Shrey-BM/Convertible-Wheelchair-to-Bed-Transfer-System/Working Photos/maker journey image.jpeg

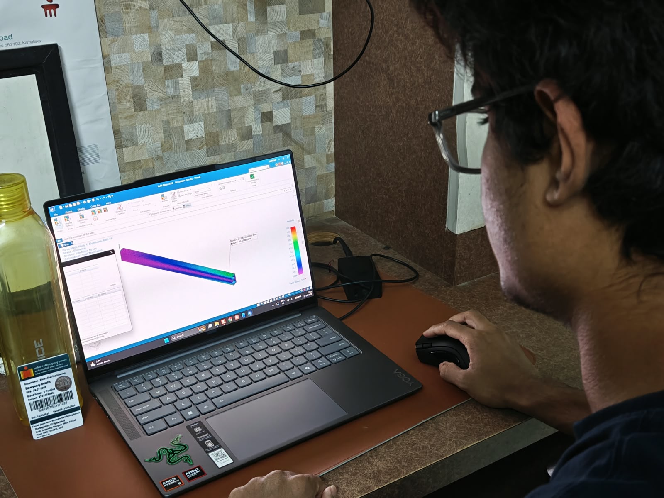
Working Photos/maker journey image.jpeg
