Shrey-BM/Convertible-Wheelchair-to-Bed-Transfer-System/System Architecture and Target Specs/target specs v3.png

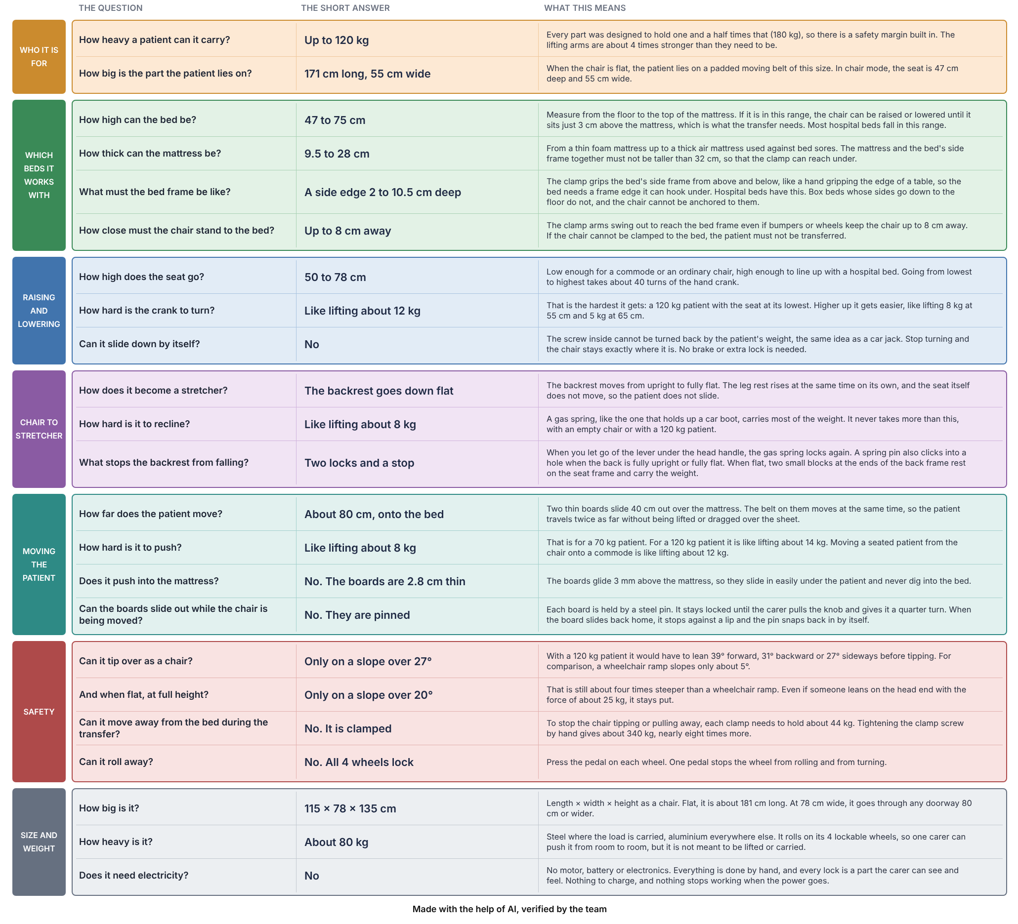
System Architecture and Target Specs/target specs v3.png
