Shrey-BM/Convertible-Wheelchair-to-Bed-Transfer-System/System Architecture and Target Specs/README.md

# System Architecture/Block Diagram
block diagram final

# Target Specifications 
target specs v3
