Shrey-BM/Convertible-Wheelchair-to-Bed-Transfer-System/References/README.md

# References

## 1. Problems with manual lifting

|  | Source | What it tells us |
|---|---|---|
| 1 | [CDC / NIOSH - Safe Patient Handling and Mobility](https://www.cdc.gov/niosh/healthcare/sphm/index.html) | Patient handling is the biggest cause of musculoskeletal injuries in healthcare workers. |
| 2 | [CDC / NIOSH - Preventing Back Injuries in Health Care Settings](https://www.cdc.gov/niosh/bulletin/2008/lifting.html) | Replacing manual lifting with transfer devices cut patient-transfer injuries by 62%. |
| 3 | [OSHA - Guidelines for Nursing Homes: Ergonomics for the Prevention of Musculoskeletal Disorders](https://osha.gov/sites/default/files/publications/final_nh_guidelines.pdf) | Manual lifting of patients should be minimised in all cases and eliminated where possible. |
| 4 | [NICE - Pressure ulcers: prevention and management (CG179)](https://www.nice.org.uk/guidance/cg179) | Dragging a patient during repositioning causes friction and shear damage to the skin. |

## 2. Similar solutions

|  | Source | What it tells us |
|---|---|---|
| 5 | [Panasonic - Resyone, a bed that turns into a wheelchair](https://news.panasonic.com/global/stories/915) | A transfer that needed two or three nurses can be done by one. This solution however needs replacement of the whole bed system. Our wheel chair can be used to transfer patients to/from standard medical beds. |
| 6 | [KosmoCare Electric Lift Patient Transfer Wheelchair](https://www.amazon.in/live/video/1795574dba7f4312b786a8775e35a151) | This solution is useful for sitting to sitting transfer only. |

## 3. Hospital beds and mattresses

|  | Source | What it tells us |
|---|---|---|
| 7 | [UNICEF Supply Catalogue - Hospital bed, standard, with mattress](https://supply.unicef.org/s0002158.html) | Standard bed: 50 cm platform height, 11-12 cm mattress, 5-7 cm frame tubes. |
| 8 | [MSF Logistics catalogue - Hospital bed, manual, adult](https://unicat.msf.org/cat/product/77026) | Manual hospital beds adjust from 45 to 84 cm in height. |
| 9 | [NHSRC - Critical Care Block equipment technical specifications](https://nhsrcindia.org/sites/default/files/2023-09/Critical%20Care%20Block-%20Equipment%20Technical%20Specification.pdf) | Indian ICU beds are 2100-2300 mm long and 900-1100 mm wide. |
| 10 | [Flexequip - Alternating-air mattress, high profile](https://www.flexequip.mndnsw.asn.au/product-library/beds-and-bed-equipment/mattress-replacement-system-alternating-air-high-profile) | Thick pressure-relief air mattresses have cells about 180 mm tall. |
| 11 | [Livingstone - ProCair alternating-pressure mattress](https://www.livingstone.com.au/products/airmatr01s-alternating-pressure-single-mattress-2000x880x200mm-200kg-ea) | A full air mattress is about 200 mm thick. |

## 4. Mechanisms

|  | Source | What it tells us |
|---|---|---|
| 12 | [Wikipedia - Scissors mechanism](https://en.wikipedia.org/wiki/Scissors_mechanism) | How a scissor lift turns a small sideways movement into a large lift. |
| 13 | [Wikipedia - Leadscrew](https://en.wikipedia.org/wiki/Leadscrew) | How a lead screw works and when it is self-locking. |
| 14 | [igus - Self-locking: what is it?](https://www.igus.eu/threaded-rod/wiki/self-locking) | Why a shallow screw thread cannot be turned back by the load. |
| 15 | [Lesjöfors - How do lockable gas springs work?](https://www.lesjofors.com/en/technology/insights/gas-spring-locking-mechanism/) | How a lockable gas spring holds its position and is released by a lever or cable. |
| 16 | [HIWIN - Linear Guideway technical catalogue](https://hiwin.com/wp-content/uploads/Linear_Guideway-E.pdf) | Sizes and load ratings of linear guides, including the MGN15 series. |
| 17 | [KHK Gears - Gear technical reference](https://khkgears.us/media/izojpong/gear_guide1.pdf) | Rack and pinion basics, tooth strength and plastic gears. |
| 18 | [Marcos Duarte - Body segment parameters](https://nbviewer.jupyter.org/github/demotu/BMC/blob/master/notebooks/BodySegmentParameters.ipynb) | How body weight is spread over the head, trunk and legs. |
