Shrey-BM/Convertible-Wheelchair-to-Bed-Transfer-System/Roadmap/README.md

# Roadmap
Roadmap
