Shrey-BM/Convertible-Wheelchair-to-Bed-Transfer-System/CAD Files/Subsystems/README.md

# ALL CAD FILES ARE AI GENERATED AND VERIFIED BY THE TEAM
