Shrey-BM/Convertible-Wheelchair-to-Bed-Transfer-System/Mechanism/Subsystem 2-Gas Spring Recliner/README.md

# Subsystem 2-Gas Spring Recliner
This is the system which helps in reclining the wheel chair and convert it to a stretcher and vice-versa.

## 3D Model
Subsystem 2-Gas Spring Recliner CAD

## Working Principle Image
Subsystem 2-Gas Spring Recliner

## Working Principle Video
[Reclining Mechanism](https://drive.google.com/file/d/1dd5fohbwBtpYMCMEX26W9-bRa6JwPkFz/view?usp=drive_link)
