Shrey-BM/Convertible-Wheelchair-to-Bed-Transfer-System/Mechanism/Subsystem 1-Scissor Lift/Subsystem 1-Scissor Lift CAD.png

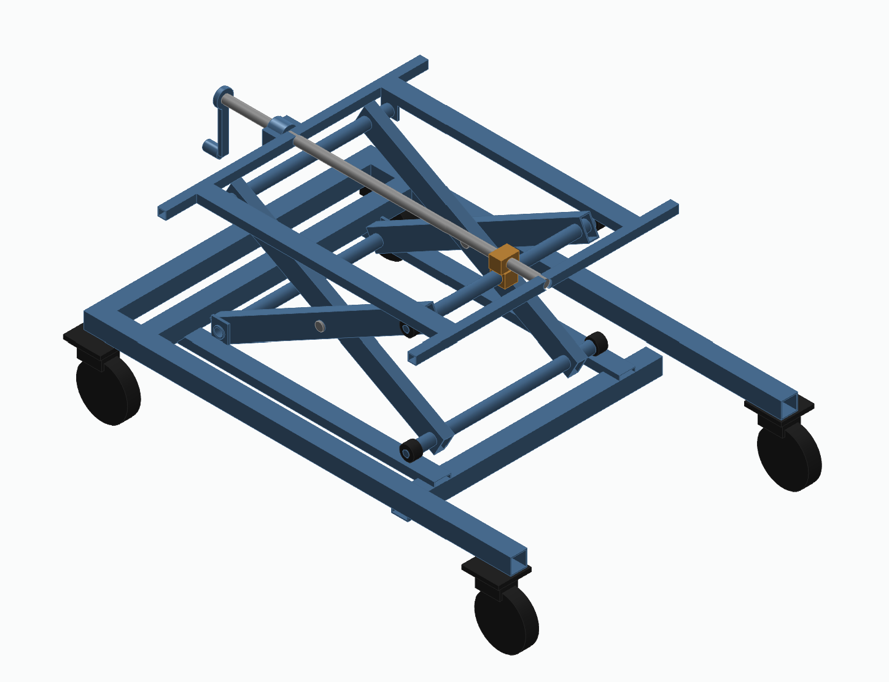
Mechanism/Subsystem 1-Scissor Lift/Subsystem 1-Scissor Lift CAD.png
