Shrey-BM/Convertible-Wheelchair-to-Bed-Transfer-System/Mechanism/Subsystem 1-Scissor Lift/Subsystem 1-Scissor Lift.jpg

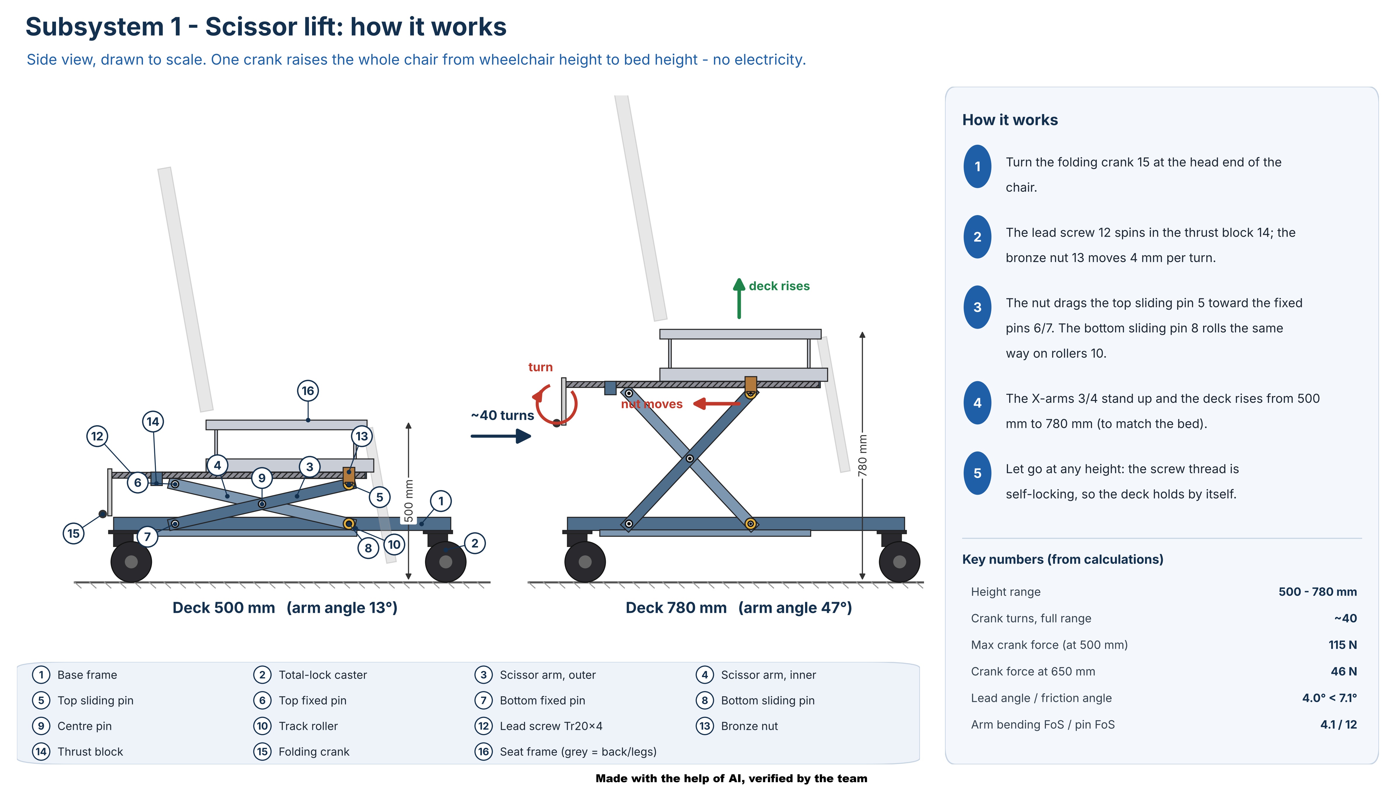
Mechanism/Subsystem 1-Scissor Lift/Subsystem 1-Scissor Lift.jpg
