Shrey-BM/Convertible-Wheelchair-to-Bed-Transfer-System/Mechanism/Subsystem 2-Gas Spring Recliner/Subsystem 2-Gas Spring Recliner CAD.png

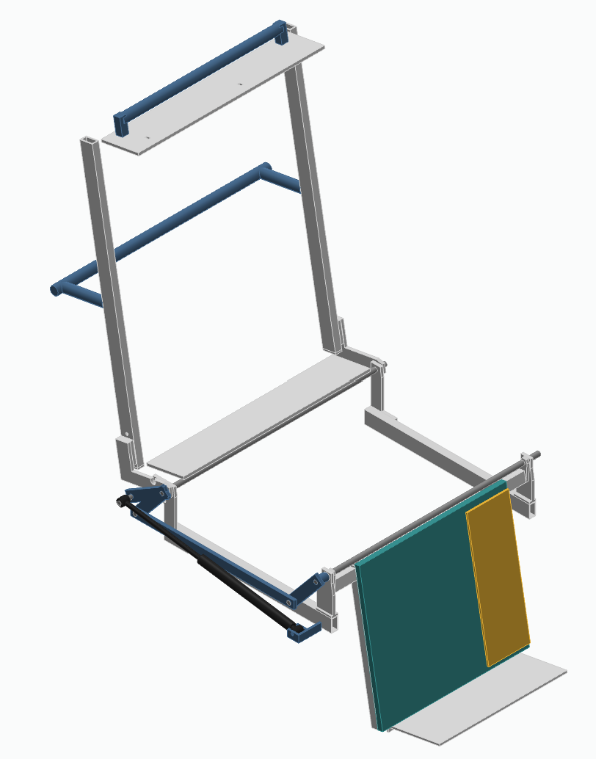
Mechanism/Subsystem 2-Gas Spring Recliner/Subsystem 2-Gas Spring Recliner CAD.png
