Shrey-BM/Convertible-Wheelchair-to-Bed-Transfer-System/Mechanism/Subsystem 2-Gas Spring Recliner/Subsystem 2-Gas Spring Recliner.jpg

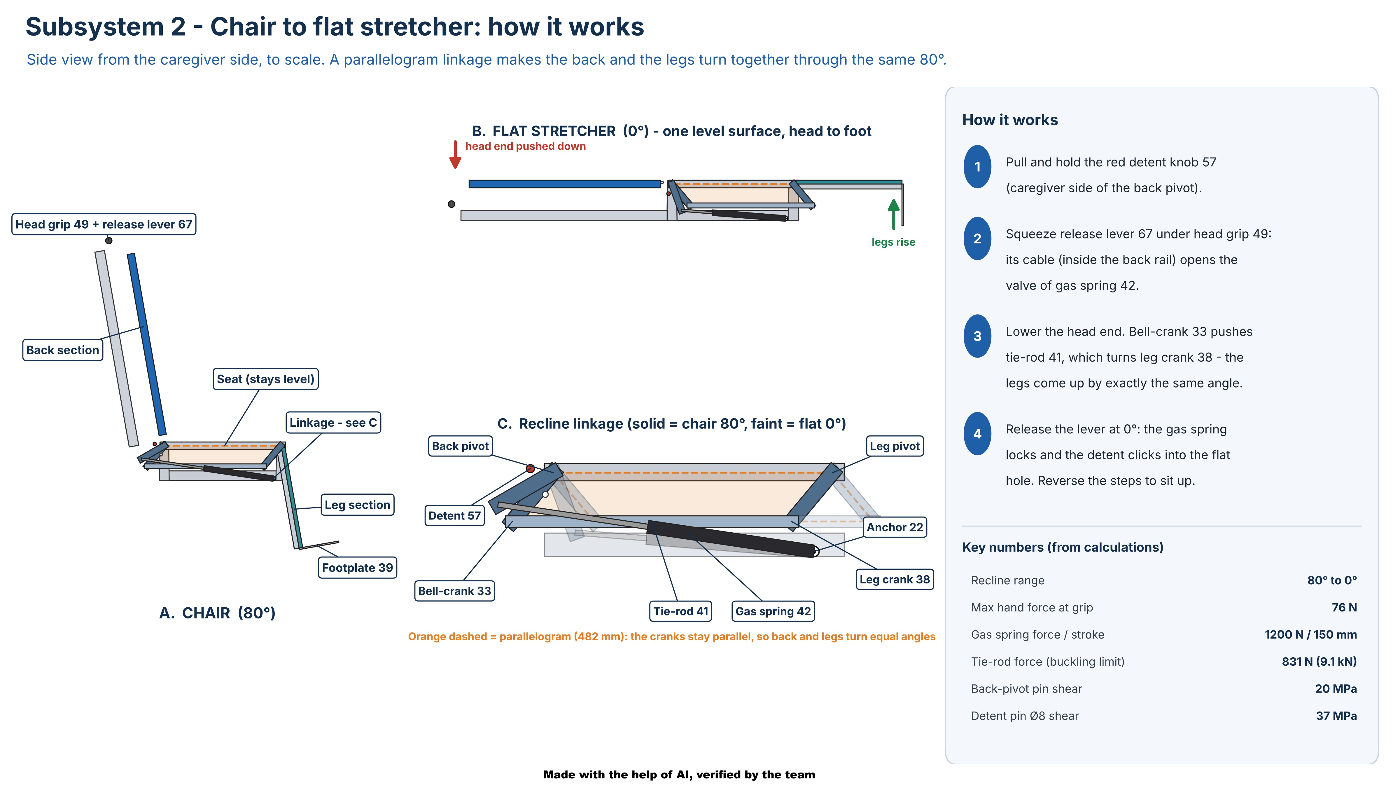
Mechanism/Subsystem 2-Gas Spring Recliner/Subsystem 2-Gas Spring Recliner.jpg
