Shrey-BM/Convertible-Wheelchair-to-Bed-Transfer-System/Mechanism/Subsystem 3-Slider/Subsystem 3-Slider CAD.png

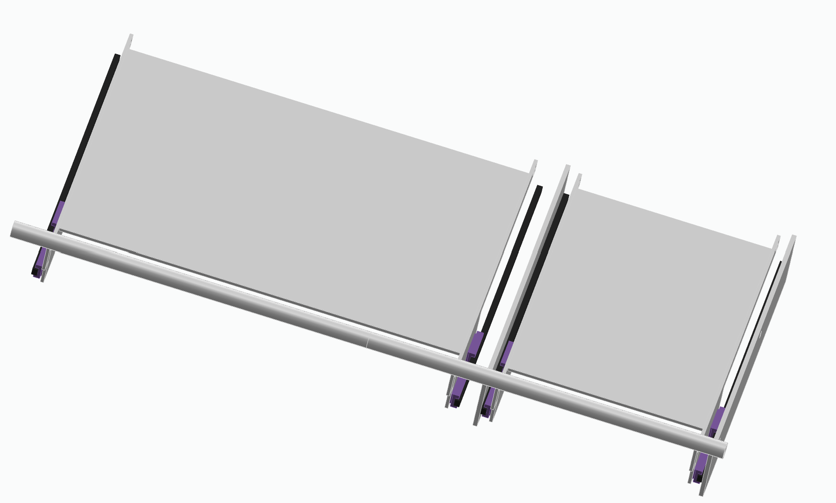
Mechanism/Subsystem 3-Slider/Subsystem 3-Slider CAD.png
