Shrey-BM/Convertible-Wheelchair-to-Bed-Transfer-System/Mechanism/Subsystem 3-Slider/Subsystem 3-Slider.jpg

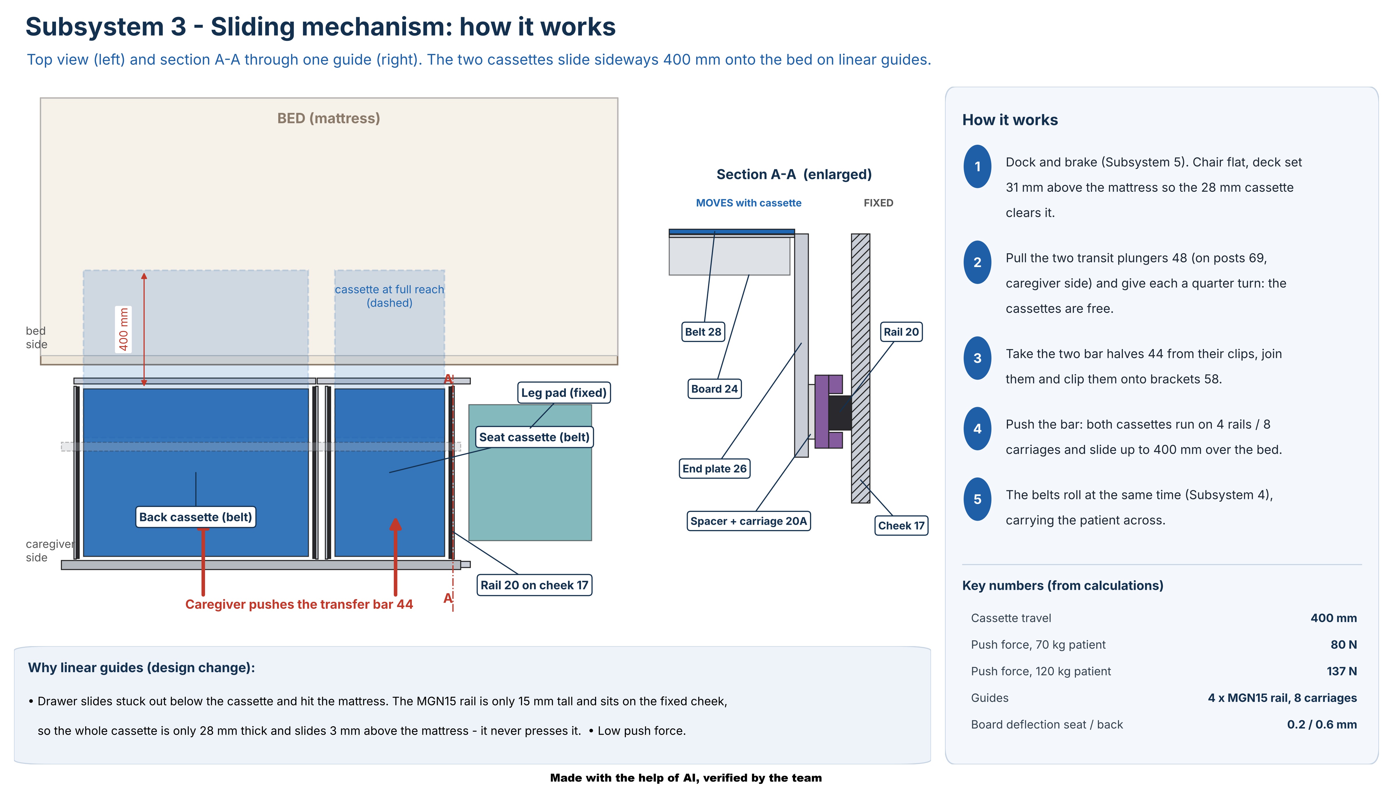
Mechanism/Subsystem 3-Slider/Subsystem 3-Slider.jpg
