Shrey-BM/Convertible-Wheelchair-to-Bed-Transfer-System/Mechanism/Subsystem 4-Roller/Subsystem 4-Roller CAD.png

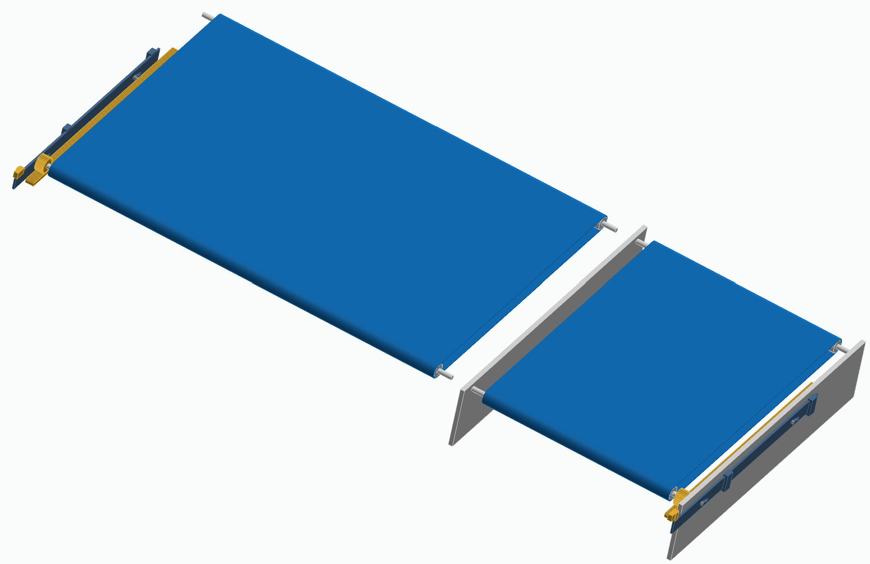
Mechanism/Subsystem 4-Roller/Subsystem 4-Roller CAD.png
