Shrey-BM/Convertible-Wheelchair-to-Bed-Transfer-System/Mechanism/Subsystem 4-Roller/Subsystem 4-Roller.jpg

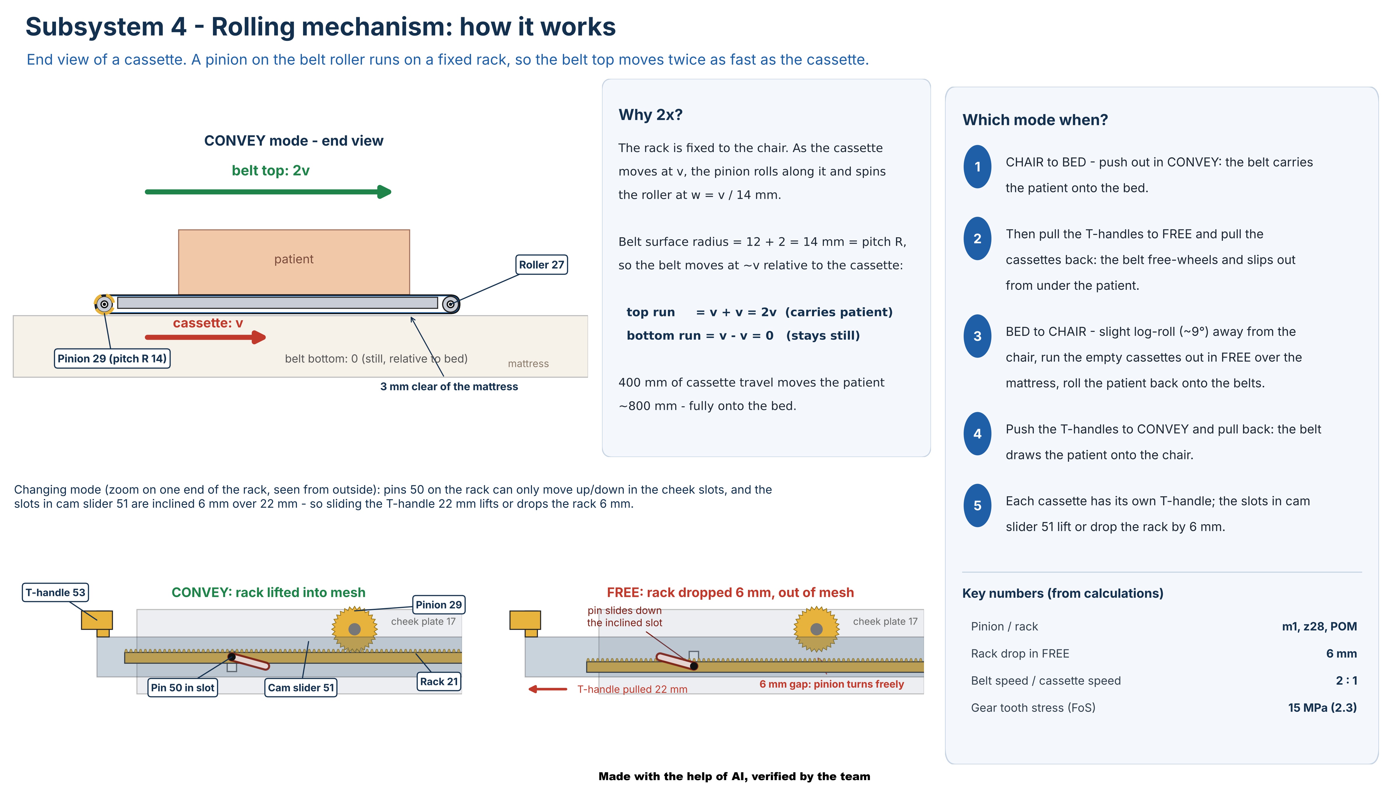
Mechanism/Subsystem 4-Roller/Subsystem 4-Roller.jpg
