Shrey-BM/Convertible-Wheelchair-to-Bed-Transfer-System/Mechanism/Subsystem 5-Docking and Safety/Subsystem 5-Docking Clamp CAD.png

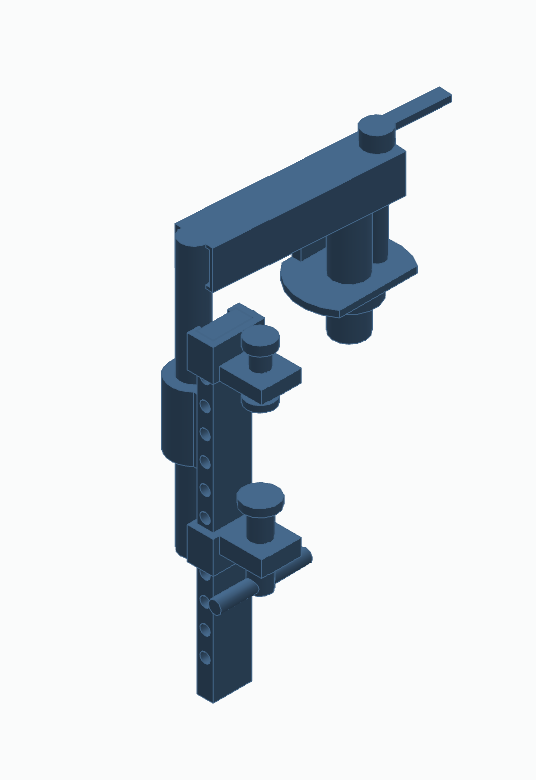
Mechanism/Subsystem 5-Docking and Safety/Subsystem 5-Docking Clamp CAD.png
