Shrey-BM/Convertible-Wheelchair-to-Bed-Transfer-System/Mechanism/Subsystem 5-Docking and Safety/Subsystem 5-Docking Clamp.jpg

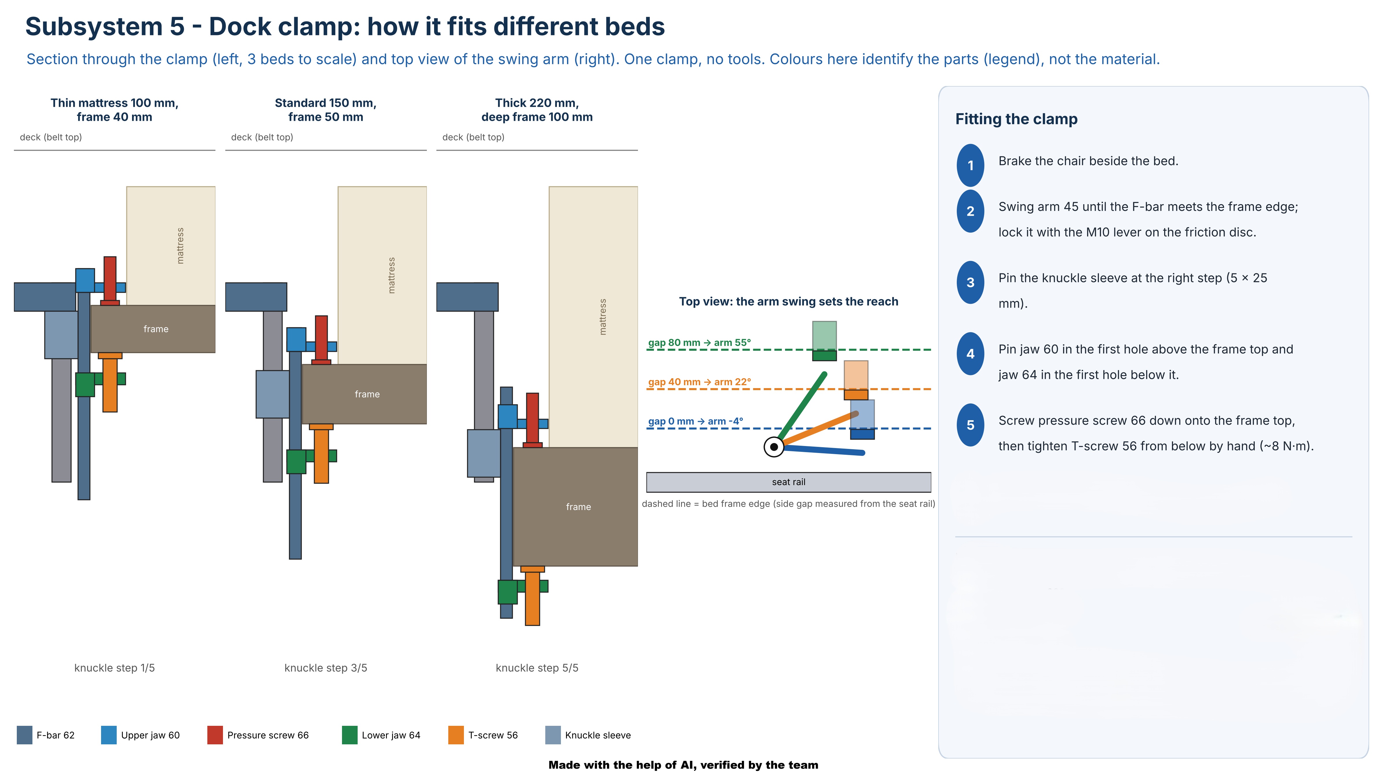
Mechanism/Subsystem 5-Docking and Safety/Subsystem 5-Docking Clamp.jpg
