Shrey-BM/Convertible-Wheelchair-to-Bed-Transfer-System/Roadmap/Roadmap.png

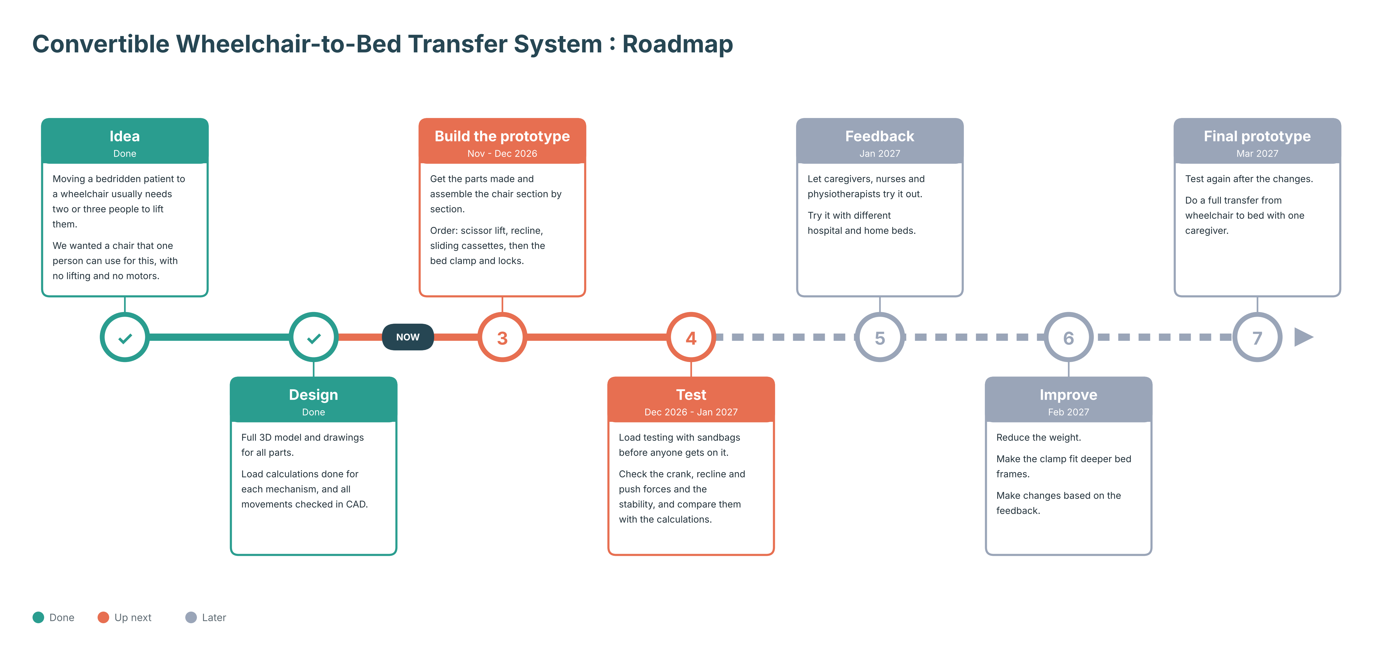
Roadmap/Roadmap.png
