Shrey-BM/Convertible-Wheelchair-to-Bed-Transfer-System/System Architecture and Target Specs/block diagram final.jpg

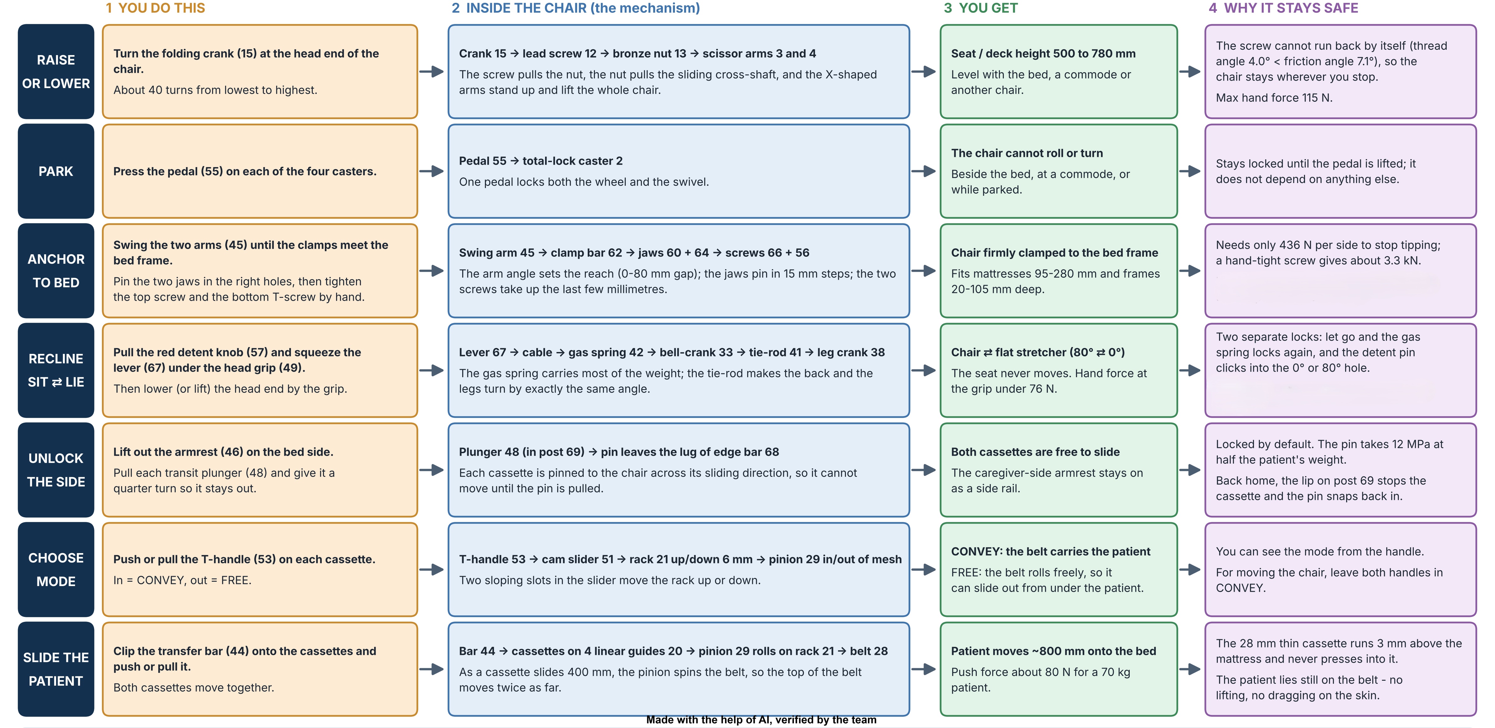
System Architecture and Target Specs/block diagram final.jpg
