Shrey-BM/Convertible-Wheelchair-to-Bed-Transfer-System/Working Photos/stress analysis image (for part 30).png

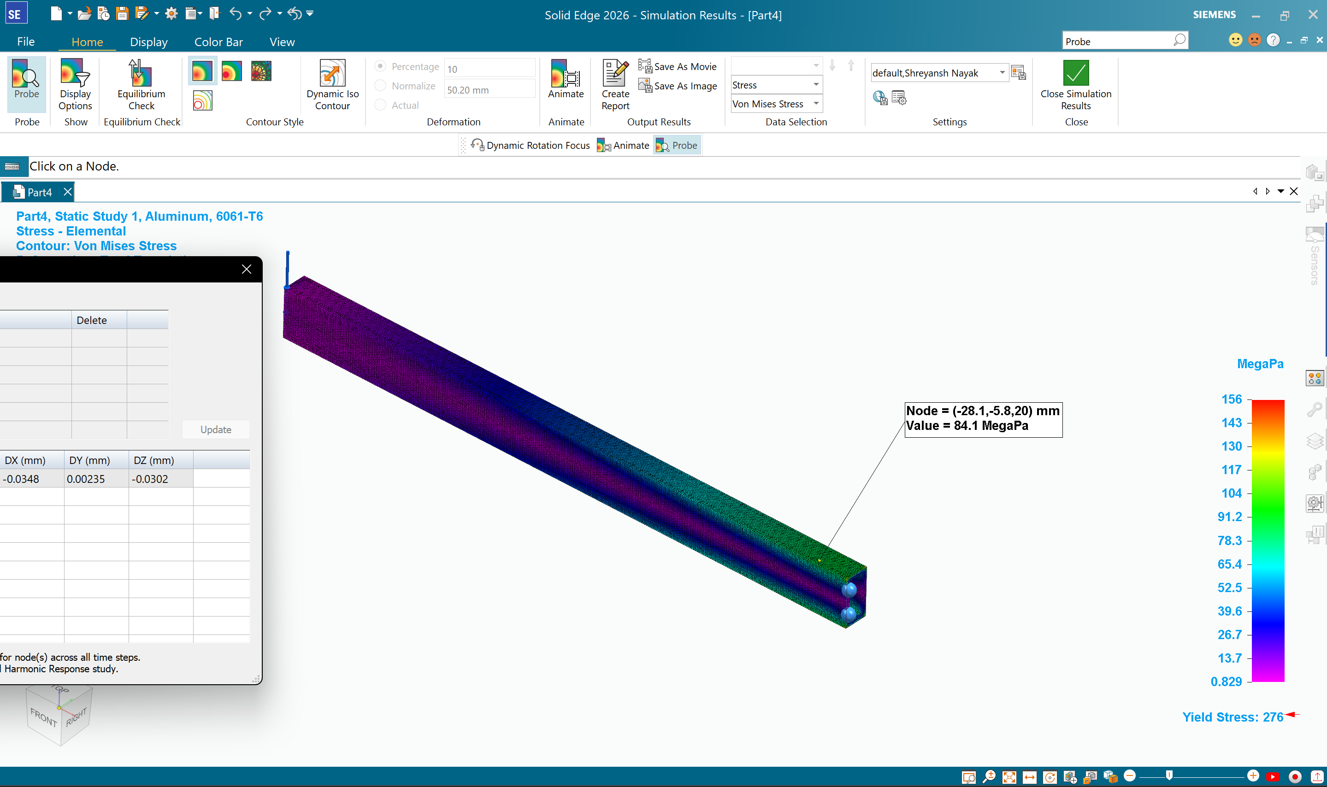
Working Photos/stress analysis image (for part 30).png
