Shrey-BM/Convertible-Wheelchair-to-Bed-Transfer-System/BOM/README.md

# Convertible Wheelchair-to-Bed Transfer System: BOM (at retail rates)

| SL | Item | Part name | Subsystem | Material / specification | Dimensions (mm) | Process | Make / Buy | Qty | Unit mass (kg) | Total mass (kg) | Unit cost (INR) | Total cost (INR) | Source |
|---:|---|---|---|---|---|---|---|---:|---:|---:|---:|---:|---|
| 1 | 1 | Base frame weldment (40x40x2.6 SHS + tracks) | 1 Scissor lift | MS IS 4923 YSt-310 SHS 40x40x2.6 + RHS 40x20x2 | Weldment, overall 1040 x 700 x 95 (frame between 110 and 205 above floor): 2 side rails SHS 40x40x2.6 x 1040 (x -300..740, y ±310..350, top 200); 2 rear cross members SHS 40x40x2.6 x 620 (at x -280 and -180); 1 dropped front cross member SHS 40x40x2.6 x 620 (x 410-450, z 110-150); 2 roller tracks RHS 40x20x2 x 650 laid flat (x -200..450, y ±205..245, top 162); 2 pivot ears plate 40 x 43 x 5 with Ø25.5 hole at z 180 (x -110) | Cut, MIG weld, powder coat | Make | 1 | 14.347 | 14.35 | 3,770 | 3,770 | Local job work: retail material + labour, incl. GST |
| 2 | 2 | Caster 125 mm total-lock swivel (TPR wheel) | 1 Scissor lift | Purchased: 125 mm total-lock swivel caster, TPR wheel | Wheel Ø125 x 32 wide (TPR), top plate 90 x 80 x 10, overall height 160, swivel offset 25; total-lock; 4 positions at (x -270 / 700, y ±345) | Bought out | Buy | 4 | 1.600 | 6.40 | 1,250 | 5,000 | Online listing (incl. GST) |
| 3 | 3 | Scissor arm - outer (50x25x2.6 RHS) | 1 Scissor lift | MS IS 4923 YSt-310 RHS 50x25x2.6 | RHS 50x25x2.6, pin c/c 550, overall length 590 (20 beyond each end pin); end holes Ø25.5 at 0 and 550 (shafts), centre hole Ø21 at 275 (pin 9); pair at y ±190.5 | Cut, drill, weld bosses | Make | 2 | 1.625 | 3.25 | 620 | 1,240 | Local job work: retail material + labour, incl. GST |
| 4 | 4 | Scissor arm - inner (50x25x2.6 RHS) | 1 Scissor lift | MS IS 4923 YSt-310 RHS 50x25x2.6 | RHS 50x25x2.6, pin c/c 550, overall length 590 (20 beyond each end pin); end holes Ø25.5 at 0 and 550 (shafts), centre hole Ø21 at 275 (pin 9); pair at y ±162.5 | Cut, drill, weld bosses | Make | 2 | 1.625 | 3.25 | 620 | 1,240 | Local job work: retail material + labour, incl. GST |
| 5 | 5 | Cross shaft - top sliding (Ø25x3) + roller stubs | 1 Scissor lift | MS tube Ø25x3 (IS 1239) + EN8 end plugs with Ø15 stubs | Tube Ø25 x 3 wall x 424 (y -212..+212) + pressed end plugs with Ø15 x 26 roller stubs (y ±212..238); overall 476; carries 2 track rollers (item 10) | Cut, turn plugs, press-fit | Make | 1 | 0.796 | 0.80 | 650 | 650 | Local job work: retail material + labour, incl. GST |
| 6 | 6 | Cross shaft - top fixed (Ø25x3) | 1 Scissor lift | MS tube Ø25x3 (IS 1239) | Tube Ø25 x 3 wall x 424 (y -212..+212) | Cut, face, drill | Make | 1 | 0.690 | 0.69 | 280 | 280 | Local job work: retail material + labour, incl. GST |
| 7 | 7 | Cross shaft - bottom fixed (Ø25x3) | 1 Scissor lift | MS tube Ø25x3 (IS 1239) | Tube Ø25 x 3 wall x 424 (y -212..+212) | Cut, face, drill | Make | 1 | 0.690 | 0.69 | 280 | 280 | Local job work: retail material + labour, incl. GST |
| 8 | 8 | Cross shaft - bottom sliding (Ø25x3) + roller stubs | 1 Scissor lift | MS tube Ø25x3 (IS 1239) + EN8 end plugs with Ø15 stubs | Tube Ø25 x 3 wall x 424 (y -212..+212) + pressed end plugs with Ø15 x 26 roller stubs (y ±212..238); overall 476; carries 2 track rollers (item 10) | Cut, turn plugs, press-fit | Make | 1 | 0.796 | 0.80 | 650 | 650 | Local job work: retail material + labour, incl. GST |
| 9 | 9 | Centre pin Ø20 + circlips | 1 Scissor lift | EN8 (080M40) Ø20 + circlips | Pin Ø20 x 63 (y 145..208 each side), 2 circlip grooves for DIN 471 Ø20 circlips | Turn, groove | Make | 2 | 0.155 | 0.31 | 200 | 400 | Local job work: retail material + labour, incl. GST |
| 10 | 10 | Track roller = 2 x 6202-2RS bearings (Ø35 x 22) | 1 Scissor lift | Purchased: 2 x 6202-2RS deep-groove bearings per roller | 2 x 6202-2RS (Ø15 bore x Ø35 OD x 11) side by side = roller Ø35 x 22 on the Ø15 stub of shaft 5 / 8 (y ±214..236); outer races run on the track | Bought out | Buy | 4 | 0.090 | 0.36 | 310 | 1,240 | Online listing (incl. GST) |
| 11 | 11 | Lift top frame weldment (40x20x2 RHS) | 1 Scissor lift | MS IS 4923 YSt-310 RHS 40x20x2 + SHS 20x20x2 cross members | Weldment, overall 630 x 640 x 53 (frame 20 deep + ears hanging 33 below): 2 tracks RHS 40x20x2 x 630 (x -150..480, y ±205..245, deck -180..-160); 2 cross members SHS 20x20x2 x 640 (at x -150..-130 and 460..480), each with a Ø21 hole for the lead screw (axis deck -170); 2 hanger ears plate 40 x 33 x 5 with Ø25.5 hole at deck -198 (x -110) | Cut, MIG weld, powder coat | Make | 1 | 3.585 | 3.59 | 1,570 | 1,570 | Local job work: retail material + labour, incl. GST |
| 12 | 12 | Lead screw Tr20x4 (single start, self-locking) | 1 Scissor lift | EN8 / C45, Tr20x4 single start, thread cut on a lathe (or bought rolled) | Tr20x4 single start, Ø20 x 780 (x -305..475), axis at deck -170; Ø20 journal in the thrust block (x -185..-150), free end runs in the Ø21 hole of the front cross member | Turned + thread-cut - local | Make | 1 | 1.600 | 1.60 | 1,280 | 1,280 | Local job work: retail material + labour, incl. GST |
| 13 | 13 | Nut block Tr20x4 (LTB2 bronze nut) | 1 Scissor lift | Phosphor bronze LTB2 nut in MS block with shaft lug | Overall 36 x 44 x 61: nut body 30 x 44 x 30 with Tr20x4 bronze nut (axis deck -170) + lug 36 x 32 x 31 below it with Ø25.5 bore round sliding shaft 5 (axis deck -198) | Turn + mill, bore | Make | 1 | 0.389 | 0.39 | 1,380 | 1,380 | Local job work: retail material + labour, incl. GST |
| 14 | 14 | Thrust bearing block (51104 + 6004) | 1 Scissor lift | MS block + 51104 thrust + 6004 bearings | Block 35 x 60 x 40 (x -185..-150, deck -200..-160) + bearing housing Ø42 OD / Ø20 bore protruding 11 above (overall 35 x 60 x 51); holds 51104 thrust (20 x 35 x 10) + 6004 (20 x 42 x 12) | Mill, bore | Make | 1 | 0.652 | 0.65 | 1,220 | 1,220 | Local job work: retail material + labour, incl. GST |
| 15 | 15 | Folding crank handle R120 | 1 Scissor lift | MS 8 mm + nylon grip | Hub Ø40 x 10 on screw end; arm 120 long (radius) x 16 x 10; grip Ø22 x 35 nylon; folding hinge | Laser-cut, weld | Make | 1 | 0.240 | 0.24 | 890 | 890 | Local job work: retail material + labour, incl. GST |
| 16 | 16 | Seat side rail 40x20x2 RHS (Al) | Seat frame (common) | Al 6061-T6 RHS 40x20x2 | Al RHS 40 (tall) x 20 x 2 wall x 517 (x -15..502); y ±300..320; deck -160..-120 | Cut, drill | Make | 2 | 0.313 | 0.63 | 450 | 900 | Local job work: retail material + labour, incl. GST |
| 17 | 17 | Seat cheek plate 8 mm (guide-rail + rack carrier) | Seat frame (common) | Al 6061-T6 plate 8 mm | Al plate 8 x 584 x 118 (y -292..292, deck -120..-2); 2 per seat at x 12-20 and 440-448; front plate (x 440-448) has 2 slots 6 x 13 for rack pins (y -230 and +60, deck -41.5..-28.5); MGN15 rail bolted on inner face | Laser/waterjet cut, drill, tap | Make | 2 | 1.487 | 2.97 | 1,670 | 3,340 | Local job work: retail material + labour, incl. GST |
| 18 | 18 | Back pivot bracket 8 mm | Seat frame (common) | Al 6061-T6 plate 8 mm (2 detent holes on caregiver side) | Al plate 8 mm: bed side 75 x 157 envelope (x -15..60); caregiver side 110 x 157 (x -50..60); pivot hole Ø12 at (0, deck -16); caregiver side adds 2 detent holes Ø8.4 on R40 at -110° and -190° | Laser/waterjet cut, ream | Make | 2 | 0.163 | 0.33 | 420 | 840 | Local job work: retail material + labour, incl. GST |
| 19 | 19 | Leg pivot bracket 8 mm | Seat frame (common) | Al 6061-T6 plate 8 mm | Al plate 8 mm, 50 x 111 (x 452..502, deck -114..-3, y ±308..316), pivot hole Ø21 (hub bush) at (482, deck -16); welded foot 50 x 20 x 6 sitting on the seat-rail top (2 x M6) | Laser/waterjet cut, ream | Make | 2 | 0.111 | 0.22 | 500 | 1,000 | Local job work: retail material + labour, incl. GST |
| 20 | 20 | Linear guide rail MGN15 x 580 | 3 Sliding | Purchased: MGN15 rail, bearing steel, cut to 580 | MGN15 rail 15 wide x 10 high x 580 long, M3 mounting holes at 40 pitch (bolted to item 17/31 at deck -88..-73) | Bought out | Buy | 4 | 0.560 | 2.24 | 2,100 | 8,400 | Online listing (incl. GST) |
| 21 | 20A | Linear guide carriage MGN15H + 3 mm spacer | 3 Sliding | Purchased: MGN15H carriage + 3 mm Al spacer | MGN15H carriage (catalogue 34 W x 61.4 L, rail + block height 16; CAD envelope 32 x 58) + Al spacer 50 x 24 x 3; 2 per end plate, centres y -258 / -145 | Bought out | Buy | 8 | 0.200 | 1.60 | 650 | 5,200 | Online listing (incl. GST) |
| 22 | 21 | Rack m1 x 470 (16 face), drops 6 mm in FREE | 4 Rolling | Acetal (POM) rack m1, 16 face | POM rack m1 x 470 long x 16 face width x 8 high (y -300..170, pitch line at deck -28.3 = 0.3 mm backlash); 2 Ø5 holes for guide pins 50 at y -230 / +60 (deck -32); drops 6 mm in FREE | Bought out, cut to 470 | Buy | 2 | 0.069 | 0.14 | 600 | 1,200 | Estimate, Indian supplier (no reliable online listing) |
| 23 | 22 | Gas spring anchor bracket | Seat frame (common) | MS 5 mm clevis, zinc plated + Ø8 pin | Clevis, MS 5: 2 cheeks 30 x 21 x 5 (x 435..465, y -391..-386 and -364..-359, deck -167..-146) with Ø8 pin holes at (450, deck -152), 22 gap for the gas-spring eye; back/mounting plate 5 x 71 x 21 (x 465..470, y -391..-320) welded on, bolted to the seat-rail side face; pin Ø8 x 32 | Laser-cut, weld, drill | Make | 1 | 0.104 | 0.10 | 450 | 450 | Local job work: retail material + labour, incl. GST |
| 24 | 23 | Armrest socket Ø24 tube | Seat frame (common) | MS tube Ø24 x 2.5 wall (bore 19 for the Ø18 armrest spigot) | Tube Ø24 x 2.5 wall x 100 (deck -160..-60), at x 100 / 360, y ±335 | Cut, weld to rail | Make | 4 | 0.133 | 0.53 | 160 | 640 | Local job work: retail material + labour, incl. GST |
| 25 | 24 | Cassette board - seat (370 long, 18 mm Al ladder + PTFE skin) | 3 Sliding | Al 6061-T6 18 mm ladder (25x16.5x1.5 ribs) + PTFE-glass skin | 370 x 484 x 17.8 overall: Al skin 1.3 x 370 x 484 + PTFE-glass tape; 5 ribs RHS 25 x 16.5 x 1.5 x 370 at 110 pitch (y -220, -110, 0, 110, 220); top at deck -2.2 | Cut, rivet, tape | Make | 1 | 1.206 | 1.21 | 2,060 | 2,060 | Local job work: retail material + labour, incl. GST |
| 26 | 25 | Cassette board - back (760 long, 18 mm Al ladder + PTFE skin) | 3 Sliding | Al 6061-T6 18 mm ladder (25x16.5x1.5 ribs) + PTFE-glass skin | 760 x 484 x 17.8 overall: Al skin 1.3 x 760 x 484 + PTFE-glass tape; 5 ribs RHS 25 x 16.5 x 1.5 x 760 at 110 pitch; top at deck -2.2 | Cut, rivet, tape | Make | 1 | 2.476 | 2.48 | 3,770 | 3,770 | Local job work: retail material + labour, incl. GST |
| 27 | 26 | Cassette end plate 6 mm (deep near end, 28 mm slim nose) | 3 Sliding | Al 6061-T6 plate 6 mm (deep end + 28 mm slim nose) | Al plate 6 mm, 570 x 98 envelope: deep part 190 x 98 (y -290..-100, carries the carriages) + slim nose 380 x 28 (y -100..280, under the bed side); 2 bearing bores Ø16 for 688-2RS at y ±262, deck -14; bar bracket 58 bolted to its -Y end; edge bar 68 runs between the two brackets 58 | Laser/waterjet cut, bore bearing seats | Make | 4 | 0.468 | 1.87 | 880 | 3,520 | Local job work: retail material + labour, incl. GST |
| 28 | 27 | Belt roller Ø24 x 366 + Ø8 stub axles (688-2RS) | 4 Rolling | Al tube Ø24x1.5 + EN8 Ø8 stub axles + 688-2RS | Al tube Ø24 x 1.5 wall x 366; pressed end plugs Ø21 x 20 each end; EN8 stub axles Ø8 x 45 each end (27 beyond the tube end, overall 420); runs in 2 x 688-2RS bearings (item 27A) in the Ø16 bores of end plates 26 - tube and axles turn together; axis at deck -14 | Turn, press-fit | Make | 2 | 0.149 | 0.30 | 570 | 1,140 | Local job work: retail material + labour, incl. GST |
| 29 | 27 | Belt roller Ø24 x 756 + Ø8 stub axles (688-2RS) | 4 Rolling | Al tube Ø24x1.5 + EN8 Ø8 stub axles + 688-2RS | Al tube Ø24 x 1.5 wall x 756; pressed end plugs Ø21 x 20 each end; EN8 stub axles Ø8 x 45 each end (27 beyond the tube end, overall 810); runs in 2 x 688-2RS bearings (item 27A) in the Ø16 bores of end plates 26 - tube and axles turn together; axis at deck -14 | Turn, press-fit | Make | 2 | 0.261 | 0.52 | 640 | 1,280 | Local job work: retail material + labour, incl. GST |
| 30 | 27A | Ball bearing 688-2RS (8 x 16 x 5) for belt rollers 27 | 4 Rolling | Purchased: 688-2RS deep-groove ball bearing, sealed both sides | 688-2RS: bore 8, OD 16, width 5, rubber seals both sides; 2 per roller (one each end), seated in the Ø16 bores of end plates 26; 4 rollers = 8 bearings | Bought out | Buy | 8 | 0.003 | 0.02 | 80 | 640 | Online listing (incl. GST) |
| 31 | 28 | Conveyor belt back, endless, 2 mm PU/polyester | 4 Rolling | PU-covered polyester, 2 mm, endless splice | Endless belt, width 756, thickness 2, loop length ≈ 1130 on the mean line (2 x 524 straight + π x 26); roller c/c 524 (y ±262) | Bought out | Buy | 1 | 2.050 | 2.05 | 5,000 | 5,000 | Estimate, Indian supplier (no reliable online listing) |
| 32 | 28 | Conveyor belt seat, endless, 2 mm PU/polyester | 4 Rolling | PU-covered polyester, 2 mm, endless splice | Endless belt, width 366, thickness 2, loop length ≈ 1130 on the mean line (2 x 524 straight + π x 26); roller c/c 524 (y ±262) | Bought out | Buy | 1 | 0.992 | 0.99 | 4,000 | 4,000 | Estimate, Indian supplier (no reliable online listing) |
| 33 | 29 | Pinion m1 z28, 16 face, keyed to roller | 4 Rolling | Acetal (POM) m1 z28, 16 face | POM spur gear m1, z28, PCD 28, OD 30, face 16, bore Ø8 + grub screw on the Ø8 roller stub; on the near roller at the rack end, outside the end plate | Bought out, bore Dia8 + grub screw | Buy | 2 | 0.012 | 0.02 | 350 | 700 | Estimate, Indian supplier (no reliable online listing) |
| 34 | 30 | Back side rail 40x20x3 RHS (Al) | 2 Chair-to-flat | Al 6061-T6 RHS 40x20x3 | Al RHS 40 (tall) x 20 x 3 wall x 818 (x -838..-20 in flat mode); y ±300..320; caregiver side: release cable inside, Ø8 exit hole at x -100 (deck -140) | Cut, drill | Make | 2 | 0.715 | 1.43 | 720 | 1,440 | Local job work: retail material + labour, incl. GST |
| 35 | 31 | Back cheek plate 8 mm | 2 Chair-to-flat | Al 6061-T6 plate 8 mm | Al plate 8 x 584 x 118 (y -292..292, deck -120..-2); 2 per back section at x -20..-12 and -838..-830 (flat); head-end plate has 2 rack-pin slots 6 x 13 (y -230, +60); MGN15 rail bolted on inner face | Laser/waterjet cut | Make | 2 | 1.487 | 2.97 | 1,670 | 3,340 | Local job work: retail material + labour, incl. GST |
| 36 | 32 | Back pivot plate 8 mm + spacer | 2 Chair-to-flat | Al 6061-T6 plate 8 mm + spacer | Al plate 8 mm, 103 x 157 envelope (x -90..13, y ±330..338), pivot hole Ø12 at (0, deck -16); caregiver-side plate adds an M16x1.5 tapped hole for detent 57 on R40 at -110°; spacer block 60 x 10 x 38 to the rail | Laser/waterjet cut | Make | 2 | 0.224 | 0.45 | 680 | 1,360 | Local job work: retail material + labour, incl. GST |
| 37 | 33 | Back bell-crank R110 (tie-rod + gas-spring pins) | 2 Chair-to-flat | MS plate 8 mm + EN8 hub | MS plate 8: two arms 30 wide x 140 long (R110 c/c + 15 each end) at -50° and -70° (flat mode); hub Ø24 x 12 bored Ø12 + key; 3 holes Ø12 | Laser-cut, weld, ream | Make | 1 | 0.409 | 0.41 | 790 | 790 | Local job work: retail material + labour, incl. GST |
| 38 | 34 | Push handle U-bar Ø25 (transport) | 2 Chair-to-flat | MS tube Ø25, powder coat | Bent tube Ø25: 2 uprights x 140 (deck -160..-300) at y ±310 + cross bar x 670 (y -335..335) at x -420 | Bend, weld | Make | 1 | 1.080 | 1.08 | 510 | 510 | Local job work: retail material + labour, incl. GST |
| 39 | 35 | Leg pad 15 mm (Al honeycomb panel, PTFE vinyl top) | 2 Chair-to-flat | Al honeycomb 15 mm panel + PTFE vinyl | Al honeycomb panel 420 x 460 x 15 (x 492..912), PTFE vinyl top | Bought out, cut | Buy | 1 | 0.782 | 0.78 | 1,350 | 1,350 | Estimate, Indian supplier (no reliable online listing) |
| 40 | 36 | Leg side tube 20x20x1.5 (Al) | 2 Chair-to-flat | Al 6061-T6 SHS 20x20x1.5 | Al SHS 20 x 20 x 1.5 x 415 (x 497..912), y ±210..230 | Cut, drill | Make | 2 | 0.124 | 0.25 | 210 | 420 | Local job work: retail material + labour, incl. GST |
| 41 | 37 | Leg pivot plate 8 mm + hinge connector | 2 Chair-to-flat | Al 6061-T6 plate 8 mm + hinge connector | Al plate 8 mm, 63 x 32 envelope with pivot hole Ø12 at (482, deck -16) + connector block 30 x 70 x 20 to the leg tube | Laser/waterjet cut | Make | 2 | 0.140 | 0.28 | 480 | 960 | Local job work: retail material + labour, incl. GST |
| 42 | 38 | Leg crank arm R110 (keyed to pivot) | 2 Chair-to-flat | MS plate 8 mm + EN8 hub | MS plate 8: arm 30 wide x 140 long (R110 c/c + 15 each end) at -50° (flat) + hub Ø20 x 42 bored Ø12 + key on the leg pivot pin; tip hole Ø12 | Laser-cut, weld, ream | Make | 1 | 0.303 | 0.30 | 690 | 690 | Local job work: retail material + labour, incl. GST |
| 43 | 39 | Flip footplate (folds down in flat mode) | 2 Chair-to-flat | Al 6061 sheet 6 mm + grip tape | Al plate 6 mm: 400 wide x 165 high footplate + 20 x 400 x 5 toe lip, grip tape; hinge axis at x 915, deck -18 (folds under the leg pad in flat mode) | Cut, bend | Make | 1 | 1.177 | 1.18 | 1,540 | 1,540 | Local job work: retail material + labour, incl. GST |
| 44 | 40 | Bridge flap 130 mm, folds over pad (bed side) | 2 Chair-to-flat | UHMW-PE 5 mm | UHMW-PE 5 x 390 x 130 (x 510..900); hinged, folds over the leg pad | Cut, hinge | Make | 1 | 0.238 | 0.24 | 670 | 670 | Local job work: retail material + labour, incl. GST |
| 45 | 41 | Tie rod 25x8 flat, c/c 482 (parallelogram link) | 2 Chair-to-flat | MS flat 25x8 | MS flat 25 x 8, c/c 482, overall 512 (15 beyond each hole); 2 holes Ø12 | Cut, drill, ream | Make | 1 | 0.790 | 0.79 | 350 | 350 | Local job work: retail material + labour, incl. GST |
| 46 | 42 | Lockable gas spring 1200 N, stroke 150, ext. length 560 (Bloc-O-Lift type) | 2 Chair-to-flat | Purchased: lockable gas spring 1200 N, stroke 150 | Lockable gas spring: body Ø22 x 290, rod Ø10, extended length 560 eye-to-eye, stroke 150 (works 414-551), F1 = 1200 N; eye ends Ø20 x 22, bores Ø8 (anchor end) and Ø12 (crank end) | Bought out | Buy | 1 | 0.750 | 0.75 | 3,500 | 3,500 | Online listing (incl. GST) |
| 47 | 43 | Linkage pins Ø12 (crank tips) | 2 Chair-to-flat | EN8 / SS304 shoulder bolts Ø12 | Ø12 pins: 2 x Ø12 x 24 (tie-rod ends) + 1 x Ø12 x 48 (gas-spring eye); circlip grooves both ends | Bought out / turn | Buy | 3 | 0.028 | 0.09 | 140 | 420 | Local job work: retail material + labour, incl. GST |
| 48 | 43 | Pivot pin Ø12 (back), shoulder bolt | 2 Chair-to-flat | EN8 / SS304 shoulder bolts Ø12 | Ø12 x 700 shoulder bolt / through-pin (y -350..+350), at back pivot (x 0, deck -16) | Bought out / turn | Buy | 1 | 0.622 | 0.62 | 320 | 320 | Local job work: retail material + labour, incl. GST |
| 49 | 43 | Pivot pin Ø12 (leg), shoulder bolt | 2 Chair-to-flat | EN8 / SS304 shoulder bolts Ø12 | Ø12 x 700 shoulder bolt / through-pin (y -350..+350), at leg pivot (x 482, deck -16) | Bought out / turn | Buy | 1 | 0.622 | 0.62 | 320 | 320 | Local job work: retail material + labour, incl. GST |
| 50 | 44 | Transfer bar half, Ø30 x 675 (fitted, joined by spigot) | 3 Sliding | Al 6061-T6 tube Ø30x3 + spigot | Al tube Ø30 x 3 wall x 675 (each half); spigot Ø24 x 60 joins the halves; total fitted length 1350 | Cut, turn spigot | Make | 2 | 0.464 | 0.93 | 560 | 1,120 | Local job work: retail material + labour, incl. GST |
| 51 | 45 | Swing-reach dock arm 25x25 SHS, L90, M10 lock lever (any angle sets reach 0-80 mm) | 5 Safety &amp; anchoring | MS SHS 25x25x2 (standard) arm L90 + EN8 pivot &amp; knuckle pins + M10 lock lever | SHS 25 x 25 x 2 arm, pivot-to-knuckle 90 (deck -136..-112), pivot at x 200 / 460, y 346; pivot pin Ø20 x 93 (deck -205..-112); knuckle pin Ø16 x 168 (deck -112..-280) with 5 cross-holes at 25 pitch for the sleeve; 22 mm tail behind the pivot carrying an M10 lock screw at 16 mm, bearing on the friction disc, with lever 40 x 8 x 4; buy standard SHS 25 x 25 x 2 (the CAD tube is 24 tall, leaving 1 mm above the knuckle sleeve) | Cut, weld, turn, cross-drill | Make | 2 | 0.699 | 1.40 | 870 | 1,740 | Local job work: retail material + labour, incl. GST |
| 52 | 46 | Removable armrest (drop-in pins) | 5 Safety &amp; anchoring | MS tube Ø22 + Ø18 spigots + PU pad | 2 uprights tube Ø22 x 1.6 x 269 (deck -60..209) with Ø18 x 90 drop-in spigots into sockets 23; top tube Ø25.4 x 1.6 x 300 at deck 220; PU pad 280 x 60 x 20; top at deck 252 | Bend, weld, turn, mould pad | Make | 2 | 1.270 | 2.54 | 1,170 | 2,340 | Local job work: retail material + labour, incl. GST |
| 53 | 47 | Knee filler strip, PTFE faced | Seat frame (common) | UHMW-PE 6 mm, PTFE faced | UHMW-PE 30 x 560 x 6 (x 448..478), PTFE faced | Cut | Make | 1 | 0.095 | 0.09 | 410 | 410 | Local job work: retail material + labour, incl. GST |
| 54 | 48 | Transit-lock index plunger, pin Ø8, M16x1.5 body (GN 617.1 type) | 5 Safety &amp; anchoring | Purchased: indexing plunger GN 617.1 type, Ø8 hardened steel pin, M16x1.5 body (stainless -NI version optional) | GN 617.1-type indexing plunger with rest position: pin Ø8, body M16x1.5 x 22, knob Ø21 x 10; screwed into lock post 69, pin points along -X (across the slide) into the Ø8.5 hole of edge-bar lug 68, engaged 10 mm, stroke 12; pull + quarter turn holds it out; axis y -333, deck -21; seat at x 222..254, back at x -478..-446 (flat) | Bought out | Buy | 2 | 0.080 | 0.16 | 1,000 | 2,000 | Online listing (incl. GST) |
| 55 | 49 | Head-end grip bar Ø25 (recline grip + recline release lever) | 2 Chair-to-flat | MS tube Ø25, powder coat | Tube Ø25 x 500 (y -250..250) + 2 brackets 49 x 20 x 20; lever 67 clamped at y -228 | Bend, weld | Make | 1 | 0.810 | 0.81 | 460 | 460 | Local job work: retail material + labour, incl. GST |
| 56 | 50 | Rack guide pin Ø5 (2 per rack, run in cheek slots) | 4 Rolling | EN8 / SS304 Ø5 pins | Pin Ø5 x 32 (EN8 / SS304); 2 per rack, 2 racks = 4 pins | Turn | Make | 4 | 0.005 | 0.02 | 70 | 280 | Local job work: retail material + labour, incl. GST |
| 57 | 51 | Cam slider bar 3.5 mm, 2 inclined slots | 4 Rolling | MS plate 3.5 mm, zinc plated, 2 inclined slots | MS plate 3.5 x 458 x 26 (y -318..140), 2 inclined slots Ø6 wide, 22 long x 6 drop (at y -230 and +60) | Laser-cut | Make | 2 | 0.318 | 0.64 | 230 | 460 | Local job work: retail material + labour, incl. GST |
| 58 | 52 | Slider keeper (2 per slider, riveted to cheek) | 4 Rolling | MS strip 2 mm | MS strip 2 mm bent U-channel 9 deep x 34 high x 16 wide; 2 per slider, 2 sliders = 4 keepers, riveted | Bend, rivet | Make | 4 | 0.025 | 0.10 | 80 | 320 | Local job work: retail material + labour, incl. GST |
| 59 | 53 | Mode T-handle: push = CONVEY, pull = FREE | 4 Rolling | Nylon over MS | Stem 3.5 x 8 x 17 on the slider end (y -318..-310) + grip bar 8 x 20 x 12 along Y (y -328..-308, deck -14..-2); pull 22 mm = FREE | Moulded / bought | Make | 2 | 0.017 | 0.03 | 150 | 300 | Local job work: retail material + labour, incl. GST |
| 60 | 54 | Bar storage clip (spring steel) | 5 Safety &amp; anchoring | Spring steel 1.5 mm | Spring steel 1.5 strip 20 wide, clip envelope 43 deep x 68 high, 2 per back section at x -250 / -650 | Laser-cut, bend, harden | Make | 2 | 0.050 | 0.10 | 130 | 260 | Local job work: retail material + labour, incl. GST |
| 61 | 55 | Caster total-lock brake pedal (part of caster) | 5 Safety &amp; anchoring | Purchased (part of caster) | Pedal 36 x 18 x 8 + tab 14 x 24 x 4 (envelope 36 x 24 x 12) on the caster (included with item 2) | - | Buy | 4 | 0.000 | 0.00 | 0 | 0 | Included with caster |
| 62 | 56 | Clamp T-screw M12 + swivel pad | 5 Safety &amp; anchoring | MS / SS304 M12 T-screw + swivel pad | M12 T-screw, shank 45 + swivel pad Ø20 x 5, tommy bar Ø8 x 56 near the lower end; runs in the M12 hole of lower jaw 64 | Bought out | Buy | 2 | 0.070 | 0.14 | 350 | 700 | Standard clamp screw, Indian supplier (incl. GST) |
| 63 | 57 | Recline detent plunger Ø8 pin (locks at 0 and 80 deg) | 5 Safety &amp; anchoring | Purchased: indexing plunger GN 617 type, Ø8 hardened steel pin, M16x1.5 body (stainless -NI version optional) | GN 617-type: pin Ø8, body M16x1.5 x 22 in plate 32, knob Ø20 x 8; R40 at -110° from the back pivot; stroke 12 | Bought out | Buy | 1 | 0.080 | 0.08 | 1,000 | 1,000 | Online listing (incl. GST) |
| 64 | 58 | Bar clip-on bracket (on end-plate tab) | 3 Sliding | Al 6061-T6 bracket | Al plate 6 mm: tab 28 x 38 + hook 12 x 32 with R15 seat for the bar, bolted to the -Y end of each end plate (y -318..-290); edge bar 68 bolts to its inner face | Laser-cut, bend | Make | 4 | 0.021 | 0.08 | 100 | 400 | Local job work: retail material + labour, incl. GST |
| 65 | 59 | Dock-arm pivot lug + friction disc, bolted to seat rail | 5 Safety &amp; anchoring | MS 6 mm lug + friction disc, bolted to Al seat rail (2 x M6 + backing strip) | Block 20 x 26 x 12 (y 320..346) + boss Ø32 x 12 (bore Ø20.6) + bolt tab 20 x 6 x 25 (2 x Ø6.4 for M6 through-bolts); friction disc Ø60 x 4 (flat at y 364) for the arm lock screw | Laser-cut, weld lug/disc, drill | Make | 2 | 0.117 | 0.23 | 450 | 900 | Local job work: retail material + labour, incl. GST |
| 66 | 60 | Upper jaw, sliding on F-bar, index pin (15 mm steps) | 5 Safety &amp; anchoring | MS 8 mm sliding upper jaw + spring index pin | C-collar 32 x 16 x 20 (inner 25 x 11, open toward the knuckle) + tongue 24 x 26 x 8 with M10 tapped hole for pressure screw 66; spring index pin Ø6 x 34.5 + knob Ø12 x 2.5 | Laser-cut, weld | Make | 2 | 0.075 | 0.15 | 430 | 860 | Local job work: retail material + labour, incl. GST |
| 67 | 62 | Clamp F-bar 24x10 + knuckle sleeve (swivels; UP/DOWN on knuckle pin) | 5 Safety &amp; anchoring | MS flat 24x10 F-bar (15 mm holes) + knuckle sleeve tube | Flat bar 24 x 10 x 195 with 12 holes Ø6.4 at 15 pitch (first 8 below the top); knuckle sleeve tube Ø28 x 5.5 wall x 40 (bore 17) + web 20 x 6 x 40; sleeve top at deck -136 / -161 / -186 / -211 / -236 | Cut, drill, weld | Make | 2 | 0.425 | 0.85 | 520 | 1,040 | Local job work: retail material + labour, incl. GST |
| 68 | 64 | Lower jaw, sliding on F-bar, index pin (15 mm steps) | 5 Safety &amp; anchoring | MS 10 mm sliding lower jaw + spring index pin | C-collar 32 x 16 x 20 (inner 25 x 11) + tongue 24 x 26 x 10 with M12 tapped hole for T-screw 56; spring index pin Ø6 x 34.5 + knob Ø12 x 2.5 | Laser-cut, weld | Make | 2 | 0.081 | 0.16 | 450 | 900 | Local job work: retail material + labour, incl. GST |
| 69 | 65 | Recline 0 deg hard-stop plug (back-rail end) | 2 Chair-to-flat | Al 6061-T6 plug, head 5 x 20 x 40 + spigot | Head 5 x 20 x 40 (x -20..-15, y ±300..320, deck -160..-120) + spigot 20 x 14 x 34 into the rail end; 1 x M5 rivet | Saw, mill, press-fit + 1 x M5 rivet | Make | 2 | 0.036 | 0.07 | 220 | 440 | Local job work: retail material + labour, incl. GST |
| 70 | 66 | Upper-jaw pressure screw M10 + pad (closes the gap onto the frame top) | 5 Safety &amp; anchoring | MS / SS304 M10 pressure screw + pad | M10 pressure screw: pad Ø16 x 4 + shank Ø10 x 26 + head Ø16 x 6 (32 above the pad); closes the 4-18 mm gap between upper jaw 60 and the frame top | Bought out | Buy | 2 | 0.032 | 0.06 | 200 | 400 | Standard clamp screw, Indian supplier (incl. GST) |
| 71 | 67 | Gas-spring remote release kit: lever on grip 49 + Bowden cable + release head | 5 Safety &amp; anchoring | Purchased: gas-spring remote release kit (lever + Bowden cable + release head) | Kit: squeeze lever on grip 49 (clamp ring Ø34 x 12 at y -228..-216, hinge block 12 x 14 x 21, blade 90 x 12 x 6, turns 8°); Bowden cable Ø5 x 1250 (lever -&gt; open head end of the caregiver-side back rail 30 -&gt; inside the rail -&gt; Ø8 exit hole at x -100 -&gt; free loop in the plane y -392 -&gt; head); release head Ø18 x 30 screwed on the gas-spring rod end, presses the rod's release pin | Bought out | Buy | 1 | 0.200 | 0.20 | 1,500 | 1,500 | Estimate, Indian supplier (no reliable online listing) |
| 72 | 68 | Transit-lock edge bar + lug, back cassette | 5 Safety &amp; anchoring | Al 6061-T6 flat 22x12 + lug block | Al flat 22 (high) x 12 x 760 (x -805..-45 flat, y -318..-306, deck -32..-10) bolted between the two end-plate tabs + lug block 20 x 25 x 22 at x -500..-480 (y -343..-318) with Ø8.5 hole along X at (y -333, deck -21) | Cut, mill, drill | Make | 1 | 0.568 | 0.57 | 710 | 710 | Local job work: retail material + labour, incl. GST |
| 73 | 68 | Transit-lock edge bar + lug, seat cassette | 5 Safety &amp; anchoring | Al 6061-T6 flat 22x12 + lug block | Al flat 22 (high) x 12 x 370 (x 45..415, y -318..-306, deck -32..-10) bolted between the two end-plate tabs + lug block 20 x 25 x 22 at x 200..220 (y -343..-318) with Ø8.5 hole along X at (y -333, deck -21) | Cut, mill, drill | Make | 1 | 0.290 | 0.29 | 520 | 520 | Local job work: retail material + labour, incl. GST |
| 74 | 69 | Transit-lock post (on side rail, with home-stop lip) | 5 Safety &amp; anchoring | Al 6061-T6 block | Al block: head 16 x 35 x 30 (y -355..-320, deck -36..-6) with M16x1.5 tapped hole along X at (y -333, deck -21) + leg 16 x 10 x 124 (deck -160..-36) bolted to the side-rail outer face (2 x M6) + home-stop lip 22 x 2 x 30 (y -347..-345, 2 mm in front of the lug); seat post at x 222..238 on rail 16, back post at x -478..-462 on rail 30 (flat) | Mill, drill, tap M16x1.5 | Make | 2 | 0.094 | 0.19 | 480 | 960 | Local job work: retail material + labour, incl. GST |
| 75 | C | Fasteners (SS/zinc), circlips, bushes, PTFE tape, paint, Loctite | All | Fasteners SS/zinc, circlips, bushes, PTFE tape, paint, Loctite | Kit: M5-M12 SS/zinc fasteners, DIN 471/472 circlips, PTFE tape 0.13 x 25, paint, Loctite 243 | - | Buy | 1 | 1.500 | 1.50 | 2,700 | 2,700 | Estimate, Indian supplier (no reliable online listing) |
|  |  | **TOTAL** |  |  |  |  |  | **149** |  | **79.2** |  | **105,870** |  |

*We used AI to find the mass of the parts and also to estimate the price of some parts which we could not find*
