Shrey-BM/Convertible-Wheelchair-to-Bed-Transfer-System/More pics + Exploded views (with materials and specs)/README.md

# Contains 3D pics of the modes of the wheel chair and also the part wise labelled exploded view with materials and specs for each part

## Subsystems Map
Subsystems Map

## Side view-Wheel Chair Mode
Side view-Wheel Chair Mode

## Front view-Wheel Chair Mode
Front view-Wheel Chair Mode

## Side view-Stretcher Mode
Side view-Stretcher Mode

## Extended view-Stretcher Mode
Extended view-Stretcher Mode

## Subsystem 1-Scissor Lift-Exploded
Subsystem 1-Scissor Lift-Exploded

## Subsystem 2-Gas Spring Recliner-Exploded
Subsystem 2-Gas Spring Recliner-Exploded

## Subsystem 3-Slider-Exploded
Subsystem 3-Slider-Exploded

## Subsystem 4-Roller-Exploded
Subsystem 4-Roller-Exploded

## Subsystem 5-Safety Components-Exploded
Subsystem 5-Safety Components 1-Exploded
Subsystem 5-Safety Components 2-Exploded
