Shrey-BM/Convertible-Wheelchair-to-Bed-Transfer-System/More pics + Exploded views (with materials and specs)/Front view-Wheel Chair Mode.jpg

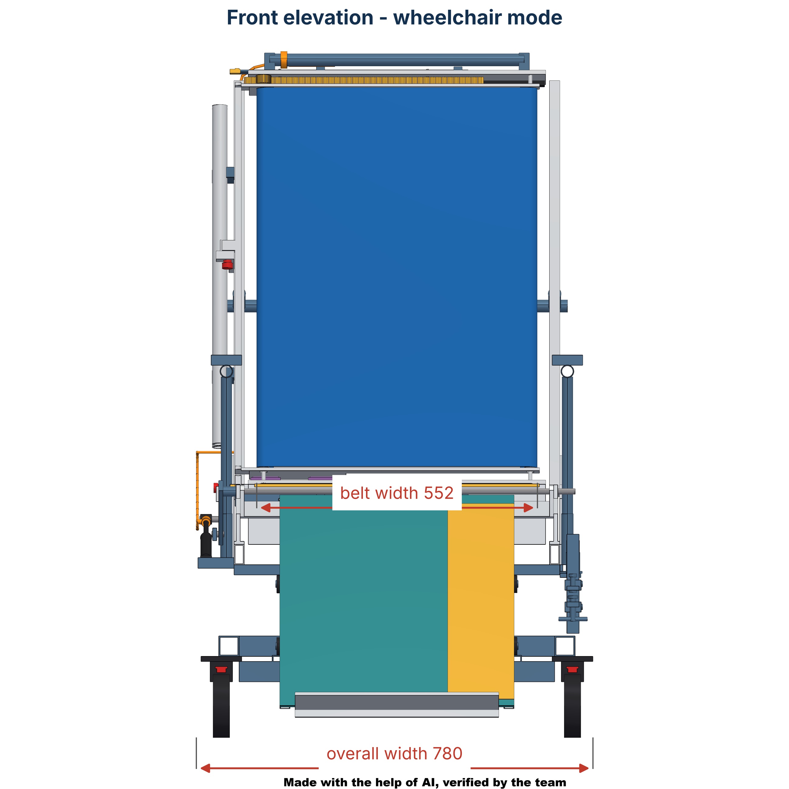
More pics + Exploded views (with materials and specs)/Front view-Wheel Chair Mode.jpg
