Shrey-BM/Convertible-Wheelchair-to-Bed-Transfer-System/More pics + Exploded views (with materials and specs)/Side view-Stretcher Mode.jpg

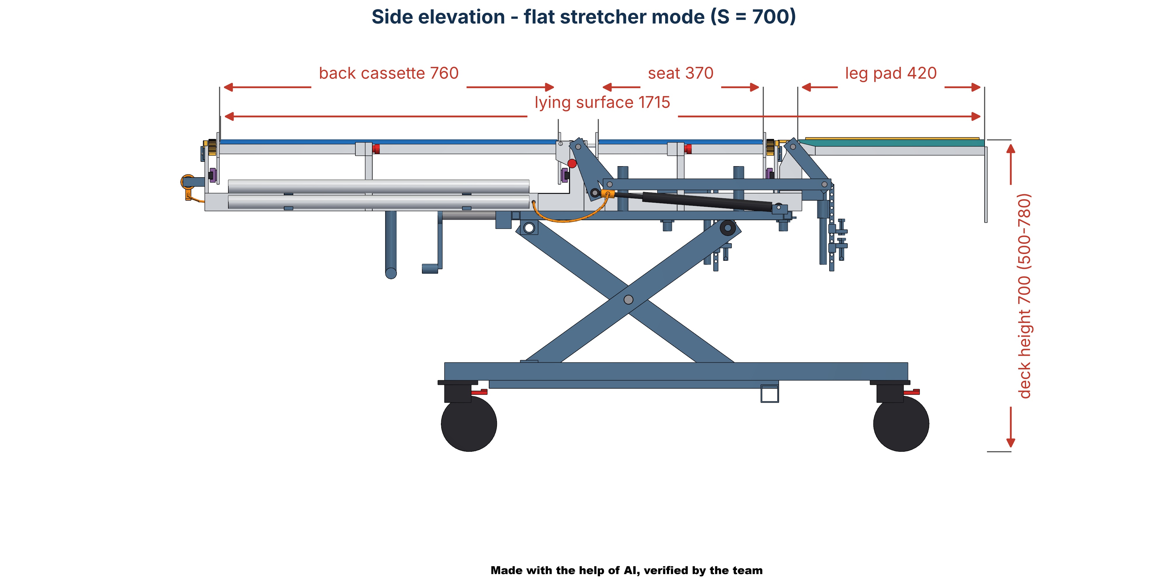
More pics + Exploded views (with materials and specs)/Side view-Stretcher Mode.jpg
