Shrey-BM/Convertible-Wheelchair-to-Bed-Transfer-System/More pics + Exploded views (with materials and specs)/Subsystem 2-Gas Spring Recliner-Exploded.jpg

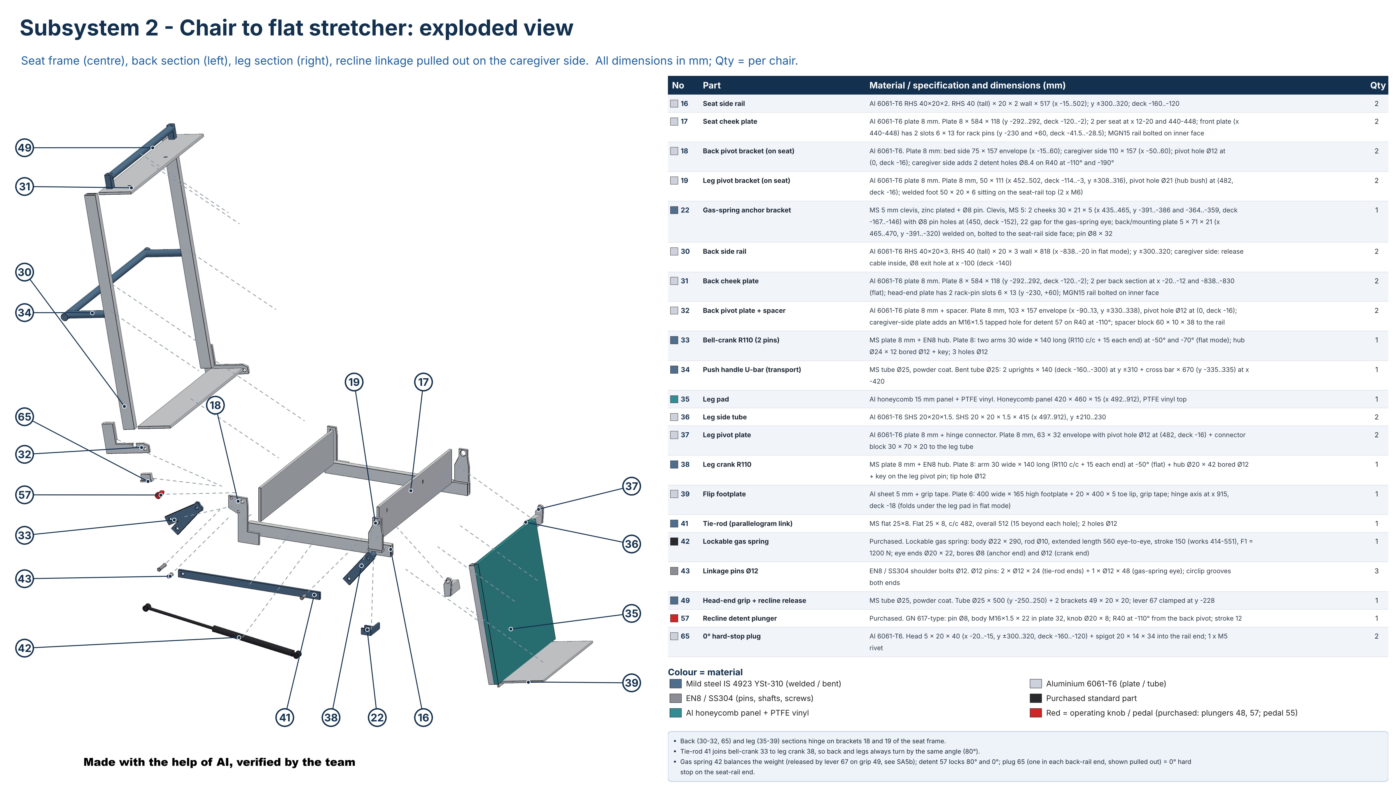
More pics + Exploded views (with materials and specs)/Subsystem 2-Gas Spring Recliner-Exploded.jpg
