Shrey-BM/Convertible-Wheelchair-to-Bed-Transfer-System/More pics + Exploded views (with materials and specs)/Subsystem 3-Slider-Exploded.jpg

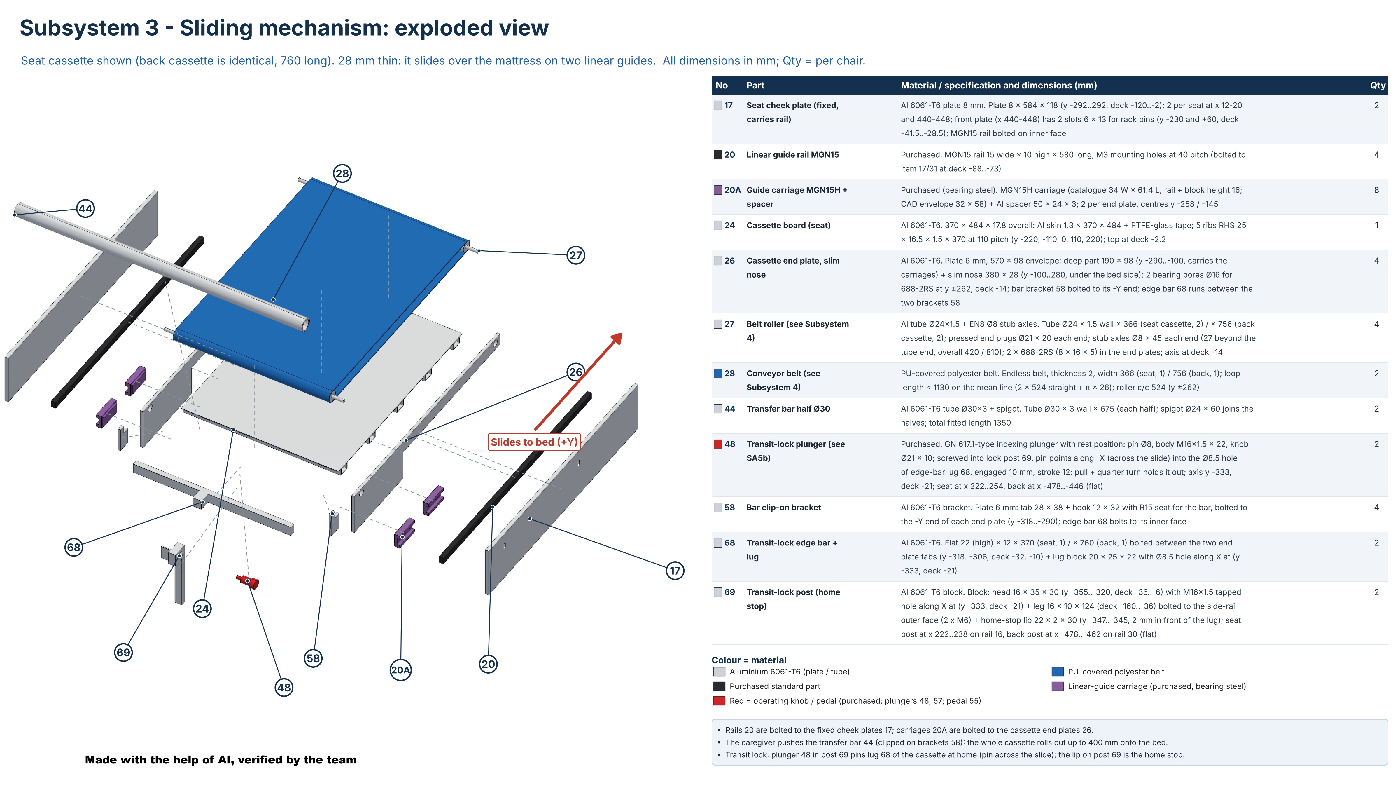
More pics + Exploded views (with materials and specs)/Subsystem 3-Slider-Exploded.jpg
