Shrey-BM/Convertible-Wheelchair-to-Bed-Transfer-System/More pics + Exploded views (with materials and specs)/Subsystem 4-Roller-Exploded.jpg

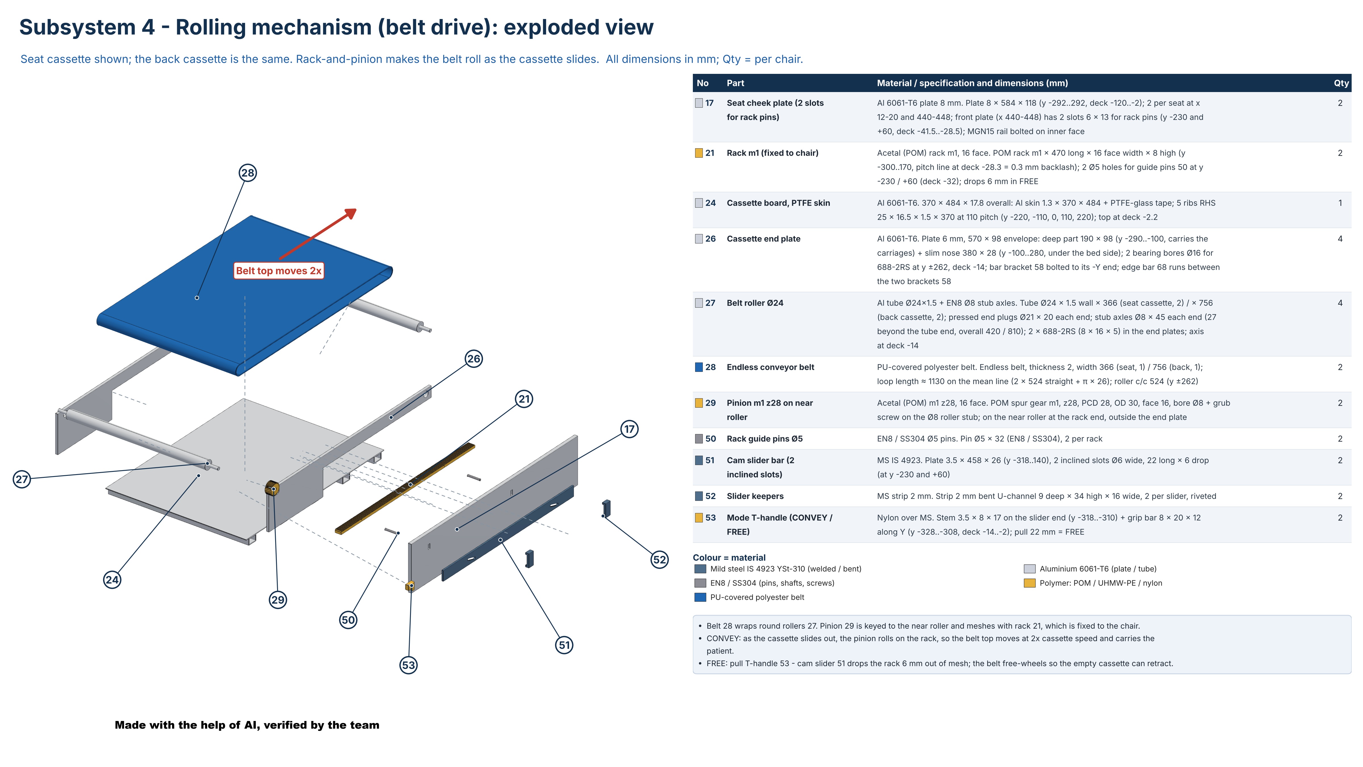
More pics + Exploded views (with materials and specs)/Subsystem 4-Roller-Exploded.jpg
