Shrey-BM/Convertible-Wheelchair-to-Bed-Transfer-System/More pics + Exploded views (with materials and specs)/Subsystem 5-Safety Components 1-Exploded.jpg

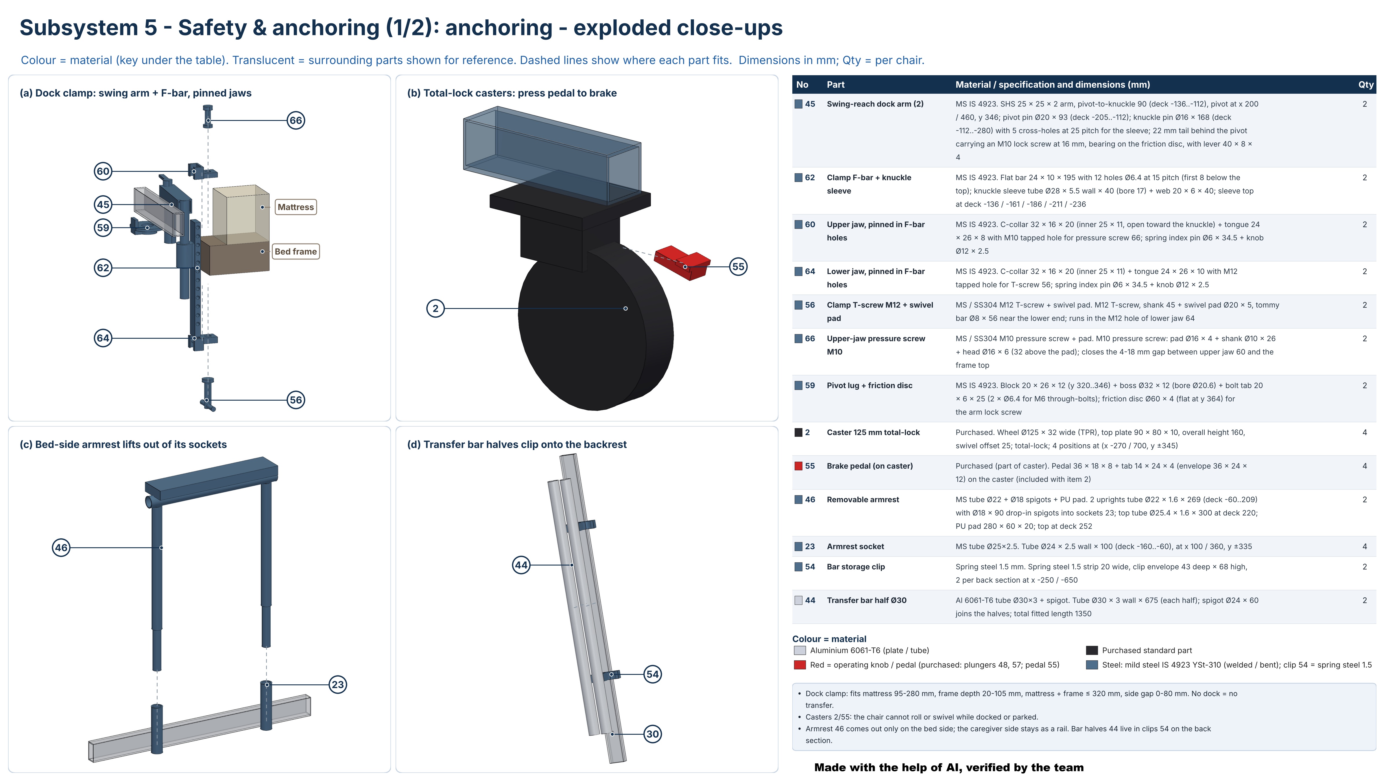
More pics + Exploded views (with materials and specs)/Subsystem 5-Safety Components 1-Exploded.jpg
