Shrey-BM/Convertible-Wheelchair-to-Bed-Transfer-System/More pics + Exploded views (with materials and specs)/Subsystem 5-Safety Components 2-Exploded.jpg

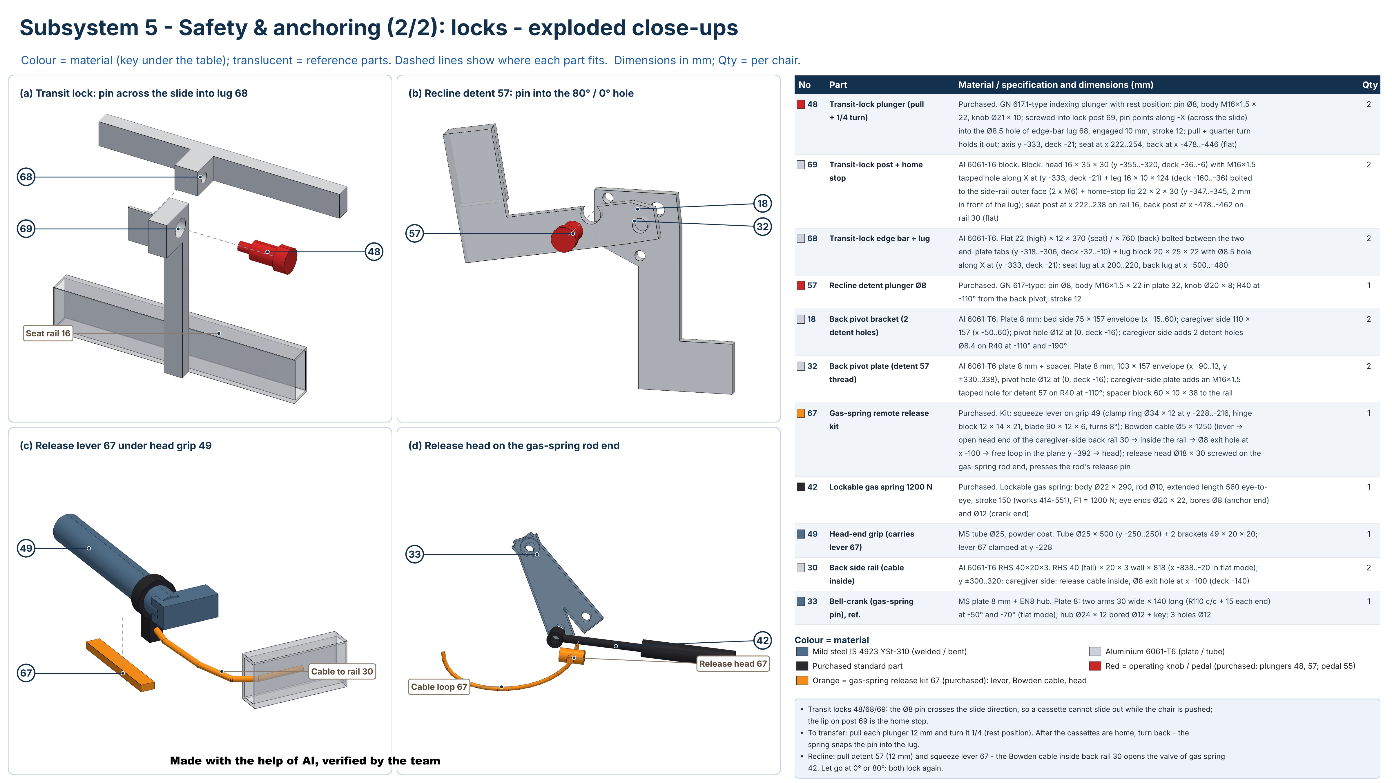
More pics + Exploded views (with materials and specs)/Subsystem 5-Safety Components 2-Exploded.jpg
