Shrey-BM/Convertible-Wheelchair-to-Bed-Transfer-System/More pics + Exploded views (with materials and specs)/Subsystems Map.jpg

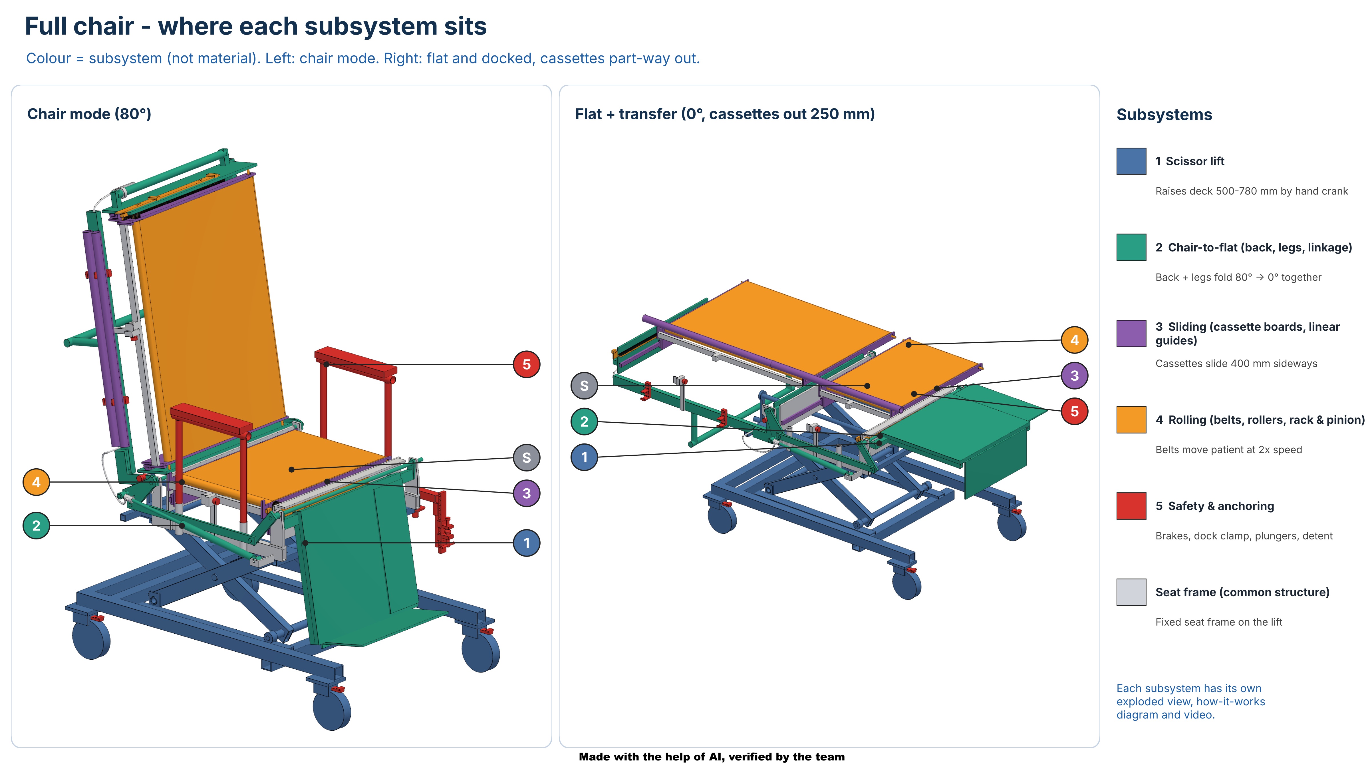
More pics + Exploded views (with materials and specs)/Subsystems Map.jpg
