Shrey-BM/Convertible-Wheelchair-to-Bed-Transfer-System/CAD Files/Assemblies/WCB_ASM_1_Wheelchair_mode_S500.step

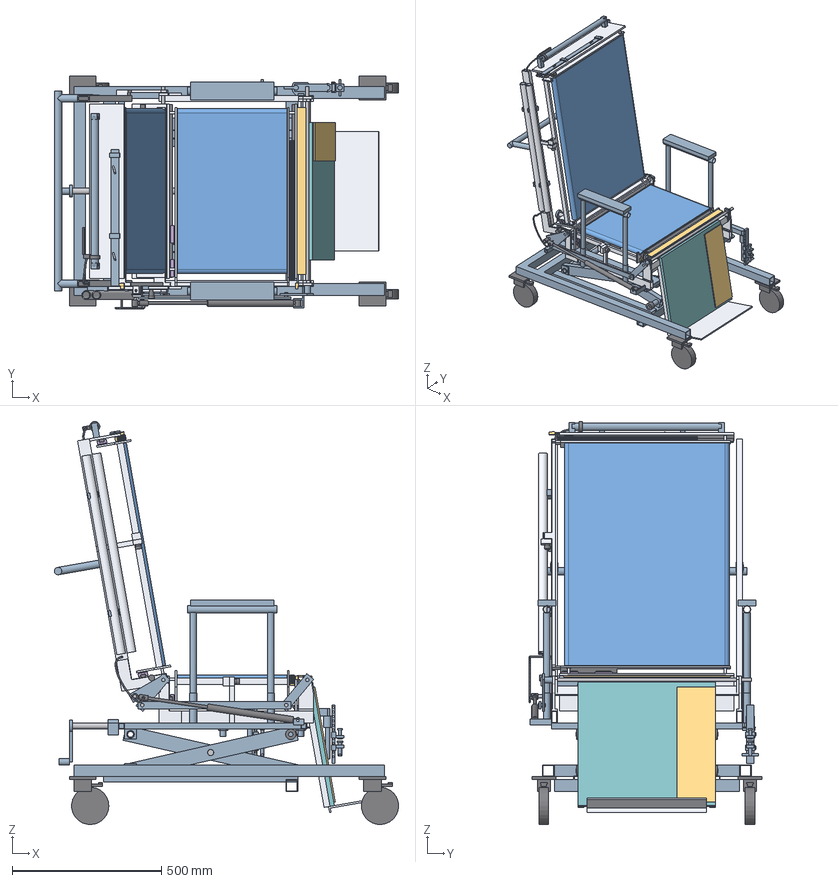
[picture p32: CAD file, 2026-10-22]
CAD Files/Assemblies/WCB_ASM_1_Wheelchair_mode_S500.step
1152.6 x 779.5 x 1348.9 mm
P01_Base_frame_weldment_lower_1
P02_Caster_125_mm_total_lock_swivel_lower_1
P55_Caster_total_lock_brake_pedal_lower_1
P02_Caster_125_mm_total_lock_swivel_lower_2
P55_Caster_total_lock_brake_pedal_lower_2
P02_Caster_125_mm_total_lock_swivel_lower_3
P55_Caster_total_lock_brake_pedal_lower_3
P02_Caster_125_mm_total_lock_swivel_lower_4
P55_Caster_total_lock_brake_pedal_lower_4
P03_Scissor_arm_outer_lower_1
P04_Scissor_arm_inner_lower_1
P09_Centre_pin_Dia20_circlips_lower_1
P03_Scissor_arm_outer_lower_2
P04_Scissor_arm_inner_lower_2
P09_Centre_pin_Dia20_circlips_lower_2
P05_Cross_shaft_top_sliding_roller_stubs_lower_1
P06_Cross_shaft_top_fixed_lower_1
P07_Cross_shaft_bottom_fixed_lower_1
P08_Cross_shaft_bottom_sliding_roller_stubs_lower_1
P10_Track_roller_2_x_6202_2RS_bearings_lower_1
P10_Track_roller_2_x_6202_2RS_bearings_lower_2
P10_Track_roller_2_x_6202_2RS_bearings_lower_3
P10_Track_roller_2_x_6202_2RS_bearings_lower_4
P11_Lift_top_frame_weldment_lower_1
P12_Lead_screw_Tr20x4_lower_1
P13_Nut_block_Tr20x4_lower_1
P14_Thrust_bearing_block_lower_1
P15_Folding_crank_handle_R120_lower_1
P16_Seat_side_rail_40x20x2_RHS_seat_1
P16_Seat_side_rail_40x20x2_RHS_seat_2
P17_Seat_cheek_plate_8_mm_seat_1
P17_Seat_cheek_plate_8_mm_seat_2
P18_Back_pivot_bracket_8_mm_seat_1
P19_Leg_pivot_bracket_8_mm_seat_1
P18_Back_pivot_bracket_8_mm_seat_2
P19_Leg_pivot_bracket_8_mm_seat_2
P22_Gas_spring_anchor_bracket_seat_1
P23_Armrest_socket_Dia25_tube_seat_1
P23_Armrest_socket_Dia25_tube_seat_2
P23_Armrest_socket_Dia25_tube_seat_3
P23_Armrest_socket_Dia25_tube_seat_4
P47_Knee_filler_strip_PTFE_faced_seat_1
P24_Cassette_board_seat_seat_1
P26_Cassette_end_plate_6_mm_seat_1
P26_Cassette_end_plate_6_mm_seat_2
P27_Belt_roller_Dia24_x_366_Dia8_stub_axles_seat_1
P27_Belt_roller_Dia24_x_366_Dia8_stub_axles_seat_2
P28_Conveyor_belt_seat_endless_2_mm_PU_polye_seat_1
P29_Pinion_m1_z28_16_face_keyed_to_roller_seat_1
P58_Bar_clip_on_bracket_seat_1
P58_Bar_clip_on_bracket_seat_2
P68_Transit_lock_edge_bar_lug_seat_cassette_seat_1
P20_Linear_guide_rail_MGN15_x_580_seat_1
P20A_Linear_guide_carriage_MGN15H_3_mm_spacer_seat_1
P20A_Linear_guide_carriage_MGN15H_3_mm_spacer_seat_2
P21_Rack_m1_x_470_drops_6_mm_in_FREE_seat_1
P50_Rack_guide_pins_Dia5_seat_1
P51_Cam_slider_bar_3_5_mm_2_inclined_slots_seat_1
P52_Slider_keepers_seat_1
P53_Mode_T_handle_push_CONVEY_pull_FREE_seat_1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
