Shrey-BM/Convertible-Wheelchair-to-Bed-Transfer-System/CAD Files/Parts/P02_Caster_125_mm_total_lock_swivel.step

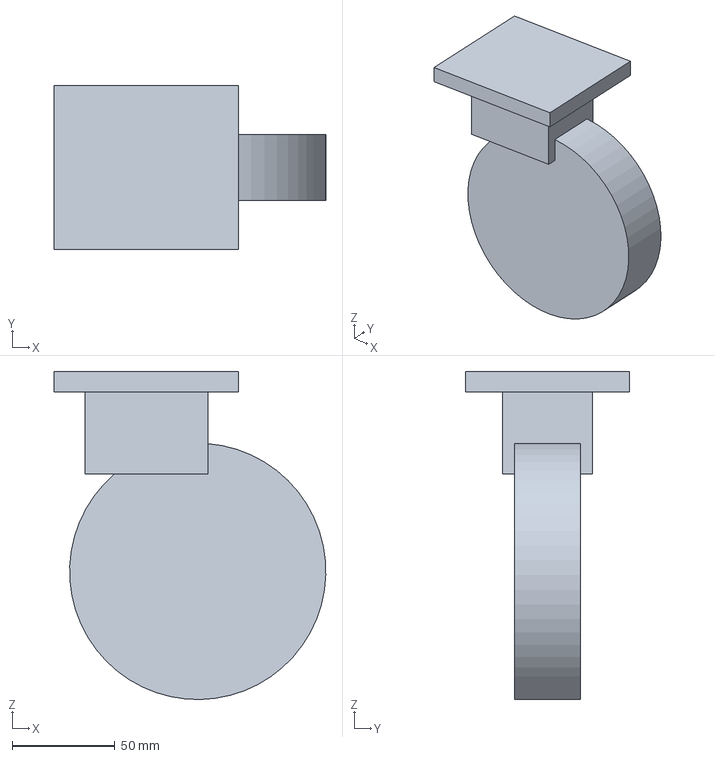
[picture p33: CAD file, 2026-10-22]
CAD Files/Parts/P02_Caster_125_mm_total_lock_swivel.step
132.5 x 80.0 x 160.0 mm
