Shrey-BM/Convertible-Wheelchair-to-Bed-Transfer-System/CAD Files/Parts/P55_Caster_total_lock_brake_pedal.step

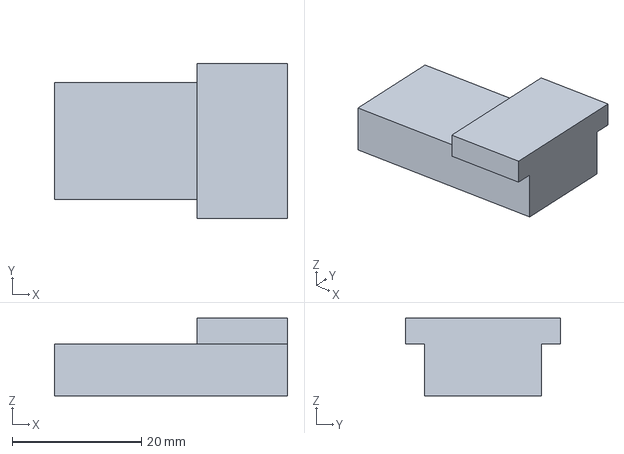
[picture p34: CAD file, 2026-10-22]
CAD Files/Parts/P55_Caster_total_lock_brake_pedal.step
36.0 x 24.0 x 12.0 mm
