Shrey-BM/Convertible-Wheelchair-to-Bed-Transfer-System/CAD Files/Parts/P01_Base_frame_weldment.step

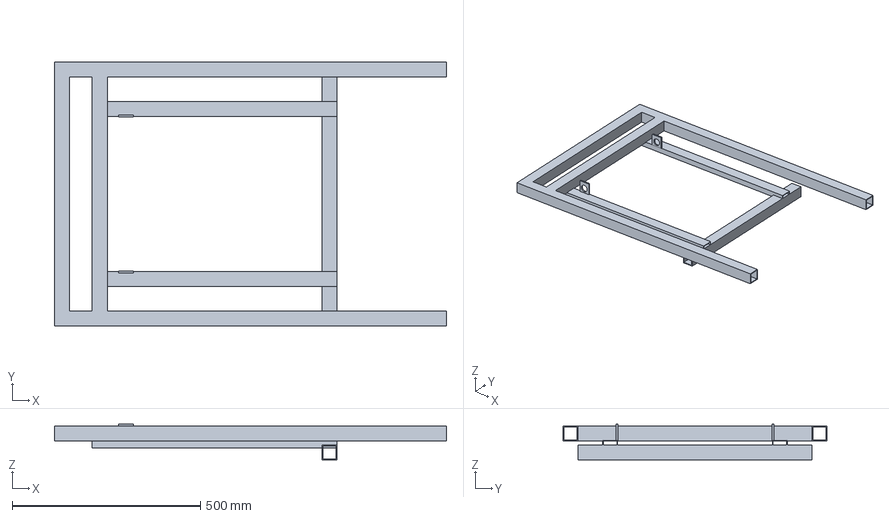
[picture p35: CAD file, 2026-10-22]
CAD Files/Parts/P01_Base_frame_weldment.step
1040.0 x 700.0 x 95.0 mm
