Shrey-BM/Convertible-Wheelchair-to-Bed-Transfer-System/CAD Files/Subsystems/WCB_SUB_1_Scissor_lift.step

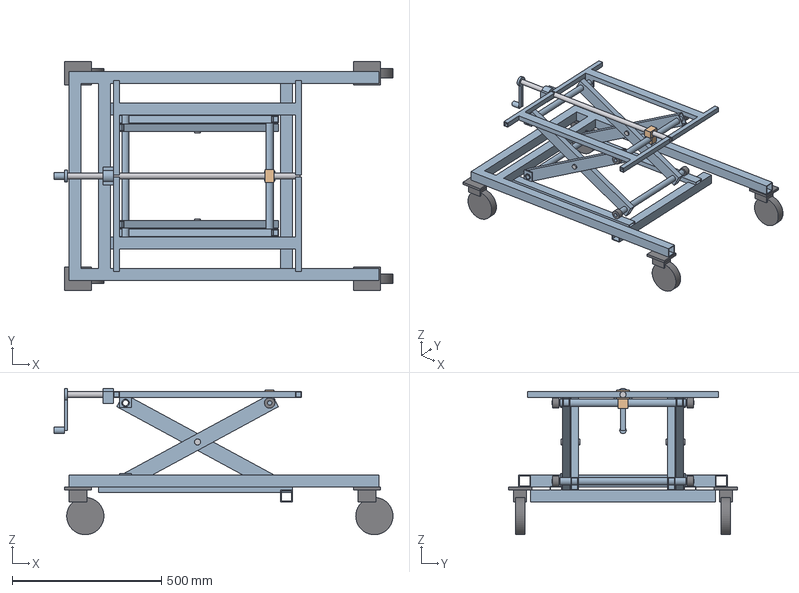
[picture p36: CAD file, 2026-10-22]
CAD Files/Subsystems/WCB_SUB_1_Scissor_lift.step
1137.5 x 770.0 x 490.9 mm
P01_Base_frame_weldment_1
P02_Caster_125_mm_total_lock_swivel_1
P02_Caster_125_mm_total_lock_swivel_2
P02_Caster_125_mm_total_lock_swivel_3
P02_Caster_125_mm_total_lock_swivel_4
P03_Scissor_arm_outer_1
P04_Scissor_arm_inner_1
P09_Centre_pin_Dia20_circlips_1
P03_Scissor_arm_outer_2
P04_Scissor_arm_inner_2
P09_Centre_pin_Dia20_circlips_2
P05_Cross_shaft_top_sliding_roller_stubs_1
P06_Cross_shaft_top_fixed_1
P07_Cross_shaft_bottom_fixed_1
P08_Cross_shaft_bottom_sliding_roller_stubs_1
P10_Track_roller_2_x_6202_2RS_bearings_1
P10_Track_roller_2_x_6202_2RS_bearings_2
P10_Track_roller_2_x_6202_2RS_bearings_3
P10_Track_roller_2_x_6202_2RS_bearings_4
P11_Lift_top_frame_weldment_1
P12_Lead_screw_Tr20x4_1
P13_Nut_block_Tr20x4_1
P14_Thrust_bearing_block_1
P15_Folding_crank_handle_R120_1
