Shrey-BM/Convertible-Wheelchair-to-Bed-Transfer-System/CAD Files/Parts/P68_Transit_lock_edge_bar_lug_seat_cassette.step

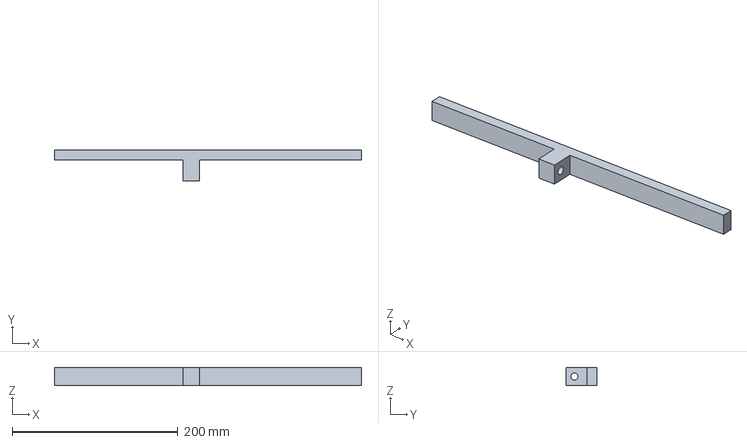
[picture p37: CAD file, 2026-10-22]
CAD Files/Parts/P68_Transit_lock_edge_bar_lug_seat_cassette.step
370.0 x 37.0 x 22.0 mm
