Shrey-BM/Convertible-Wheelchair-to-Bed-Transfer-System/CAD Files/Subsystems/WCB_SUB_5_Safety_anchoring.step

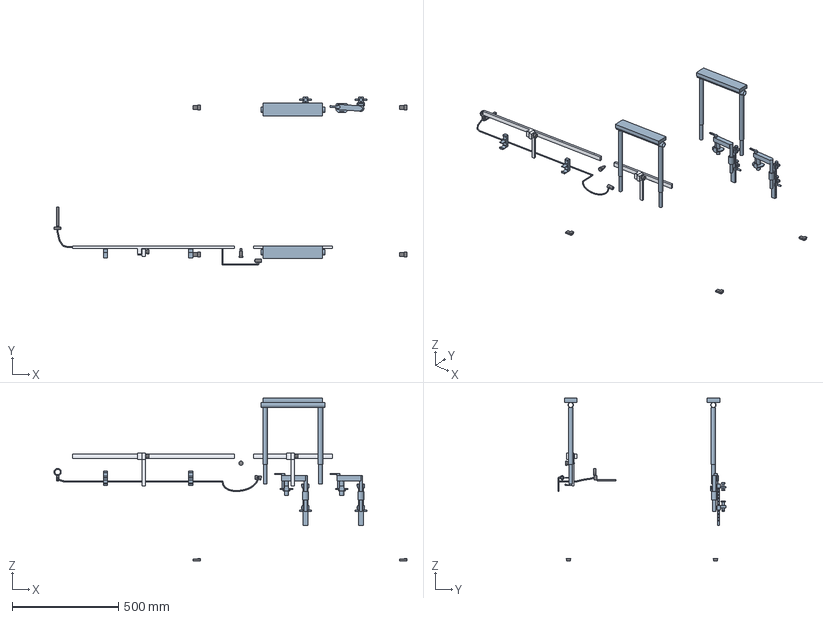
[picture p38: CAD file, 2026-10-22]
CAD Files/Subsystems/WCB_SUB_5_Safety_anchoring.step
1658.0 x 788.5 x 764.0 mm
P55_Caster_total_lock_brake_pedal_1
P55_Caster_total_lock_brake_pedal_2
P55_Caster_total_lock_brake_pedal_3
P55_Caster_total_lock_brake_pedal_4
P68_Transit_lock_edge_bar_lug_seat_cassette_1
P48_Transit_lock_index_plunger_pin_Dia8_M16x_1
P69_Transit_lock_post_1
P68_Transit_lock_edge_bar_lug_back_cassette_1
P57_Recline_detent_plunger_Dia8_pin_1
P48_Transit_lock_index_plunger_pin_Dia8_M16x_2
P69_Transit_lock_post_2
P54_Bar_storage_clip_1
P54_Bar_storage_clip_2
P67_Gas_spring_remote_release_kit_lever_on_g_1
P46_Removable_armrest_1
P46_Removable_armrest_2
P45_Swing_reach_dock_arm_25x25_SHS_L90_M10_l_1
P62_Clamp_F_bar_24x10_knuckle_sleeve_1
P60_Upper_jaw_sliding_on_F_bar_index_pin_1
P64_Lower_jaw_sliding_on_F_bar_index_pin_1
P56_Clamp_T_screw_M12_swivel_pad_1
P66_Upper_jaw_pressure_screw_M10_pad_1
P59_Dock_arm_pivot_lug_friction_disc_bolted__1
P45_Swing_reach_dock_arm_25x25_SHS_L90_M10_l_2
P62_Clamp_F_bar_24x10_knuckle_sleeve_2
P60_Upper_jaw_sliding_on_F_bar_index_pin_2
P64_Lower_jaw_sliding_on_F_bar_index_pin_2
P56_Clamp_T_screw_M12_swivel_pad_2
P66_Upper_jaw_pressure_screw_M10_pad_2
P59_Dock_arm_pivot_lug_friction_disc_bolted__2
