Shrey-BM/Convertible-Wheelchair-to-Bed-Transfer-System/CAD Files/Subsystems/WCB_SUB_2_Chair_to_flat.step

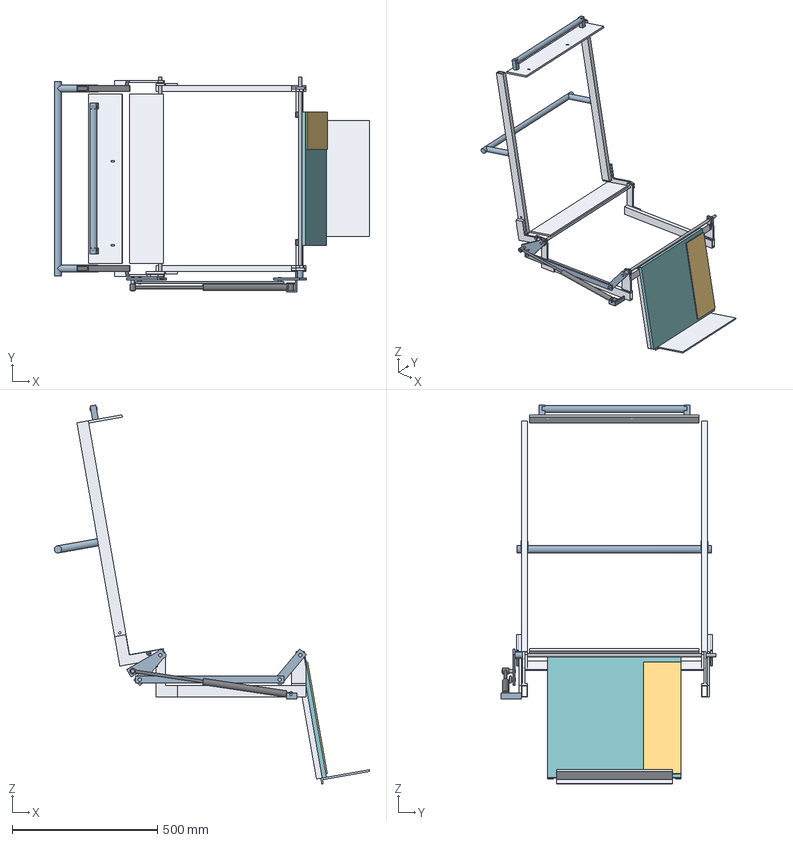
[picture p39: CAD file, 2026-10-22]
CAD Files/Subsystems/WCB_SUB_2_Chair_to_flat.step
1086.3 x 741.0 x 1305.4 mm
P16_Seat_side_rail_40x20x2_RHS_1
P16_Seat_side_rail_40x20x2_RHS_2
P18_Back_pivot_bracket_8_mm_1
P19_Leg_pivot_bracket_8_mm_1
P18_Back_pivot_bracket_8_mm_2
P19_Leg_pivot_bracket_8_mm_2
P22_Gas_spring_anchor_bracket_1
P30_Back_side_rail_40x20x3_RHS_1
P30_Back_side_rail_40x20x3_RHS_2
P65_Recline_0_deg_hard_stop_plug_1
P65_Recline_0_deg_hard_stop_plug_2
P31_Back_cheek_plate_8_mm_1
P31_Back_cheek_plate_8_mm_2
P32_Back_pivot_plate_8_mm_spacer_1
P32_Back_pivot_plate_8_mm_spacer_2
P33_Back_bell_crank_R110_1
P49_Head_end_grip_bar_Dia25_1
P34_Push_handle_U_bar_Dia25_1
P43_Pivot_pin_Dia12_shoulder_bolt_1
P35_Leg_pad_15_mm_1
P36_Leg_side_tube_20x20x1_5_1
P37_Leg_pivot_plate_8_mm_hinge_connector_1
P36_Leg_side_tube_20x20x1_5_2
P37_Leg_pivot_plate_8_mm_hinge_connector_2
P38_Leg_crank_arm_R110_1
P39_Flip_footplate_1
P40_Bridge_flap_130_mm_folds_over_pad_1
P43_Pivot_pin_Dia12_shoulder_bolt_2
P41_Tie_rod_25x8_flat_c_c_482_1
P43_Linkage_pins_Dia12_1
P43_Linkage_pins_Dia12_2
P43_Linkage_pins_Dia12_3
P42_Lockable_gas_spring_1200_N_stroke_150_ex_1
