Shrey-BM/Convertible-Wheelchair-to-Bed-Transfer-System/CAD Files/Subsystems/WCB_SUB_4_Rolling.step

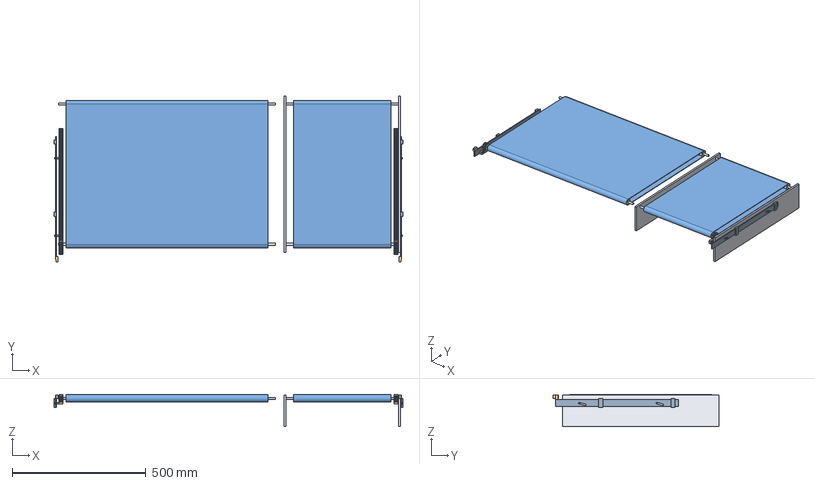
[picture p40: CAD file, 2026-10-22]
CAD Files/Subsystems/WCB_SUB_4_Rolling.step
1304.0 x 620.0 x 121.0 mm
P17_Seat_cheek_plate_8_mm_1
P17_Seat_cheek_plate_8_mm_2
P27_Belt_roller_Dia24_x_366_Dia8_stub_axles_1
P27_Belt_roller_Dia24_x_366_Dia8_stub_axles_2
P28_Conveyor_belt_seat_endless_2_mm_PU_polye_1
P29_Pinion_m1_z28_16_face_keyed_to_roller_1
P21_Rack_m1_x_470_drops_6_mm_in_FREE_1
P50_Rack_guide_pins_Dia5_1
P51_Cam_slider_bar_3_5_mm_2_inclined_slots_1
P52_Slider_keepers_1
P53_Mode_T_handle_push_CONVEY_pull_FREE_1
P27_Belt_roller_Dia24_x_756_Dia8_stub_axles_1
P27_Belt_roller_Dia24_x_756_Dia8_stub_axles_2
P28_Conveyor_belt_back_endless_2_mm_PU_polye_1
P29_Pinion_m1_z28_16_face_keyed_to_roller_2
P21_Rack_m1_x_470_drops_6_mm_in_FREE_2
P50_Rack_guide_pins_Dia5_2
P51_Cam_slider_bar_3_5_mm_2_inclined_slots_2
P52_Slider_keepers_2
P53_Mode_T_handle_push_CONVEY_pull_FREE_2
