Shrey-BM/Convertible-Wheelchair-to-Bed-Transfer-System/CAD Files/Parts/P14_Thrust_bearing_block.step

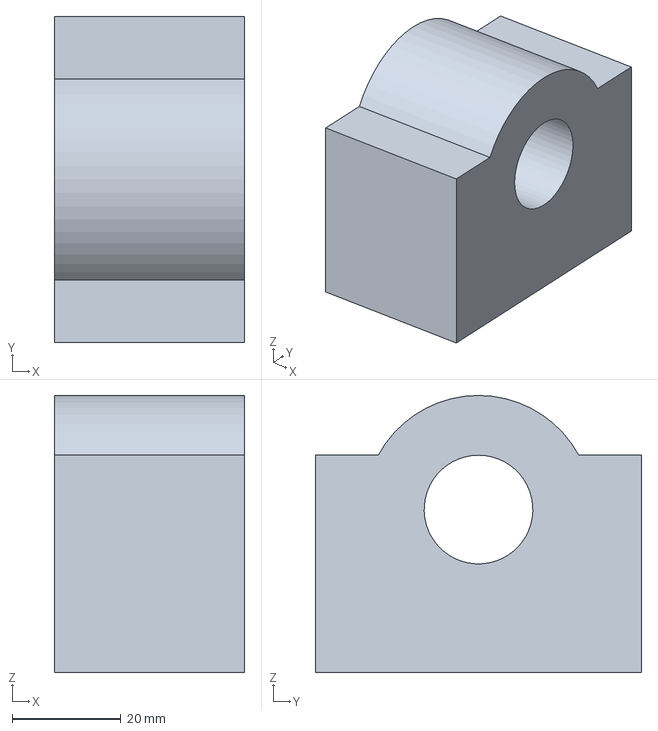
[picture p41: CAD file, 2026-10-22]
CAD Files/Parts/P14_Thrust_bearing_block.step
35.0 x 60.0 x 51.0 mm
