Shrey-BM/Convertible-Wheelchair-to-Bed-Transfer-System/CAD Files/Subsystems/WCB_SUB_3_Sliding.step

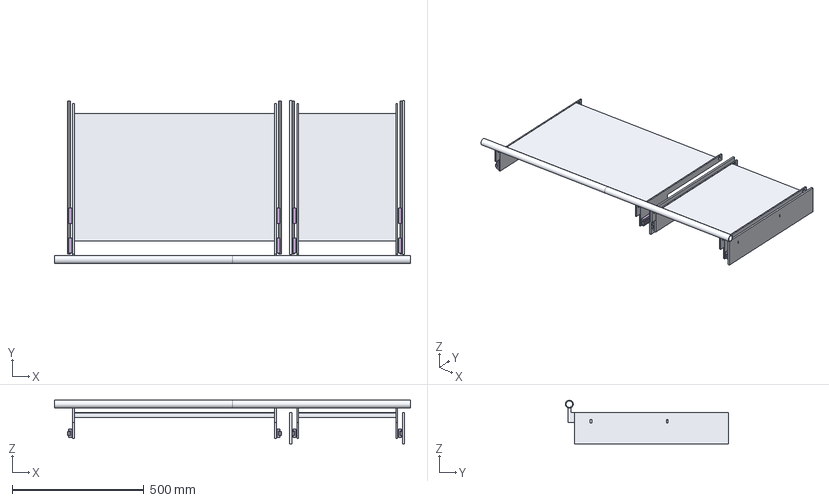
[picture p42: CAD file, 2026-10-22]
CAD Files/Subsystems/WCB_SUB_3_Sliding.step
1350.0 x 619.0 x 165.0 mm
P17_Seat_cheek_plate_8_mm_1
P17_Seat_cheek_plate_8_mm_2
P24_Cassette_board_seat_1
P26_Cassette_end_plate_6_mm_1
P26_Cassette_end_plate_6_mm_2
P58_Bar_clip_on_bracket_1
P58_Bar_clip_on_bracket_2
P20_Linear_guide_rail_MGN15_x_580_1
P20A_Linear_guide_carriage_MGN15H_3_mm_spacer_1
P20A_Linear_guide_carriage_MGN15H_3_mm_spacer_2
P20_Linear_guide_rail_MGN15_x_580_2
P20A_Linear_guide_carriage_MGN15H_3_mm_spacer_3
P20A_Linear_guide_carriage_MGN15H_3_mm_spacer_4
P25_Cassette_board_back_1
P26_Cassette_end_plate_6_mm_3
P26_Cassette_end_plate_6_mm_4
P58_Bar_clip_on_bracket_3
P58_Bar_clip_on_bracket_4
P20_Linear_guide_rail_MGN15_x_580_3
P20A_Linear_guide_carriage_MGN15H_3_mm_spacer_5
P20A_Linear_guide_carriage_MGN15H_3_mm_spacer_6
P20_Linear_guide_rail_MGN15_x_580_4
P20A_Linear_guide_carriage_MGN15H_3_mm_spacer_7
P20A_Linear_guide_carriage_MGN15H_3_mm_spacer_8
P44_Transfer_bar_half_Dia30_x_675_1
P44_Transfer_bar_half_Dia30_x_675_2
