Shrey-BM/Convertible-Wheelchair-to-Bed-Transfer-System/CAD Files/Parts/P16_Seat_side_rail_40x20x2_RHS.step

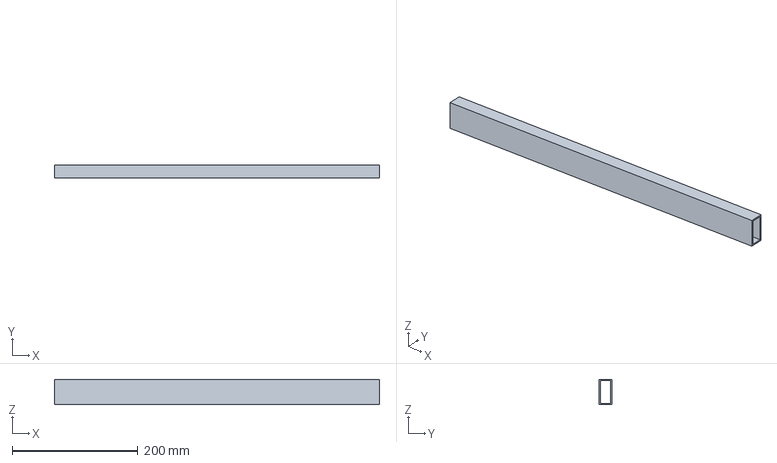
[picture p43: CAD file, 2026-10-22]
CAD Files/Parts/P16_Seat_side_rail_40x20x2_RHS.step
517.0 x 20.0 x 40.0 mm
