Shrey-BM/Convertible-Wheelchair-to-Bed-Transfer-System/CAD Files/Parts/P34_Push_handle_U_bar_Dia25.step

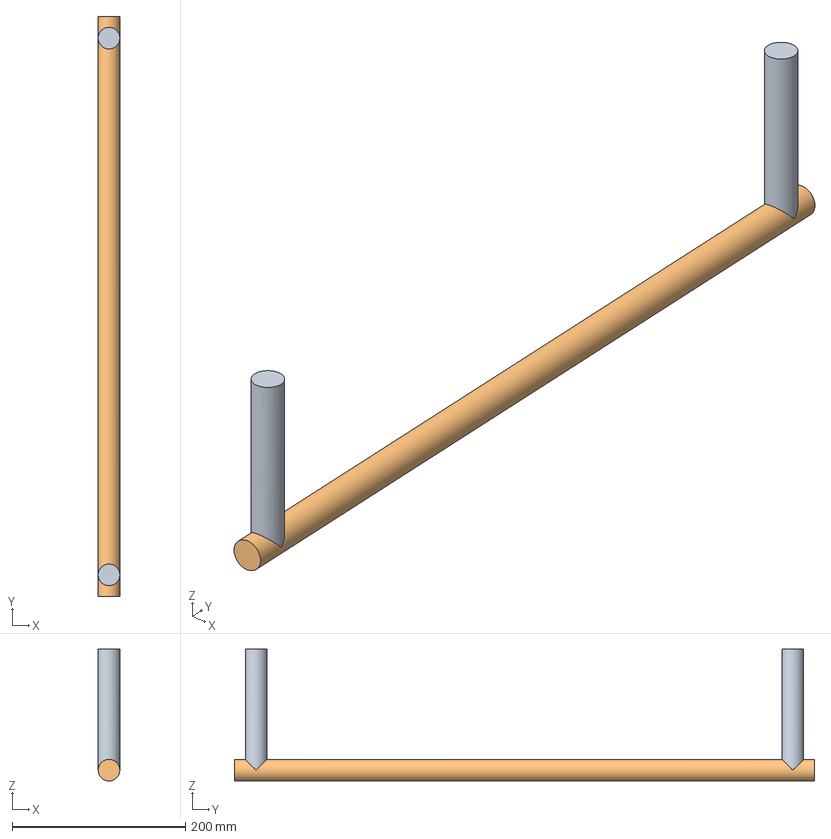
[picture p44: CAD file, 2026-10-22]
CAD Files/Parts/P34_Push_handle_U_bar_Dia25.step
25.0 x 670.0 x 152.5 mm
