Shrey-BM/Convertible-Wheelchair-to-Bed-Transfer-System/CAD Files/Parts/P23_Armrest_socket_Dia25_tube.step

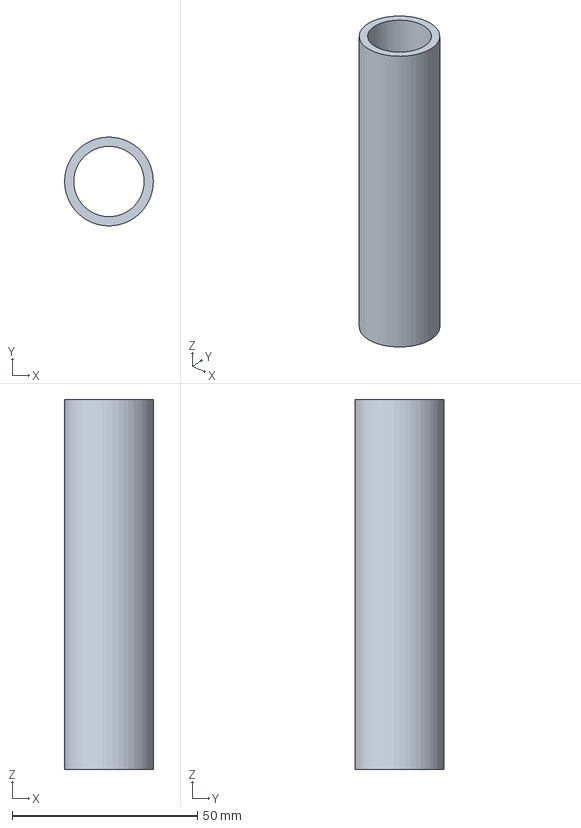
[picture p45: CAD file, 2026-10-22]
CAD Files/Parts/P23_Armrest_socket_Dia25_tube.step
24.0 x 24.0 x 100.0 mm
