Shrey-BM/Convertible-Wheelchair-to-Bed-Transfer-System/CAD Files/Parts/P05_Cross_shaft_top_sliding_roller_stubs.step

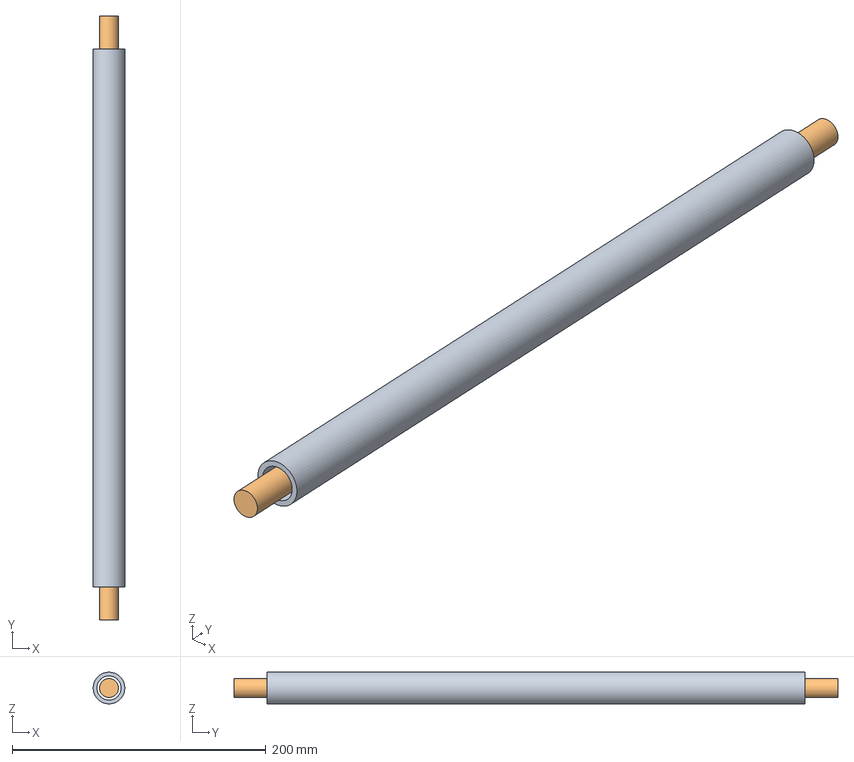
[picture p46: CAD file, 2026-10-22]
CAD Files/Parts/P05_Cross_shaft_top_sliding_roller_stubs.step
25.0 x 476.0 x 25.0 mm
