Shrey-BM/Convertible-Wheelchair-to-Bed-Transfer-System/CAD Files/Parts/P22_Gas_spring_anchor_bracket.step

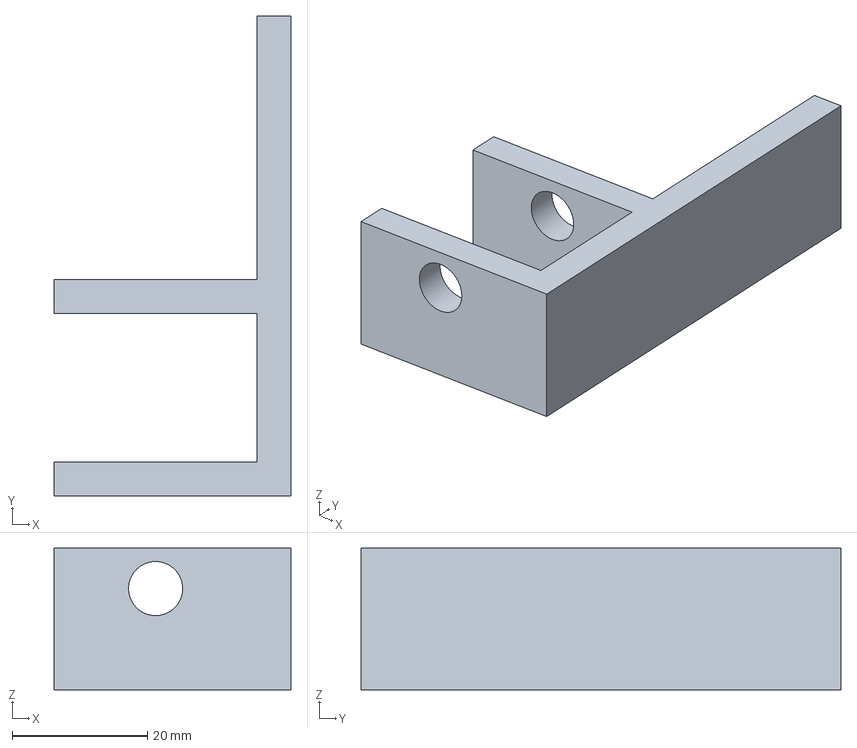
[picture p47: CAD file, 2026-10-22]
CAD Files/Parts/P22_Gas_spring_anchor_bracket.step
35.0 x 71.0 x 21.0 mm
