Shrey-BM/Convertible-Wheelchair-to-Bed-Transfer-System/CAD Files/Parts/P20_Linear_guide_rail_MGN15_x_580.step

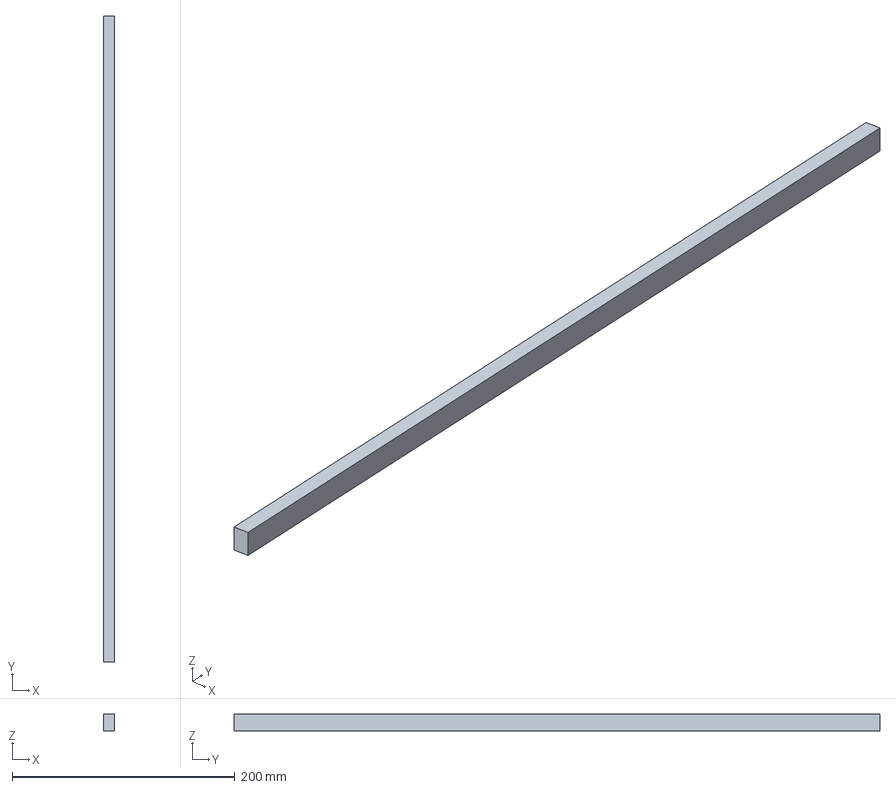
[picture p48: CAD file, 2026-10-22]
CAD Files/Parts/P20_Linear_guide_rail_MGN15_x_580.step
10.0 x 580.0 x 15.0 mm
