Shrey-BM/Convertible-Wheelchair-to-Bed-Transfer-System/CAD Files/Parts/P32_Back_pivot_plate_8_mm_spacer.step

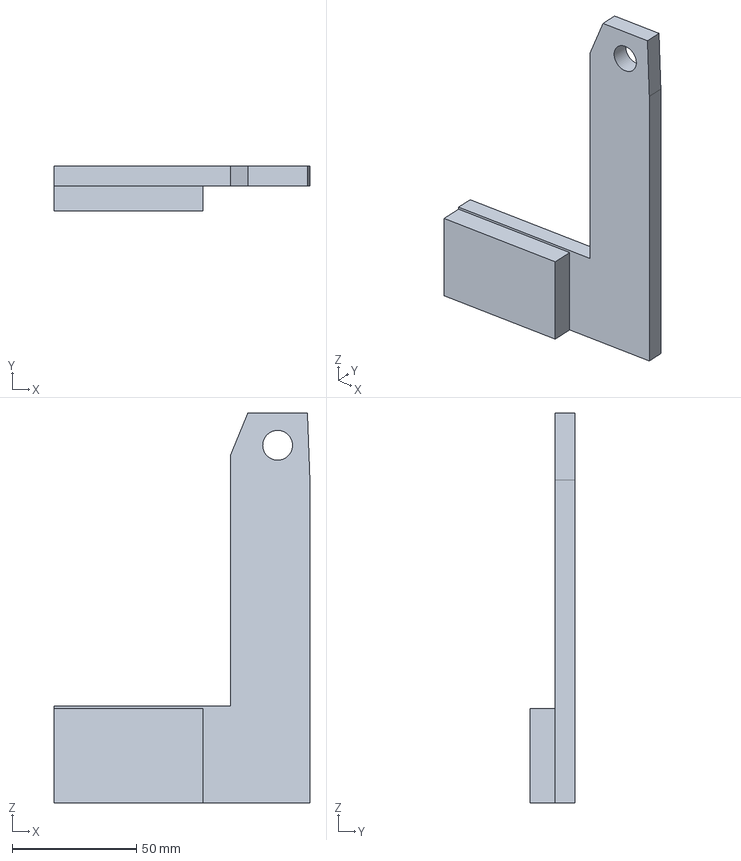
[picture p49: CAD file, 2026-10-22]
CAD Files/Parts/P32_Back_pivot_plate_8_mm_spacer.step
103.0 x 18.0 x 157.0 mm
