Shrey-BM/Convertible-Wheelchair-to-Bed-Transfer-System/CAD Files/Parts/P19_Leg_pivot_bracket_8_mm.step

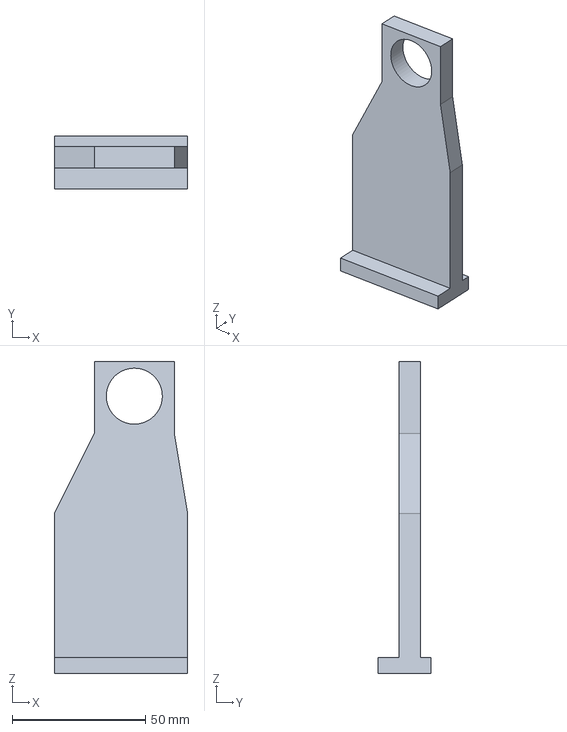
[picture p50: CAD file, 2026-10-22]
CAD Files/Parts/P19_Leg_pivot_bracket_8_mm.step
50.0 x 20.0 x 117.0 mm
