Shrey-BM/Convertible-Wheelchair-to-Bed-Transfer-System/CAD Files/Parts/P21_Rack_m1_x_470_drops_6_mm_in_FREE.step

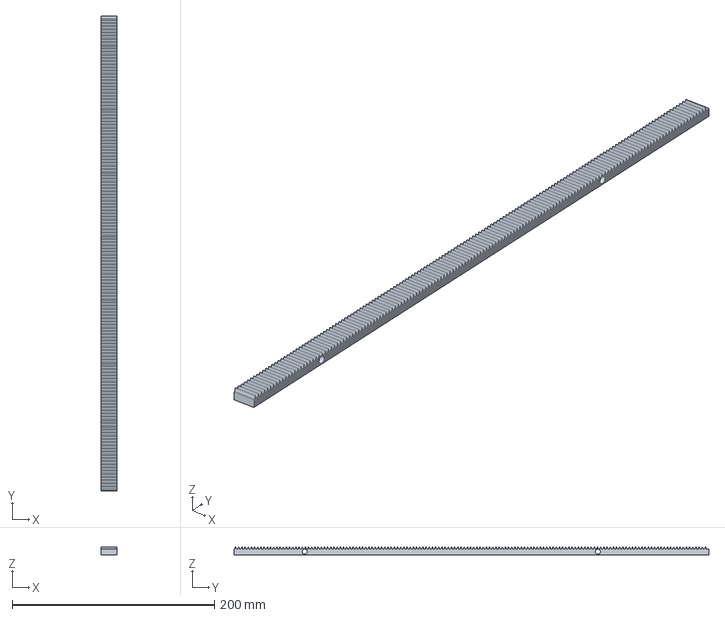
[picture p51: CAD file, 2026-10-22]
CAD Files/Parts/P21_Rack_m1_x_470_drops_6_mm_in_FREE.step
16.0 x 470.0 x 8.00 mm
