Shrey-BM/Convertible-Wheelchair-to-Bed-Transfer-System/CAD Files/Parts/P47_Knee_filler_strip_PTFE_faced.step

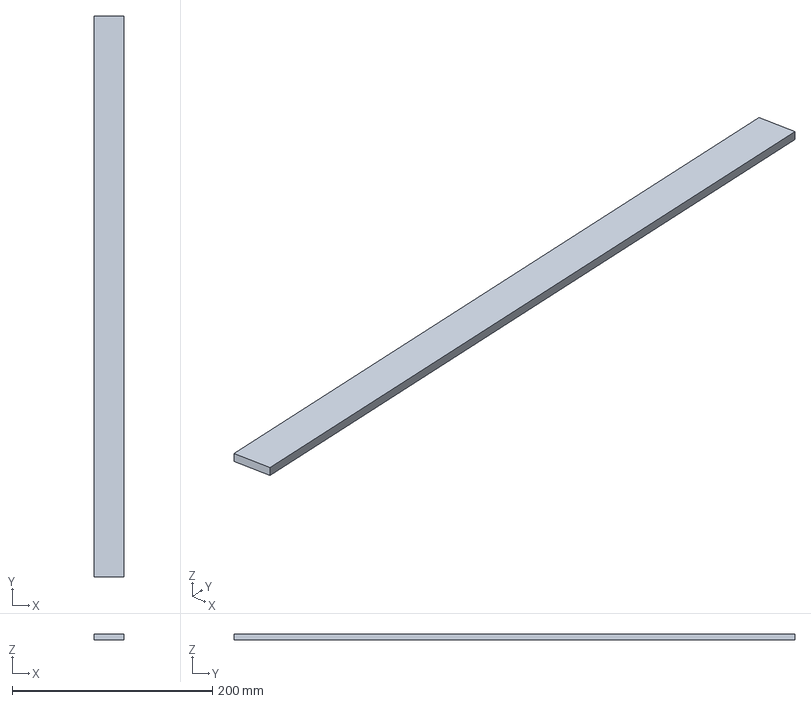
[picture p52: CAD file, 2026-10-22]
CAD Files/Parts/P47_Knee_filler_strip_PTFE_faced.step
30.0 x 560.0 x 6.00 mm
