Shrey-BM/Convertible-Wheelchair-to-Bed-Transfer-System/CAD Files/Parts/P67_Gas_spring_remote_release_kit_lever_on_g.step

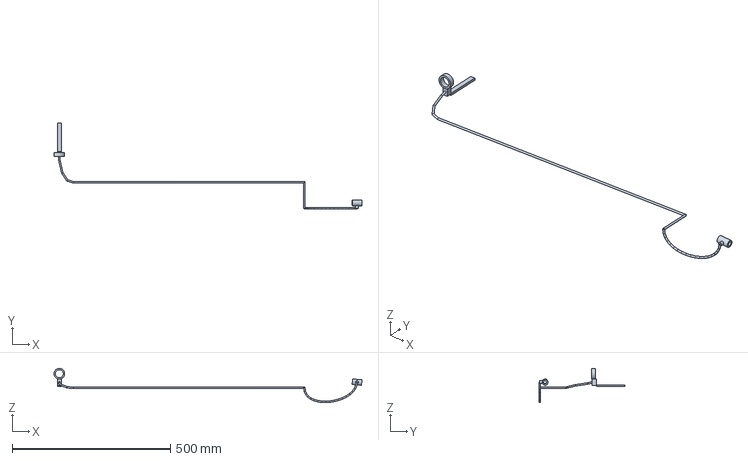
[picture p53: CAD file, 2026-10-22]
CAD Files/Parts/P67_Gas_spring_remote_release_kit_lever_on_g.step
974.2 x 272.5 x 108.6 mm
