Shrey-BM/Convertible-Wheelchair-to-Bed-Transfer-System/CAD Files/Parts/P27_Belt_roller_Dia24_x_366_Dia8_stub_axles.step

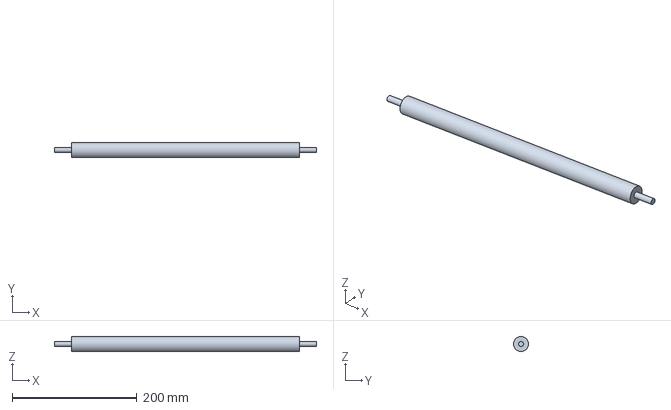
[picture p54: CAD file, 2026-10-22]
CAD Files/Parts/P27_Belt_roller_Dia24_x_366_Dia8_stub_axles.step
420.0 x 24.0 x 24.0 mm
