Shrey-BM/Convertible-Wheelchair-to-Bed-Transfer-System/CAD Files/Parts/P51_Cam_slider_bar_3_5_mm_2_inclined_slots.step

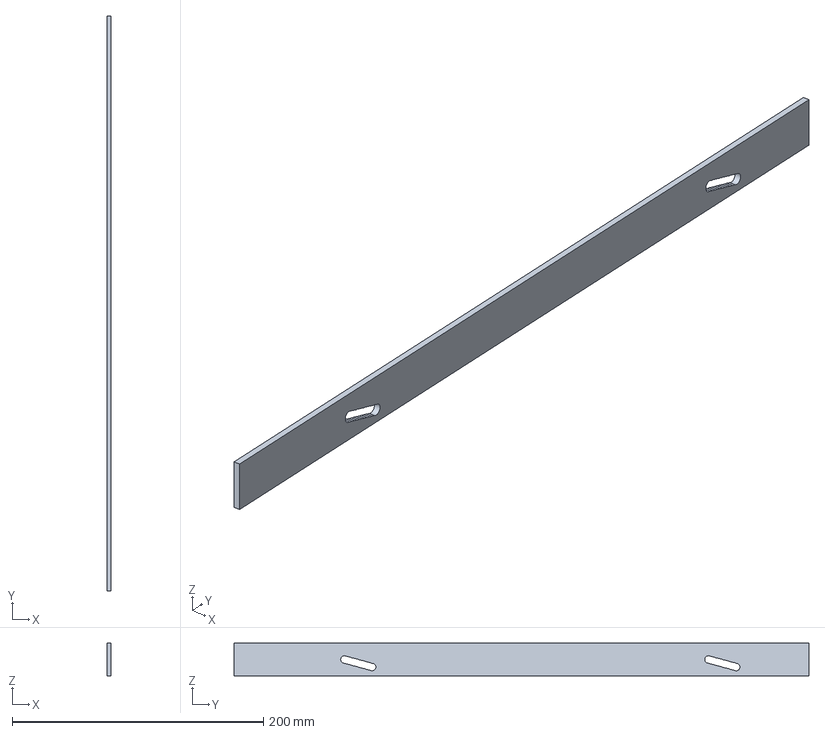
[picture p55: CAD file, 2026-10-22]
CAD Files/Parts/P51_Cam_slider_bar_3_5_mm_2_inclined_slots.step
3.50 x 458.0 x 26.0 mm
