Shrey-BM/Convertible-Wheelchair-to-Bed-Transfer-System/CAD Files/Parts/P48_Transit_lock_index_plunger_pin_Dia8_M16x.step

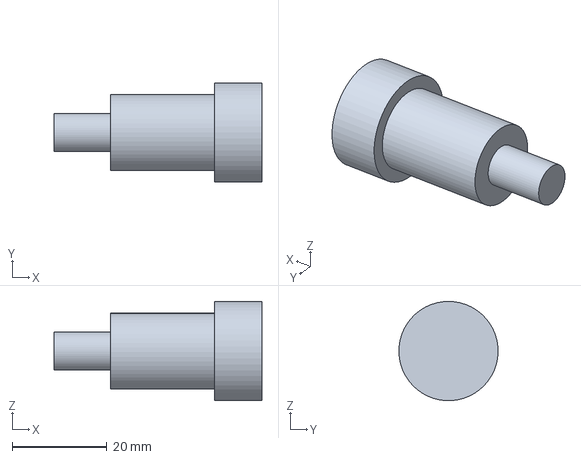
[picture p56: CAD file, 2026-10-22]
CAD Files/Parts/P48_Transit_lock_index_plunger_pin_Dia8_M16x.step
44.0 x 21.0 x 21.0 mm
