Shrey-BM/Convertible-Wheelchair-to-Bed-Transfer-System/CAD Files/Parts/P53_Mode_T_handle_push_CONVEY_pull_FREE.step

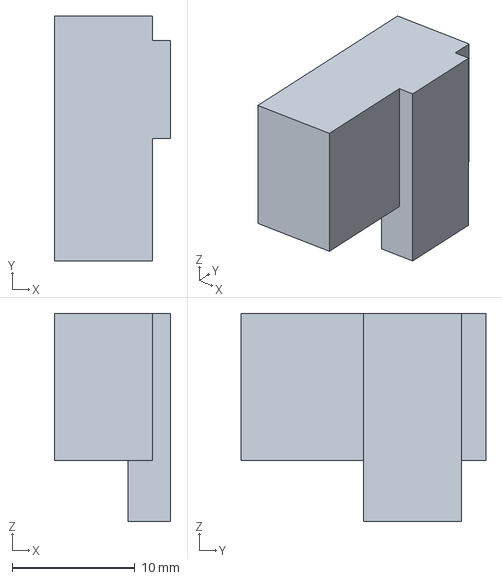
[picture p58: CAD file, 2026-10-22]
CAD Files/Parts/P53_Mode_T_handle_push_CONVEY_pull_FREE.step
9.50 x 20.0 x 17.0 mm
