Shrey-BM/Convertible-Wheelchair-to-Bed-Transfer-System/CAD Files/Parts/P29_Pinion_m1_z28_16_face_keyed_to_roller.step

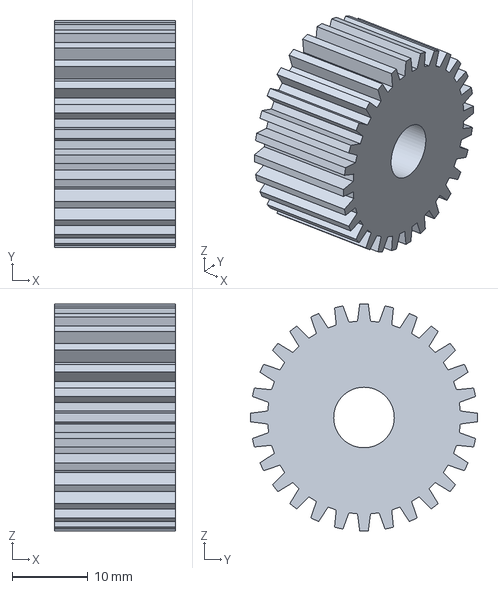
[picture p59: CAD file, 2026-10-22]
CAD Files/Parts/P29_Pinion_m1_z28_16_face_keyed_to_roller.step
16.0 x 30.0 x 30.0 mm
