Shrey-BM/Convertible-Wheelchair-to-Bed-Transfer-System/CAD Files/Parts/P24_Cassette_board_seat.step

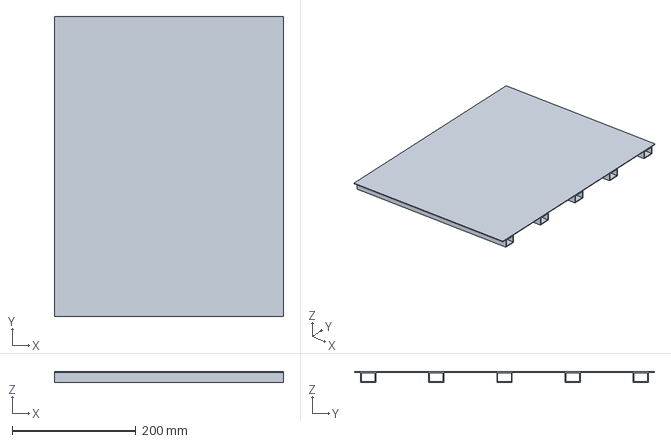
[picture p60: CAD file, 2026-10-22]
CAD Files/Parts/P24_Cassette_board_seat.step
370.0 x 484.0 x 17.8 mm
