Shrey-BM/Convertible-Wheelchair-to-Bed-Transfer-System/CAD Files/Parts/P68_Transit_lock_edge_bar_lug_back_cassette.step

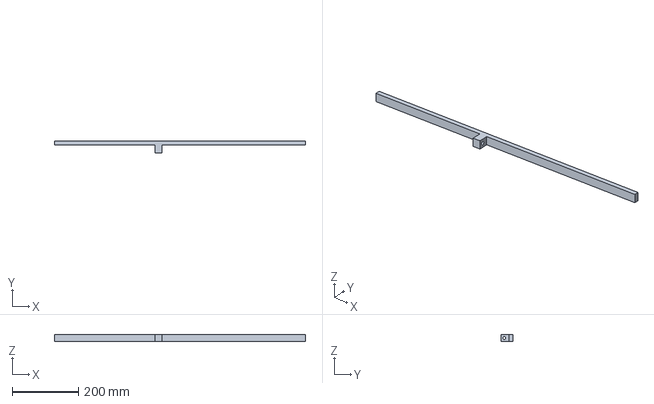
[picture p61: CAD file, 2026-10-22]
CAD Files/Parts/P68_Transit_lock_edge_bar_lug_back_cassette.step
760.0 x 37.0 x 22.0 mm
