Shrey-BM/Convertible-Wheelchair-to-Bed-Transfer-System/CAD Files/Parts/P33_Back_bell_crank_R110.step

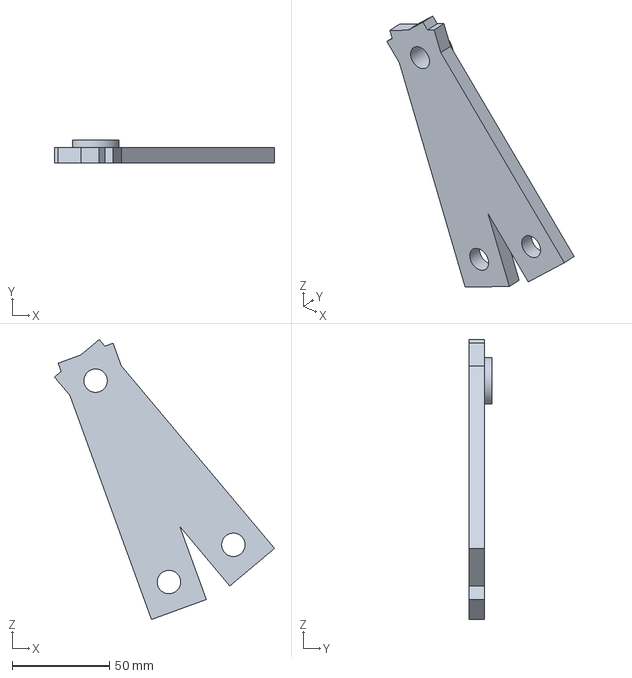
[picture p62: CAD file, 2026-10-22]
CAD Files/Parts/P33_Back_bell_crank_R110.step
113.0 x 12.0 x 143.7 mm
