Shrey-BM/Convertible-Wheelchair-to-Bed-Transfer-System/CAD Files/Parts/P65_Recline_0_deg_hard_stop_plug.step

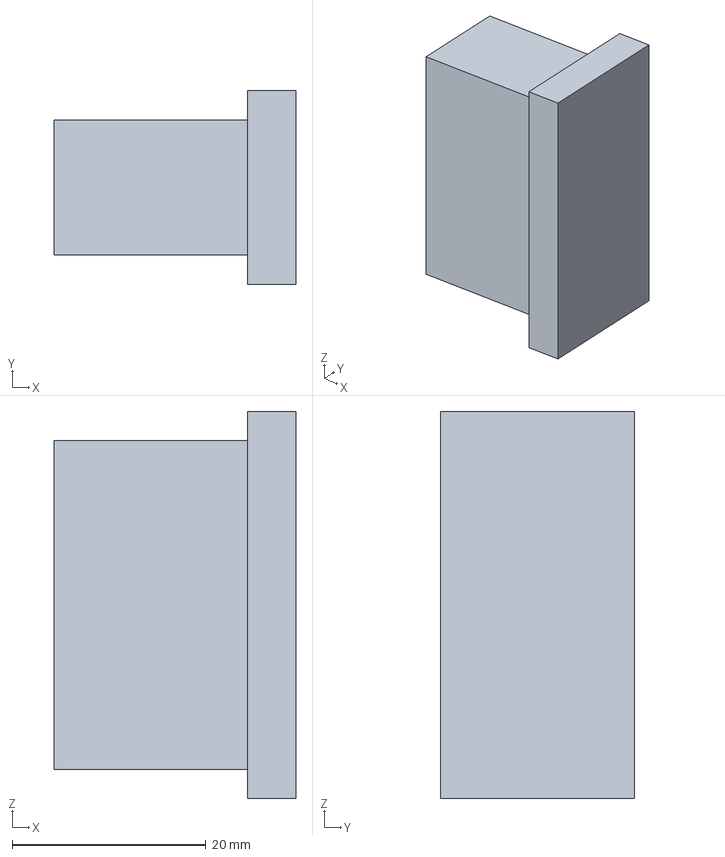
[picture p63: CAD file, 2026-10-22]
CAD Files/Parts/P65_Recline_0_deg_hard_stop_plug.step
25.0 x 20.0 x 40.0 mm
