Shrey-BM/Convertible-Wheelchair-to-Bed-Transfer-System/CAD Files/Parts/P57_Recline_detent_plunger_Dia8_pin.step

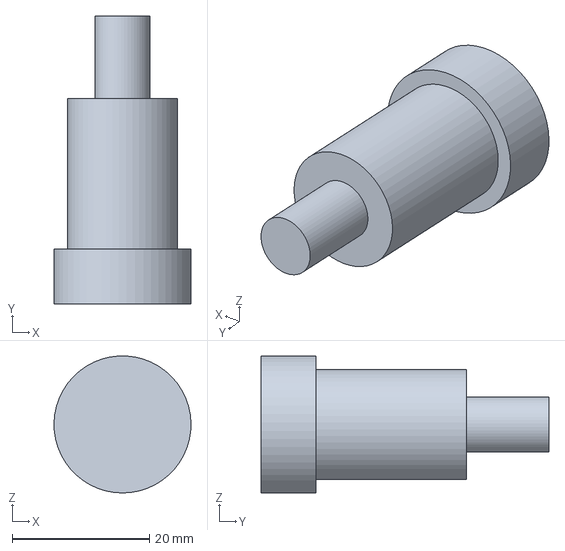
[picture p64: CAD file, 2026-10-22]
CAD Files/Parts/P57_Recline_detent_plunger_Dia8_pin.step
20.0 x 42.0 x 20.0 mm
