Shrey-BM/Convertible-Wheelchair-to-Bed-Transfer-System/CAD Files/Parts/P17_Seat_cheek_plate_8_mm_v2.step

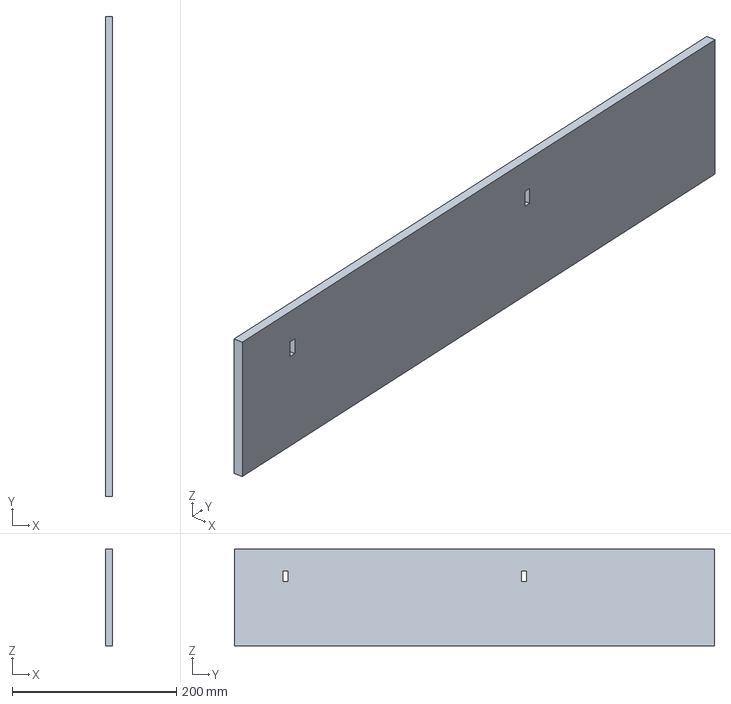
[picture p65: CAD file, 2026-10-22]
CAD Files/Parts/P17_Seat_cheek_plate_8_mm_v2.step
8.00 x 584.0 x 118.0 mm
