Shrey-BM/Convertible-Wheelchair-to-Bed-Transfer-System/CAD Files/Parts/P18_Back_pivot_bracket_8_mm.step

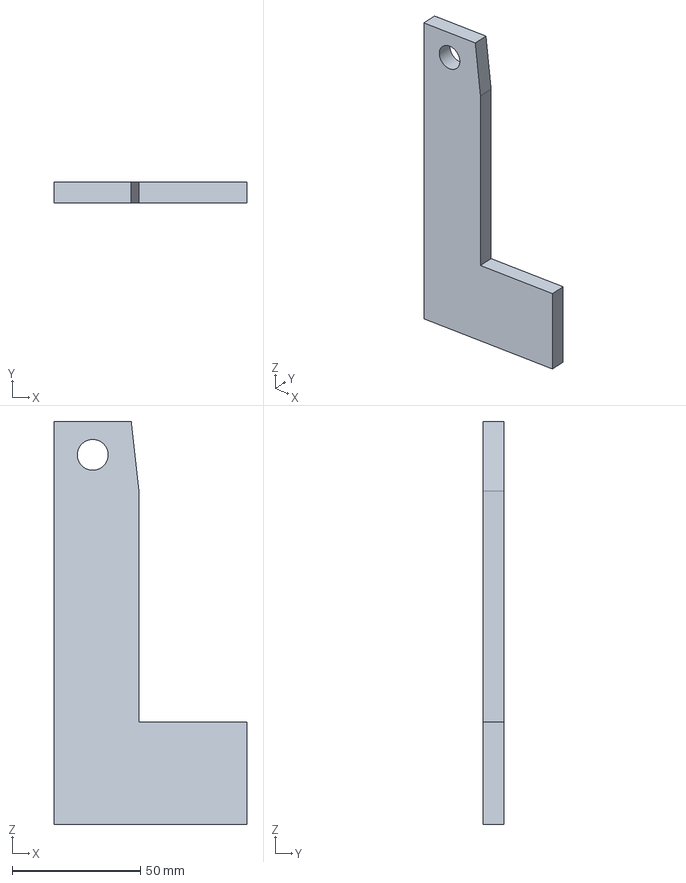
[picture p66: CAD file, 2026-10-22]
CAD Files/Parts/P18_Back_pivot_bracket_8_mm.step
75.0 x 8.00 x 157.0 mm
