Shrey-BM/Convertible-Wheelchair-to-Bed-Transfer-System/CAD Files/Parts/P62_Clamp_F_bar_24x10_knuckle_sleeve.step

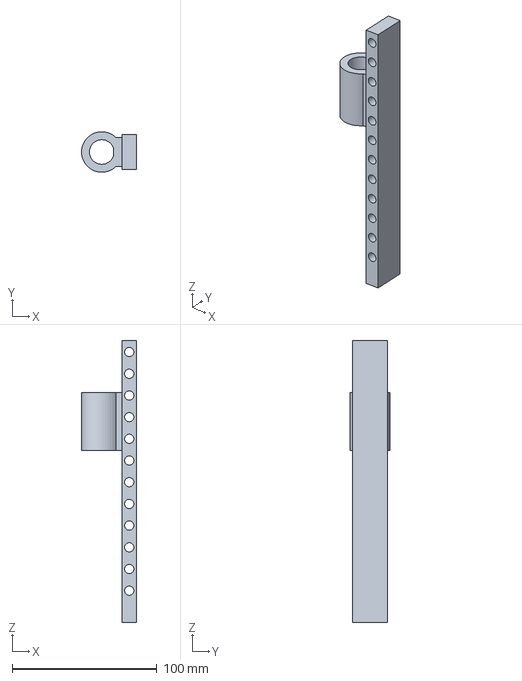
[picture p67: CAD file, 2026-10-22]
CAD Files/Parts/P62_Clamp_F_bar_24x10_knuckle_sleeve.step
38.0 x 28.0 x 195.0 mm
