Shrey-BM/Convertible-Wheelchair-to-Bed-Transfer-System/CAD Files/Parts/P06_Cross_shaft_top_fixed.step

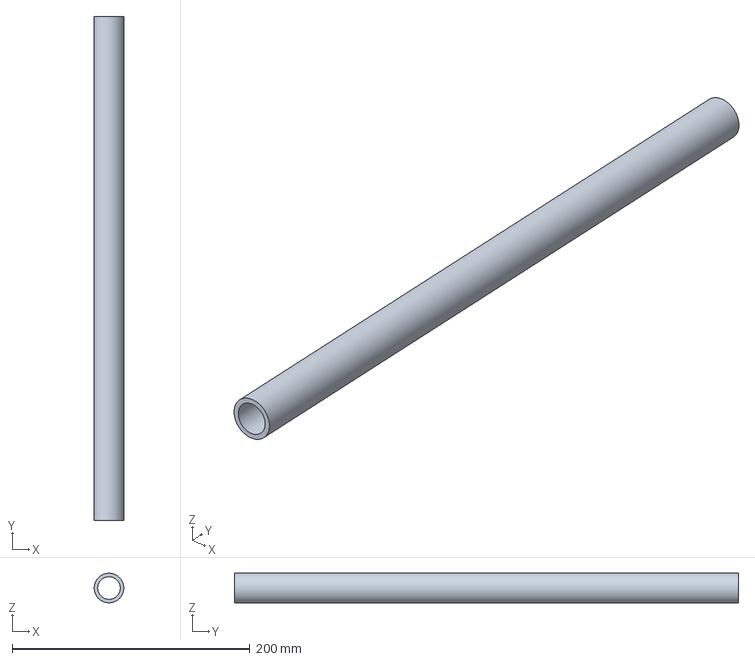
[picture p68: CAD file, 2026-10-22]
CAD Files/Parts/P06_Cross_shaft_top_fixed.step
25.0 x 424.0 x 25.0 mm
