Shrey-BM/Convertible-Wheelchair-to-Bed-Transfer-System/CAD Files/Parts/P28_Conveyor_belt_back_endless_2_mm_PU_polye.step

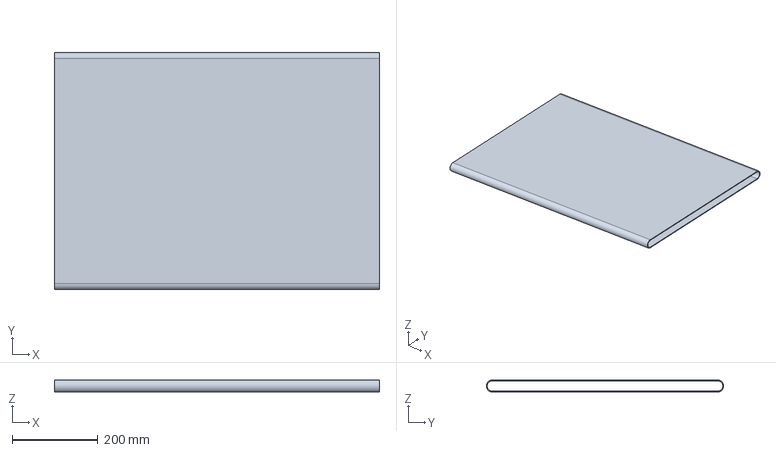
[picture p69: CAD file, 2026-10-22]
CAD Files/Parts/P28_Conveyor_belt_back_endless_2_mm_PU_polye.step
756.0 x 552.0 x 28.0 mm
