Shrey-BM/Convertible-Wheelchair-to-Bed-Transfer-System/CAD Files/Parts/P30_Back_side_rail_40x20x3_RHS_v2.step

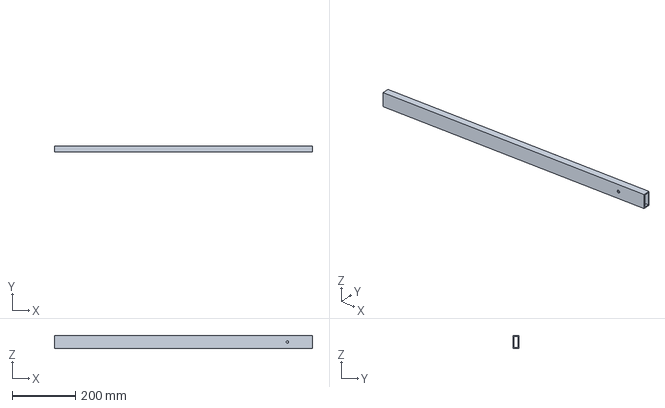
[picture p70: CAD file, 2026-10-22]
CAD Files/Parts/P30_Back_side_rail_40x20x3_RHS_v2.step
818.0 x 20.0 x 40.0 mm
