Shrey-BM/Convertible-Wheelchair-to-Bed-Transfer-System/CAD Files/Parts/P45_Swing_reach_dock_arm_25x25_SHS_L90_M10_l.step

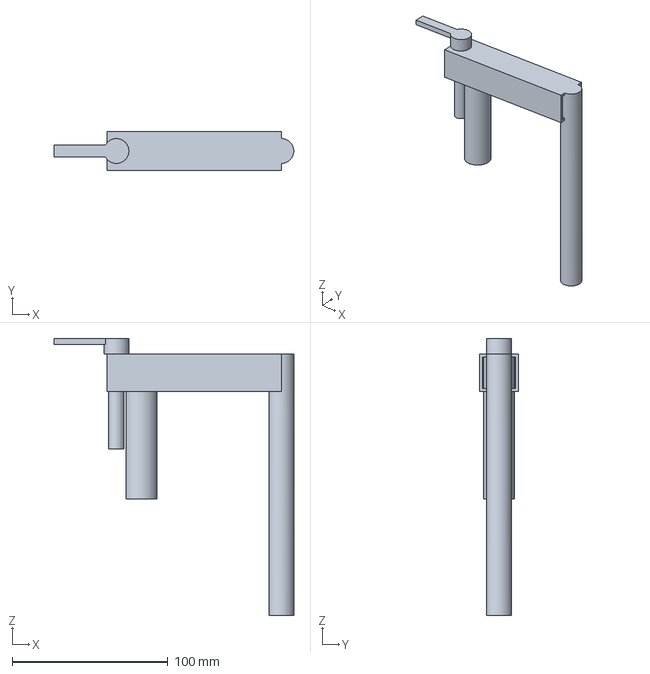
[picture p71: CAD file, 2026-10-22]
CAD Files/Parts/P45_Swing_reach_dock_arm_25x25_SHS_L90_M10_l.step
154.0 x 25.0 x 178.0 mm
