Shrey-BM/Convertible-Wheelchair-to-Bed-Transfer-System/CAD Files/Parts/P69_Transit_lock_post.step

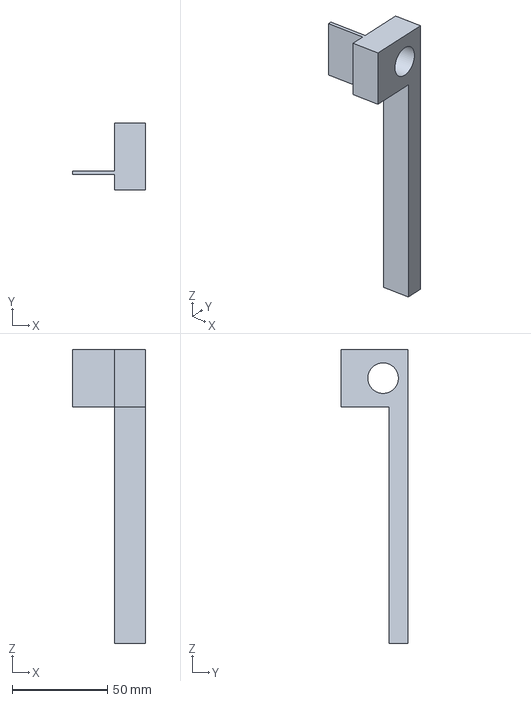
[picture p72: CAD file, 2026-10-22]
CAD Files/Parts/P69_Transit_lock_post.step
38.0 x 35.0 x 154.0 mm
