Shrey-BM/Convertible-Wheelchair-to-Bed-Transfer-System/CAD Files/Parts/P04_Scissor_arm_inner.step

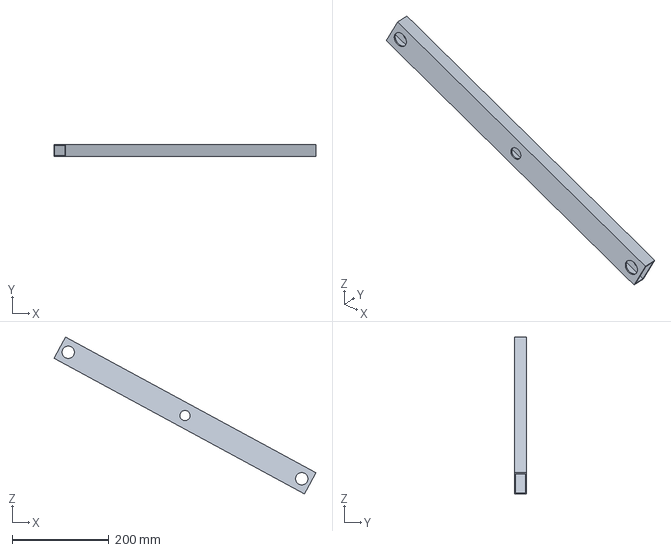
[picture p73: CAD file, 2026-10-22]
CAD Files/Parts/P04_Scissor_arm_inner.step
542.6 x 25.0 x 325.0 mm
