Shrey-BM/Convertible-Wheelchair-to-Bed-Transfer-System/CAD Files/Parts/P42_Lockable_gas_spring_1200_N_stroke_150_ex.step

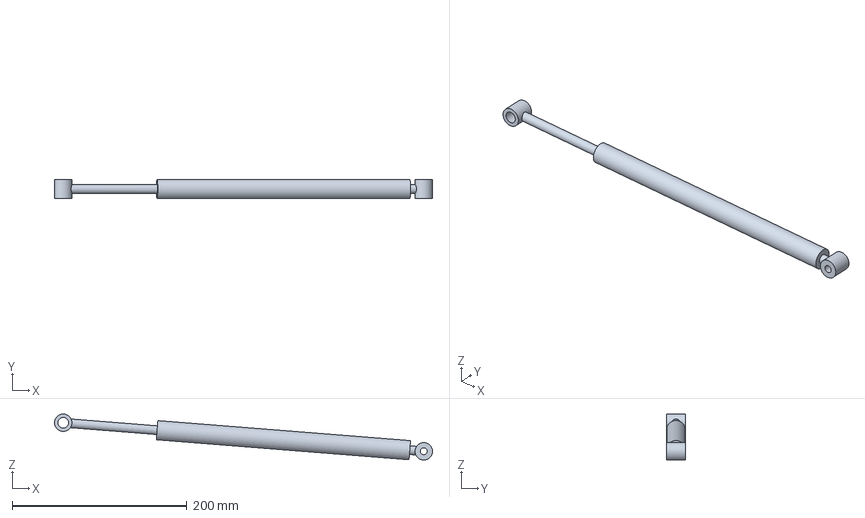
[picture p74: CAD file, 2026-10-22]
CAD Files/Parts/P42_Lockable_gas_spring_1200_N_stroke_150_ex.step
432.4 x 22.0 x 52.6 mm
