Shrey-BM/Convertible-Wheelchair-to-Bed-Transfer-System/CAD Files/Parts/P20A_Linear_guide_carriage_MGN15H_3_mm_spacer.step

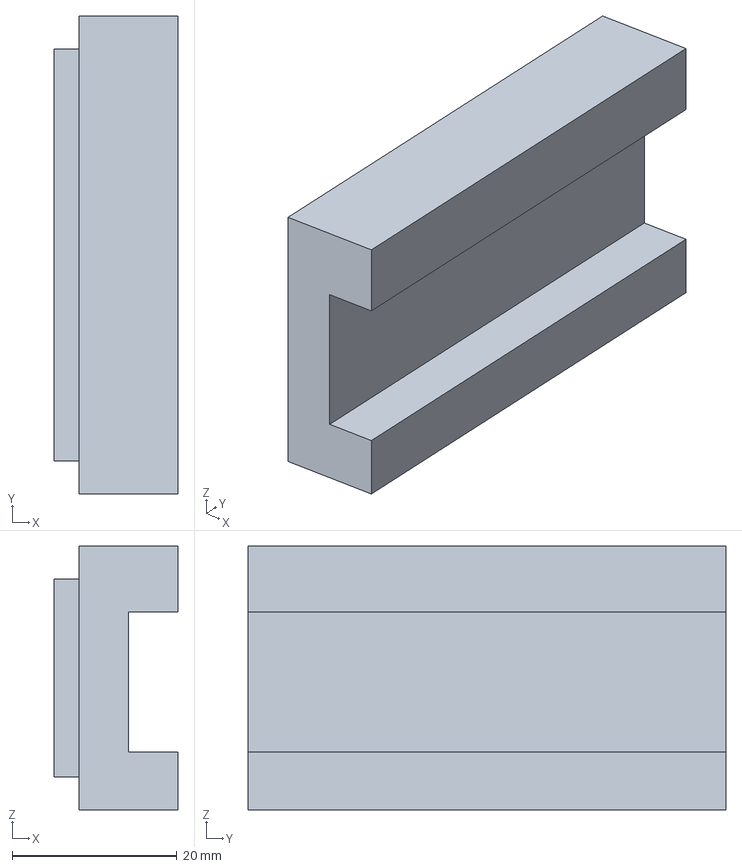
[picture p75: CAD file, 2026-10-22]
CAD Files/Parts/P20A_Linear_guide_carriage_MGN15H_3_mm_spacer.step
15.0 x 58.0 x 32.0 mm
