Shrey-BM/Convertible-Wheelchair-to-Bed-Transfer-System/CAD Files/Parts/P43_Linkage_pins_Dia12_v2.step

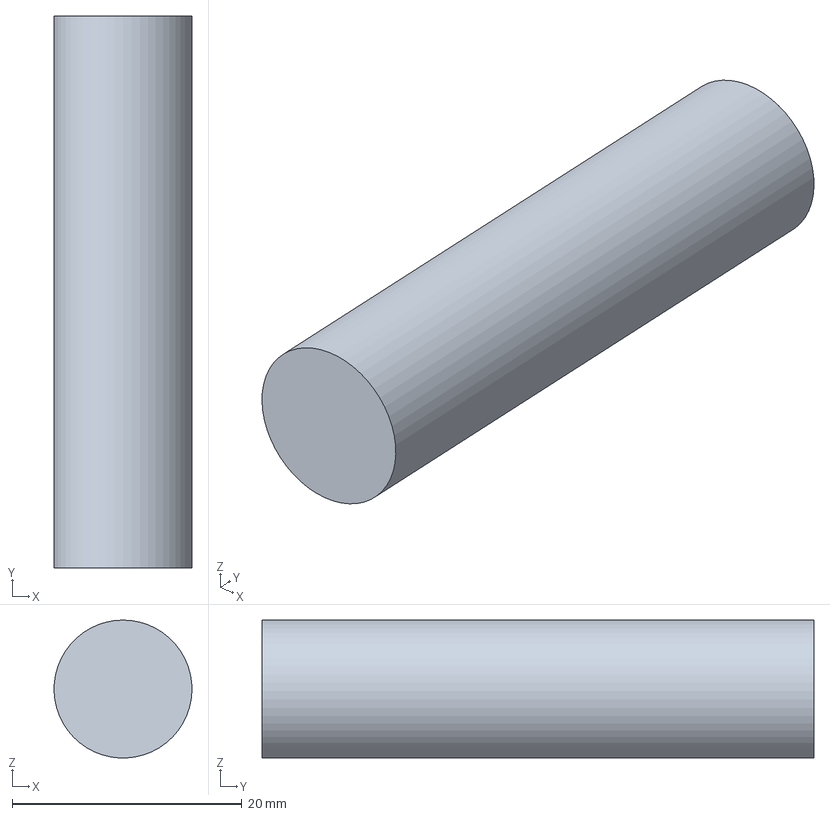
[picture p76: CAD file, 2026-10-22]
CAD Files/Parts/P43_Linkage_pins_Dia12_v2.step
12.0 x 48.0 x 12.0 mm
