Shrey-BM/Convertible-Wheelchair-to-Bed-Transfer-System/CAD Files/Parts/P25_Cassette_board_back.step

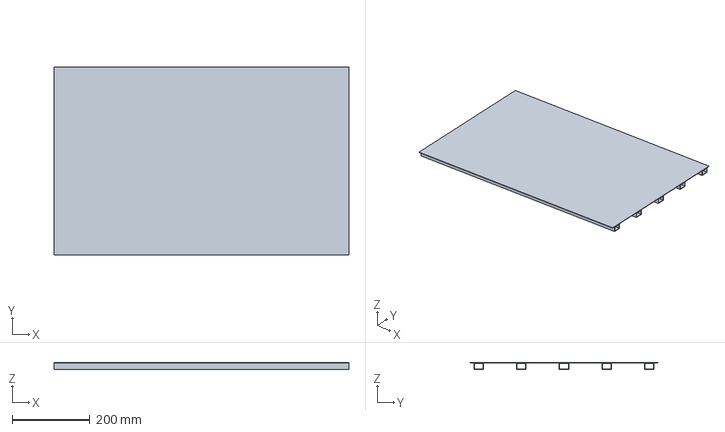
[picture p77: CAD file, 2026-10-22]
CAD Files/Parts/P25_Cassette_board_back.step
760.0 x 484.0 x 17.8 mm
