Shrey-BM/Convertible-Wheelchair-to-Bed-Transfer-System/CAD Files/Parts/P09_Centre_pin_Dia20_circlips.step

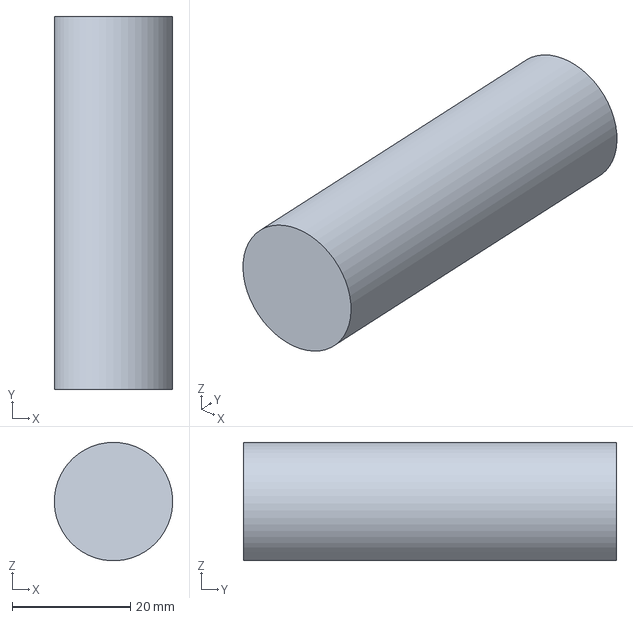
[picture p78: CAD file, 2026-10-22]
CAD Files/Parts/P09_Centre_pin_Dia20_circlips.step
20.0 x 63.0 x 20.0 mm
