Shrey-BM/Convertible-Wheelchair-to-Bed-Transfer-System/CAD Files/Parts/P37_Leg_pivot_plate_8_mm_hinge_connector.step

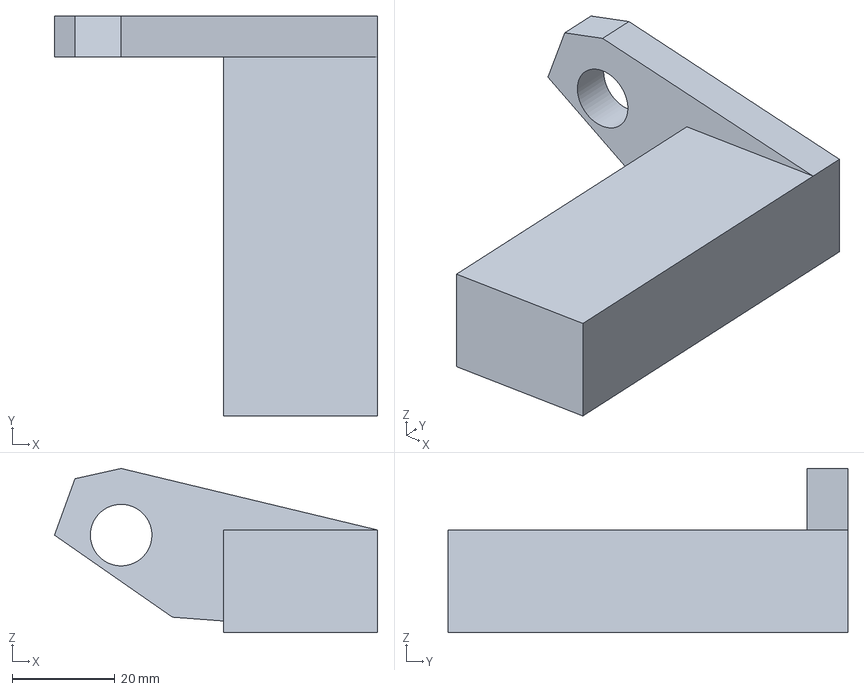
[picture p79: CAD file, 2026-10-22]
CAD Files/Parts/P37_Leg_pivot_plate_8_mm_hinge_connector.step
63.0 x 78.0 x 32.0 mm
