Shrey-BM/Convertible-Wheelchair-to-Bed-Transfer-System/CAD Files/Parts/P54_Bar_storage_clip.step

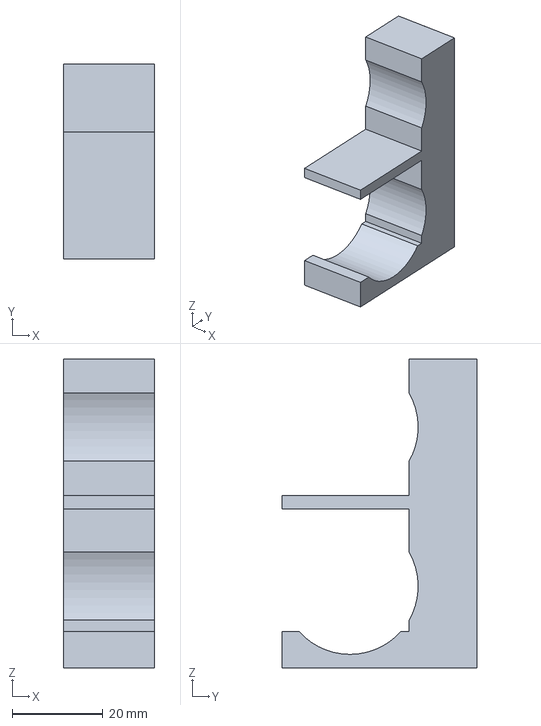
[picture p80: CAD file, 2026-10-22]
CAD Files/Parts/P54_Bar_storage_clip.step
20.0 x 43.0 x 68.0 mm
