Shrey-BM/Convertible-Wheelchair-to-Bed-Transfer-System/CAD Files/Parts/P41_Tie_rod_25x8_flat_c_c_482.step

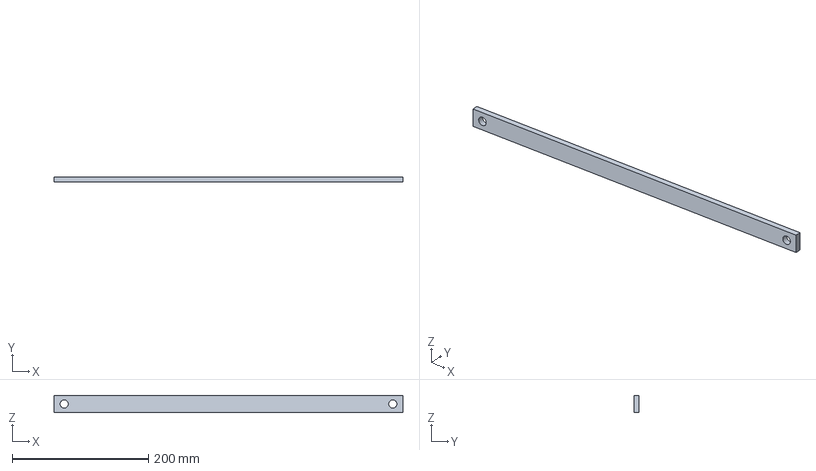
[picture p81: CAD file, 2026-10-22]
CAD Files/Parts/P41_Tie_rod_25x8_flat_c_c_482.step
512.0 x 8.00 x 25.0 mm
