Shrey-BM/Convertible-Wheelchair-to-Bed-Transfer-System/CAD Files/Parts/P44_Transfer_bar_half_Dia30_x_675.step

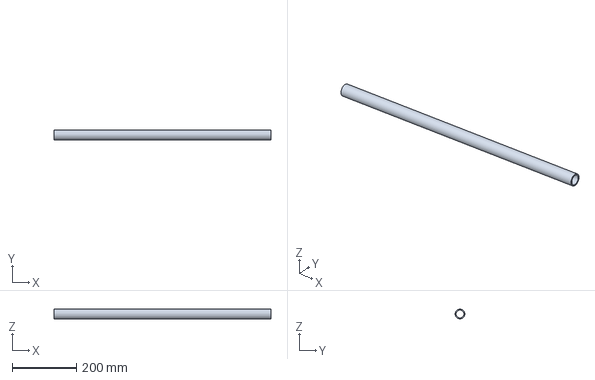
[picture p82: CAD file, 2026-10-22]
CAD Files/Parts/P44_Transfer_bar_half_Dia30_x_675.step
675.0 x 30.0 x 30.0 mm
