Shrey-BM/Convertible-Wheelchair-to-Bed-Transfer-System/CAD Files/Parts/P36_Leg_side_tube_20x20x1_5.step

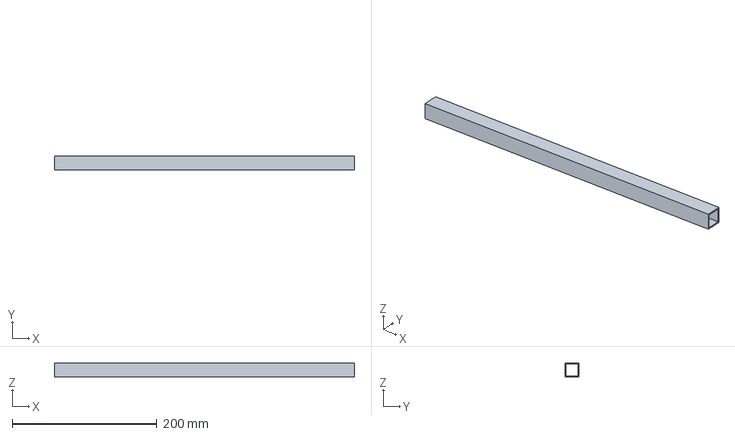
[picture p83: CAD file, 2026-10-22]
CAD Files/Parts/P36_Leg_side_tube_20x20x1_5.step
415.0 x 20.0 x 20.0 mm
