Shrey-BM/Convertible-Wheelchair-to-Bed-Transfer-System/CAD Files/Parts/P50_Rack_guide_pins_Dia5.step

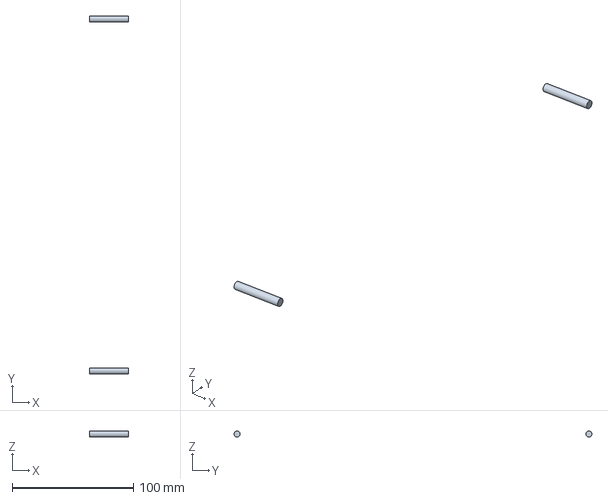
[picture p84: CAD file, 2026-10-22]
CAD Files/Parts/P50_Rack_guide_pins_Dia5.step
32.0 x 295.0 x 5.00 mm
