Shrey-BM/Convertible-Wheelchair-to-Bed-Transfer-System/CAD Files/Parts/P52_Slider_keepers.step

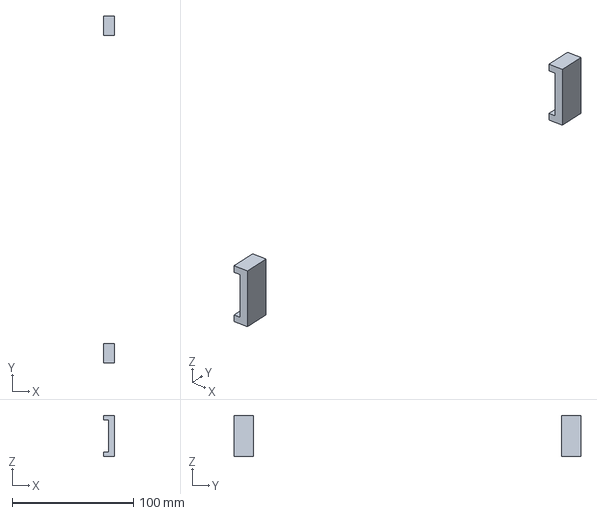
[picture p85: CAD file, 2026-10-22]
CAD Files/Parts/P52_Slider_keepers.step
9.00 x 286.0 x 34.0 mm
