Shrey-BM/Convertible-Wheelchair-to-Bed-Transfer-System/CAD Files/Parts/P40_Bridge_flap_130_mm_folds_over_pad.step

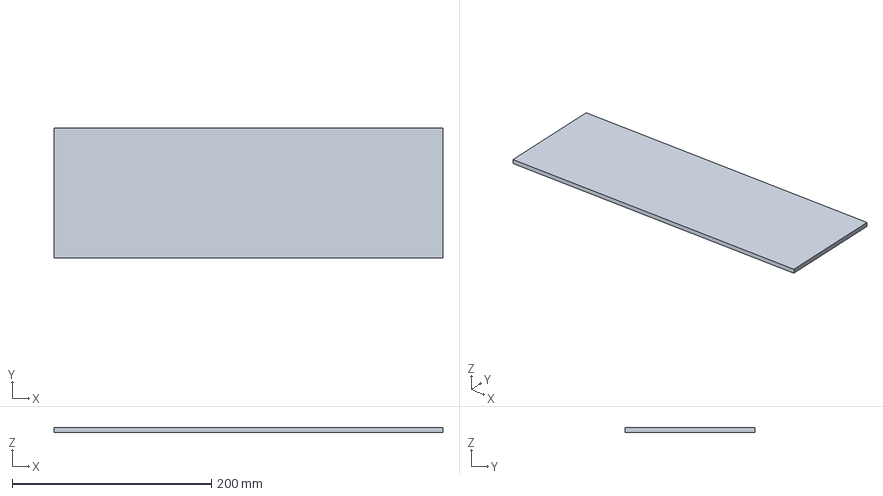
[picture p86: CAD file, 2026-10-22]
CAD Files/Parts/P40_Bridge_flap_130_mm_folds_over_pad.step
390.0 x 130.0 x 5.00 mm
