Shrey-BM/Convertible-Wheelchair-to-Bed-Transfer-System/CAD Files/Parts/P11_Lift_top_frame_weldment.step

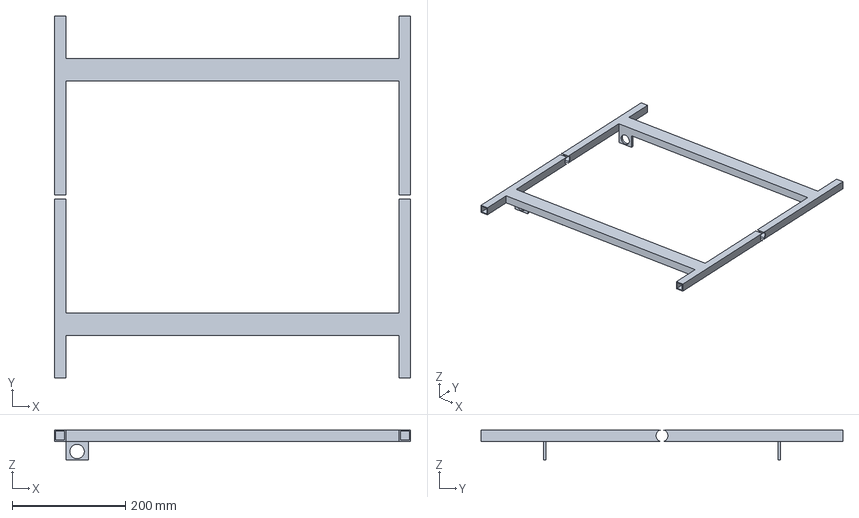
[picture p88: CAD file, 2026-10-22]
CAD Files/Parts/P11_Lift_top_frame_weldment.step
630.0 x 640.0 x 53.0 mm
