Shrey-BM/Convertible-Wheelchair-to-Bed-Transfer-System/CAD Files/Parts/P10_Track_roller_2_x_6202_2RS_bearings.step

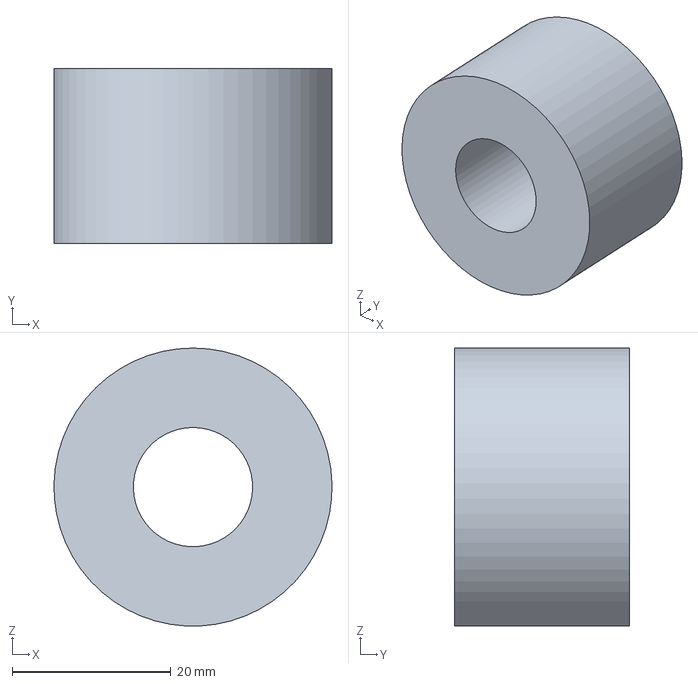
[picture p89: CAD file, 2026-10-22]
CAD Files/Parts/P10_Track_roller_2_x_6202_2RS_bearings.step
35.0 x 22.0 x 35.0 mm
