Shrey-BM/Convertible-Wheelchair-to-Bed-Transfer-System/CAD Files/Parts/P43_Linkage_pins_Dia12.step

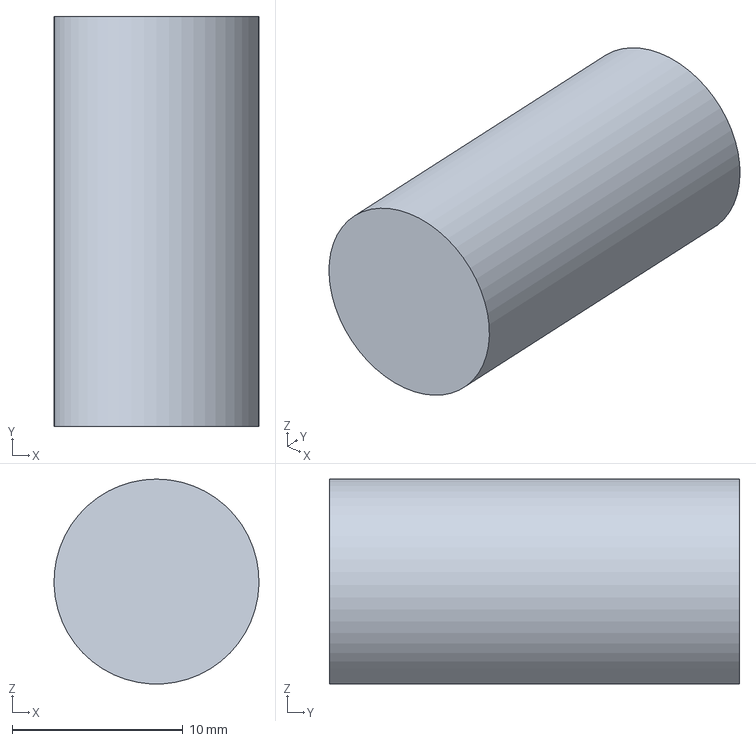
[picture p90: CAD file, 2026-10-22]
CAD Files/Parts/P43_Linkage_pins_Dia12.step
12.0 x 24.0 x 12.0 mm
