Shrey-BM/Convertible-Wheelchair-to-Bed-Transfer-System/CAD Files/Parts/P15_Folding_crank_handle_R120.step

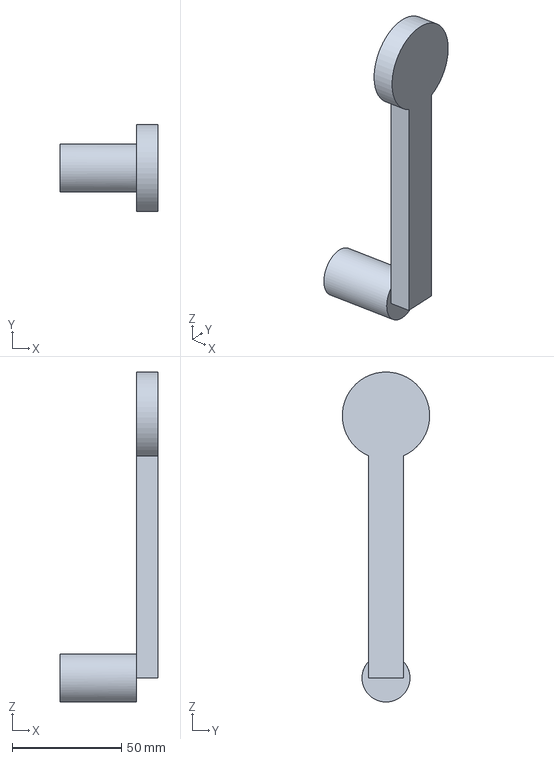
[picture p91: CAD file, 2026-10-22]
CAD Files/Parts/P15_Folding_crank_handle_R120.step
45.0 x 40.0 x 151.0 mm
