Shrey-BM/Convertible-Wheelchair-to-Bed-Transfer-System/CAD Files/Parts/P39_Flip_footplate.step

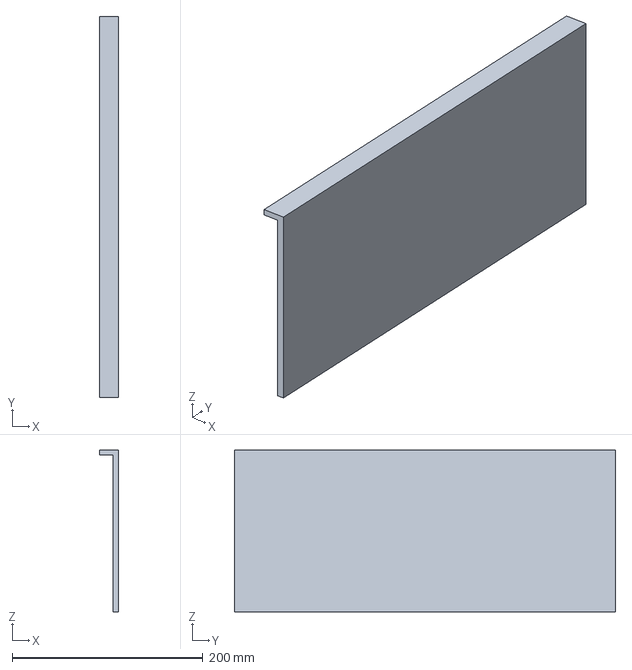
[picture p92: CAD file, 2026-10-22]
CAD Files/Parts/P39_Flip_footplate.step
20.0 x 400.0 x 170.0 mm
