Shrey-BM/Convertible-Wheelchair-to-Bed-Transfer-System/CAD Files/Parts/P35_Leg_pad_15_mm.step

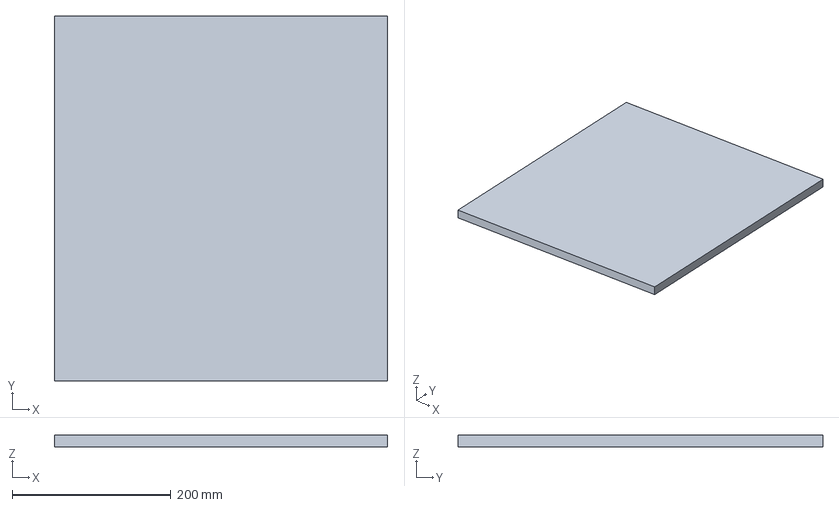
[picture p94: CAD file, 2026-10-22]
CAD Files/Parts/P35_Leg_pad_15_mm.step
420.0 x 460.0 x 15.0 mm
