Shrey-BM/Convertible-Wheelchair-to-Bed-Transfer-System/CAD Files/Parts/P46_Removable_armrest.step

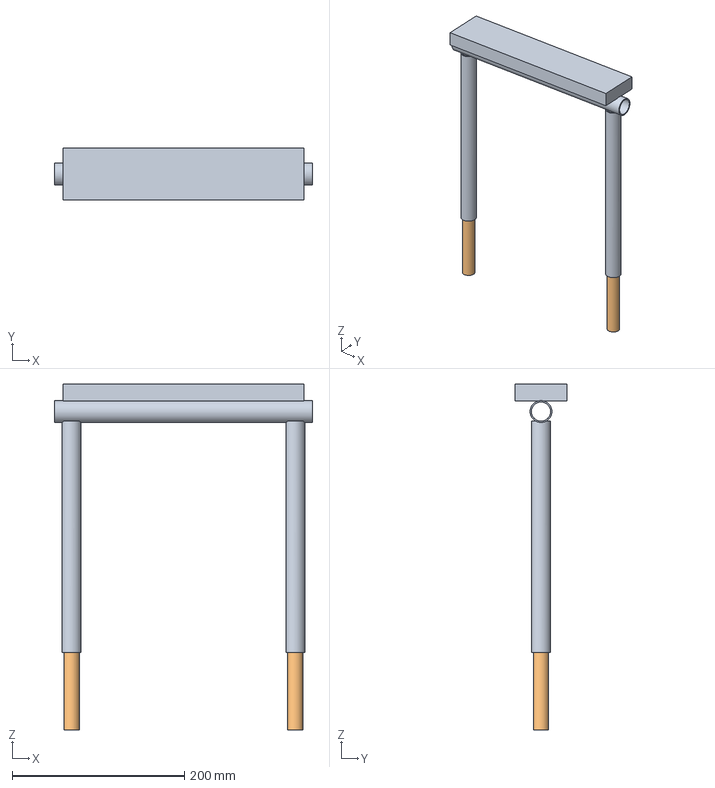
[picture p95: CAD file, 2026-10-22]
CAD Files/Parts/P46_Removable_armrest.step
300.0 x 60.0 x 402.0 mm
