Shrey-BM/Convertible-Wheelchair-to-Bed-Transfer-System/CAD Files/Parts/P26_Cassette_end_plate_6_mm.step

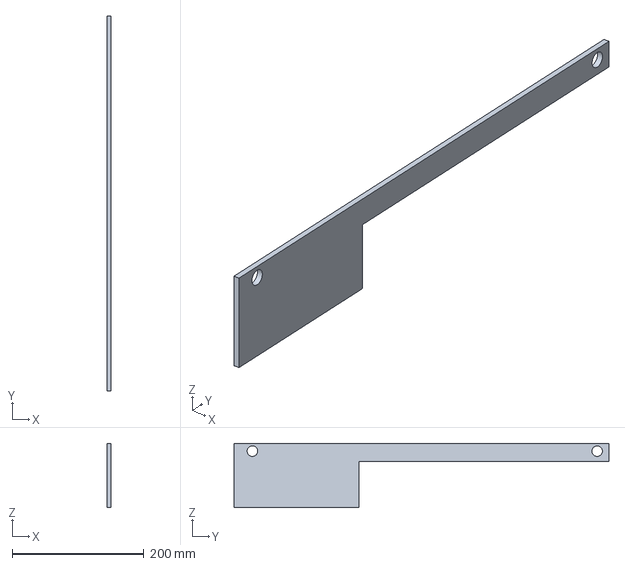
[picture p96: CAD file, 2026-10-22]
CAD Files/Parts/P26_Cassette_end_plate_6_mm.step
6.00 x 570.0 x 98.0 mm
