Shrey-BM/Convertible-Wheelchair-to-Bed-Transfer-System/CAD Files/Parts/P18_Back_pivot_bracket_8_mm_v2.step

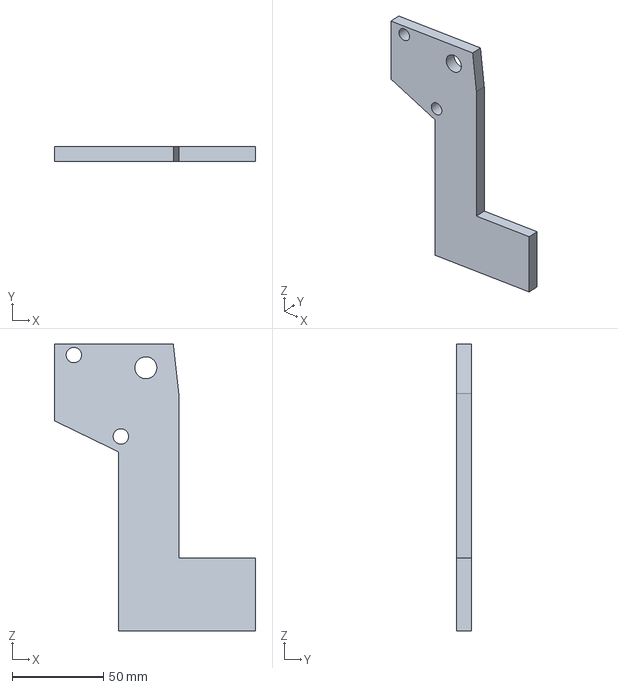
[picture p97: CAD file, 2026-10-22]
CAD Files/Parts/P18_Back_pivot_bracket_8_mm_v2.step
110.0 x 8.00 x 157.0 mm
