Shrey-BM/Convertible-Wheelchair-to-Bed-Transfer-System/CAD Files/Parts/P64_Lower_jaw_sliding_on_F_bar_index_pin.step

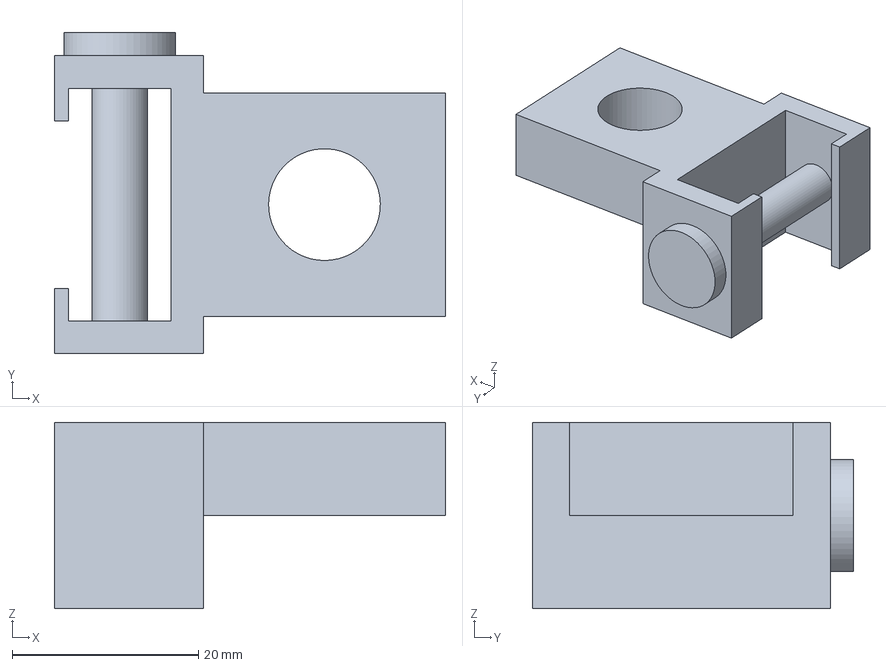
[picture p98: CAD file, 2026-10-22]
CAD Files/Parts/P64_Lower_jaw_sliding_on_F_bar_index_pin.step
42.0 x 34.5 x 20.0 mm
