Shrey-BM/Convertible-Wheelchair-to-Bed-Transfer-System/CAD Files/Parts/P38_Leg_crank_arm_R110.step

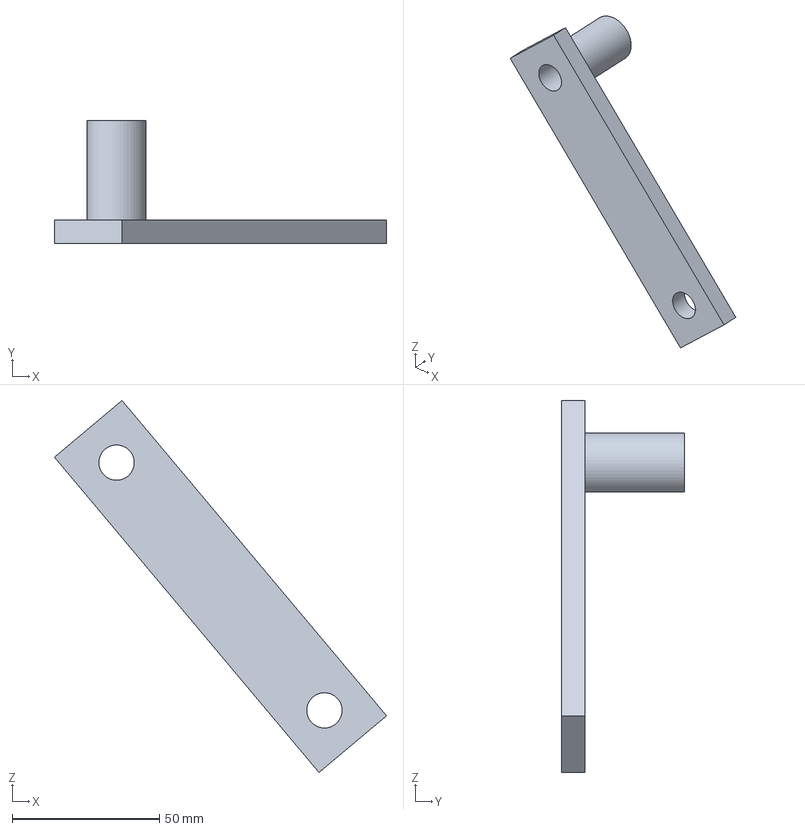
[picture p99: CAD file, 2026-10-22]
CAD Files/Parts/P38_Leg_crank_arm_R110.step
113.0 x 42.0 x 126.5 mm
