Shrey-BM/Convertible-Wheelchair-to-Bed-Transfer-System/CAD Files/Parts/P58_Bar_clip_on_bracket.step

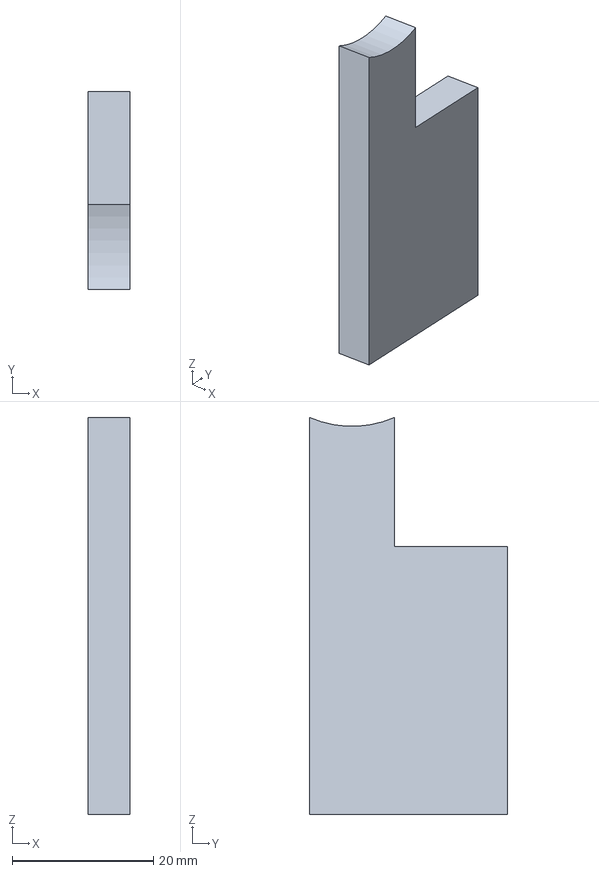
[picture p100: CAD file, 2026-10-22]
CAD Files/Parts/P58_Bar_clip_on_bracket.step
6.00 x 28.0 x 56.3 mm
