Shrey-BM/Convertible-Wheelchair-to-Bed-Transfer-System/CAD Files/Parts/P49_Head_end_grip_bar_Dia25.step

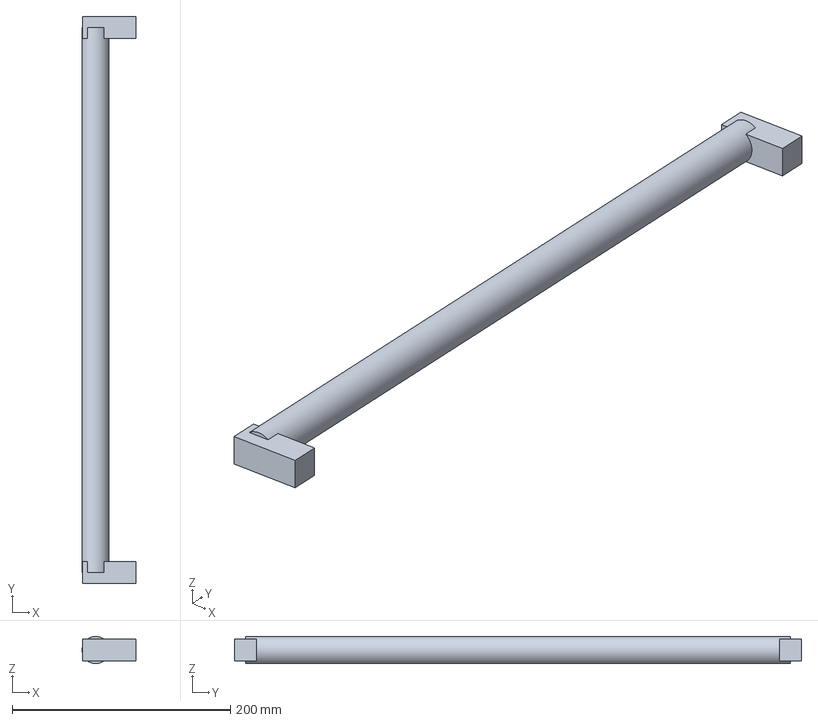
[picture p101: CAD file, 2026-10-22]
CAD Files/Parts/P49_Head_end_grip_bar_Dia25.step
49.5 x 520.0 x 25.0 mm
