Shrey-BM/Convertible-Wheelchair-to-Bed-Transfer-System/CAD Files/Parts/P27_Belt_roller_Dia24_x_756_Dia8_stub_axles.step

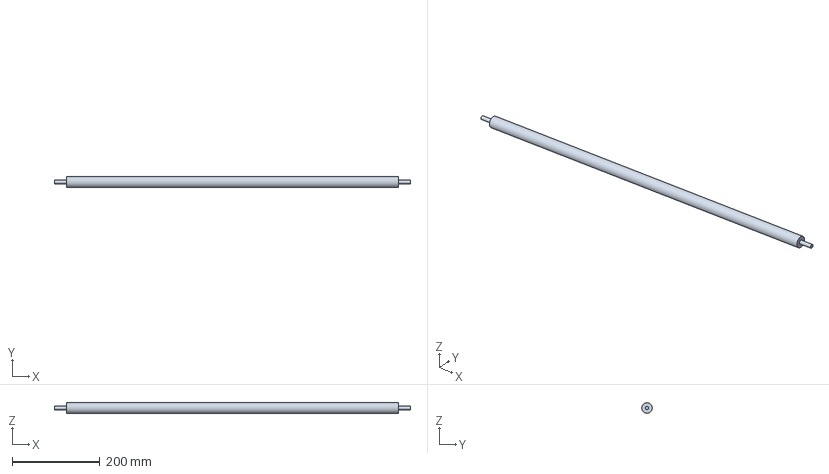
[picture p102: CAD file, 2026-10-22]
CAD Files/Parts/P27_Belt_roller_Dia24_x_756_Dia8_stub_axles.step
810.0 x 24.0 x 24.0 mm
