Shrey-BM/Convertible-Wheelchair-to-Bed-Transfer-System/(list of files, cad)

Other CAD files:
CAD Files/Parts/P08_Cross_shaft_bottom_sliding_roller_stubs.step
CAD Files/Parts/P31_Back_cheek_plate_8_mm.step
CAD Files/Parts/P17_Seat_cheek_plate_8_mm.step
CAD Files/Parts/P07_Cross_shaft_bottom_fixed.step
CAD Files/Parts/P30_Back_side_rail_40x20x3_RHS.step
CAD Files/Parts/P03_Scissor_arm_outer.step
CAD Files/Parts/P31_Back_cheek_plate_8_mm_v2.step
CAD Files/Parts/P12_Lead_screw_Tr20x4.step
CAD Files/Parts/P13_Nut_block_Tr20x4.step
CAD Files/Parts/P43_Pivot_pin_Dia12_shoulder_bolt.step
CAD Files/Parts/P43_Pivot_pin_Dia12_shoulder_bolt_v2.step
CAD Files/Parts/P56_Clamp_T_screw_M12_swivel_pad.step
CAD Files/Parts/P59_Dock_arm_pivot_lug_friction_disc_bolted_.step
CAD Files/Parts/P66_Upper_jaw_pressure_screw_M10_pad.step
