Shrey-BM/Convertible-Wheelchair-to-Bed-Transfer-System/(commit log)

2026-10-18 Create CAD
2026-10-18 Create Materials and Target Specs
2026-10-18 Create BOM
2026-10-23 Added the BOM!!
